z00m128/kay1024/firmware/power-manager/fixed/sources/read_me.txt

Небольшой фикс прошивки KAY Power Manager.

Я нашел и вроде, локализовал проблему, когда иногда комп вырубался сразу, а не после определенной
задержки (~4 сек.). Так же, нашел причину нек. не стабильности в работе этого узла.
Обращаю внимание на уточненные номиналы резисторов R90...R92(см. обновленную схему):
R90, R91 - 470 Ом ... 680 Ом
R92 - 2,2 кОм ... 3,3 кОм
