z00m128/kay1024/firmware/power-manager/original/hex/read_me.txt

Краткое описание прошивок

default.hex   - время ожидания Pwr_OK при включении - 350 мс, выкл. - удержание кнопки ~3,5 сек

default2.hex  - время ожидания Pwr_OK при включении - 500 мс, выкл. - удержание кнопки ~3,5 сек

ext_350_2.hex - время ожидания Pwr_OK при включении - 350 мс, выкл. - удержание кнопки ~2 сек

ext_500_2.hex - время ожидания Pwr_OK при включении - 500 мс, выкл. - удержание кнопки ~2 сек
