z00m128/kay1024/schematic-diagram/kay1024_schematic_black_cat.png

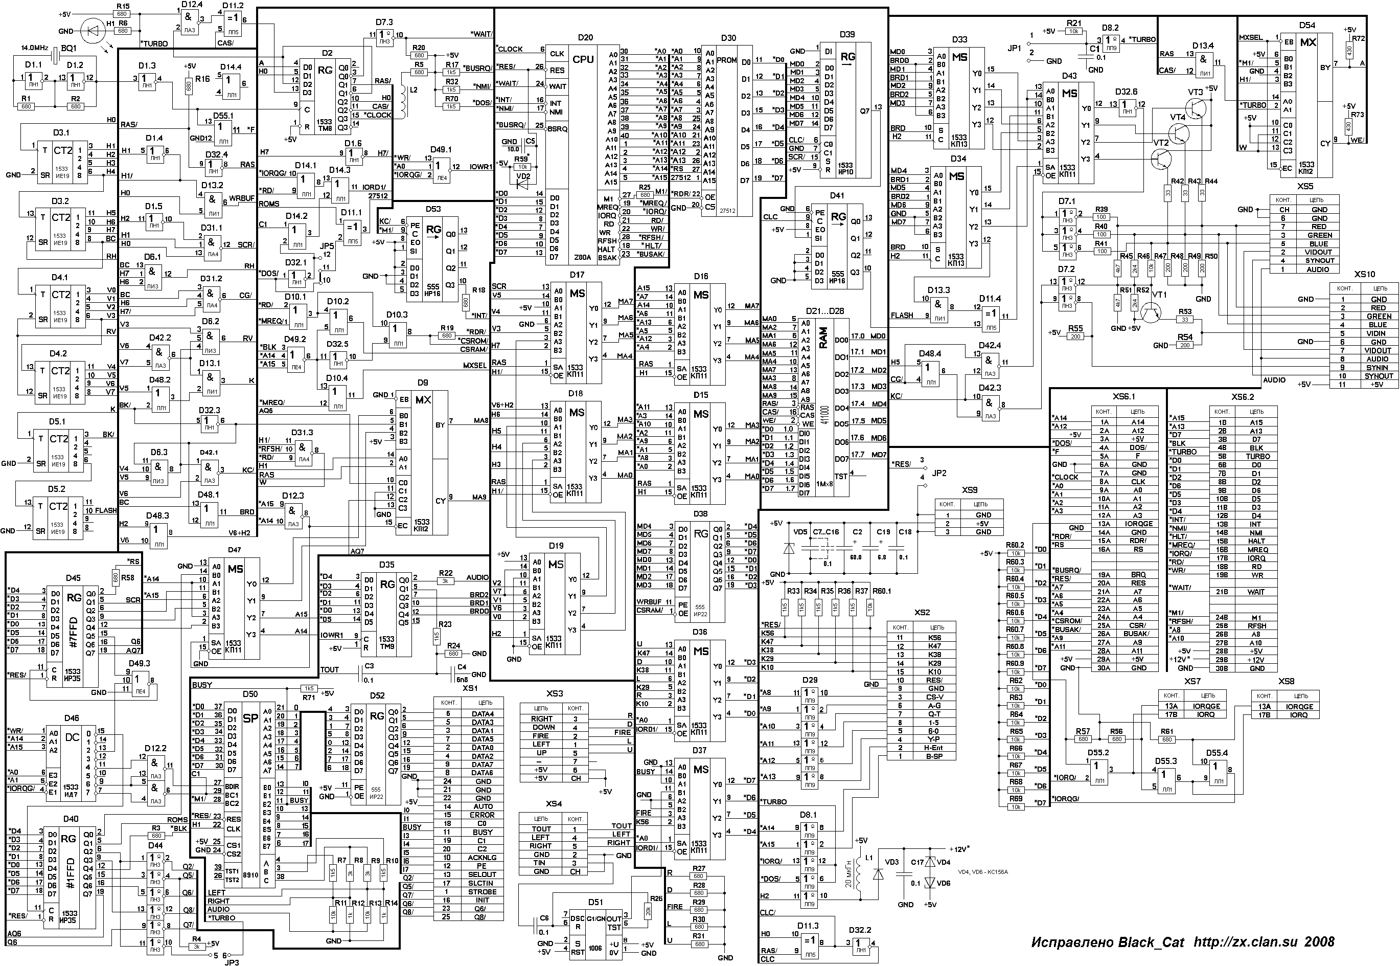
schematic-diagram/kay1024_schematic_black_cat.png
