z00m128/kay1024/schematic-diagram/kay1024_schematic_zan.png

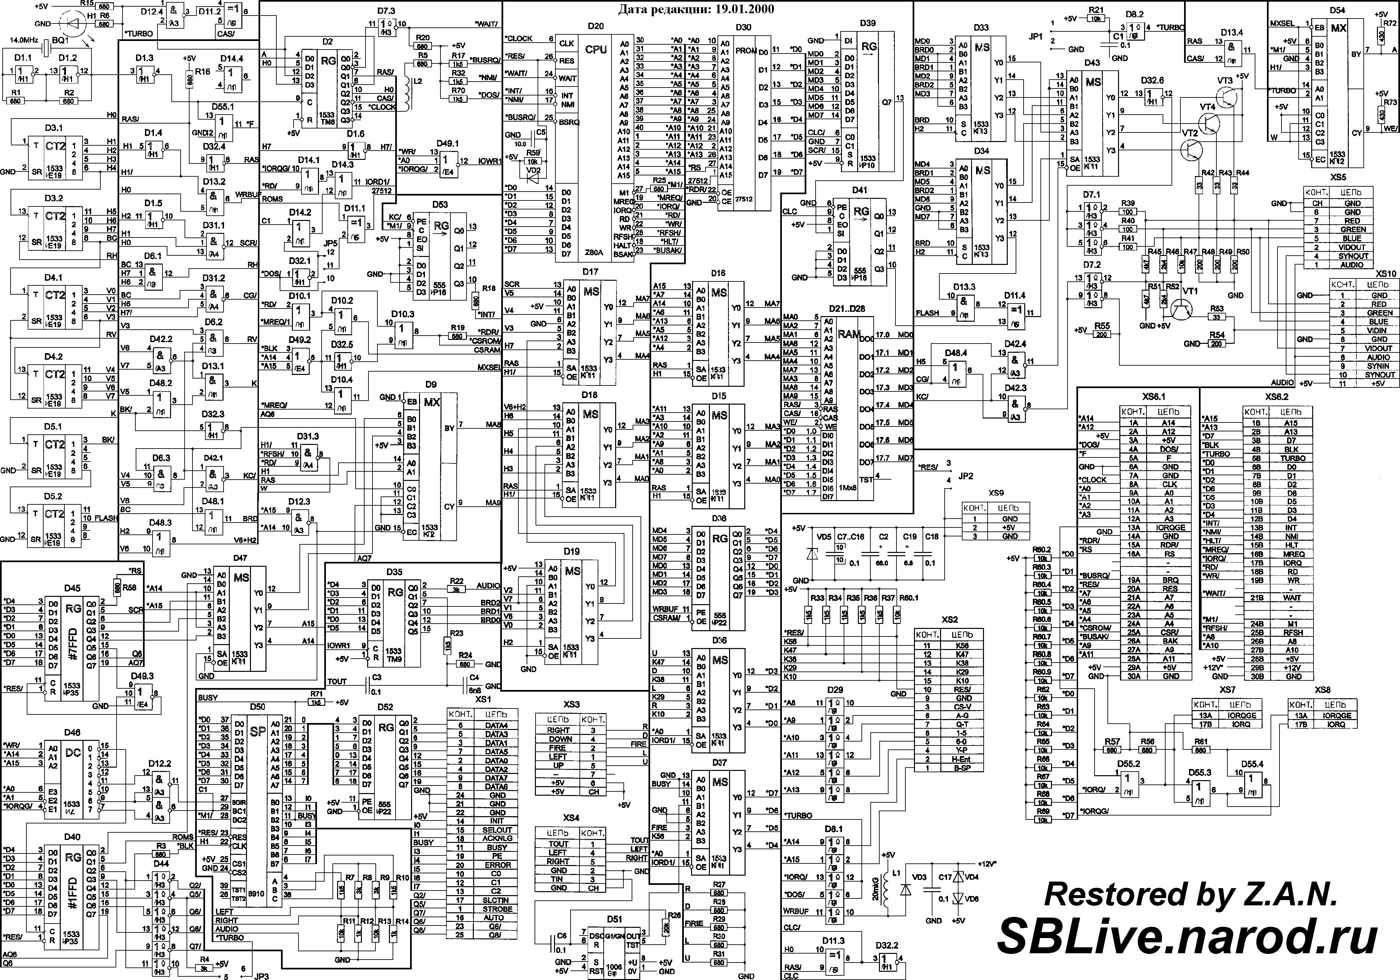
schematic-diagram/kay1024_schematic_zan.png
