z00m128/kay1024/docs/kay10243sl_manual.pdf

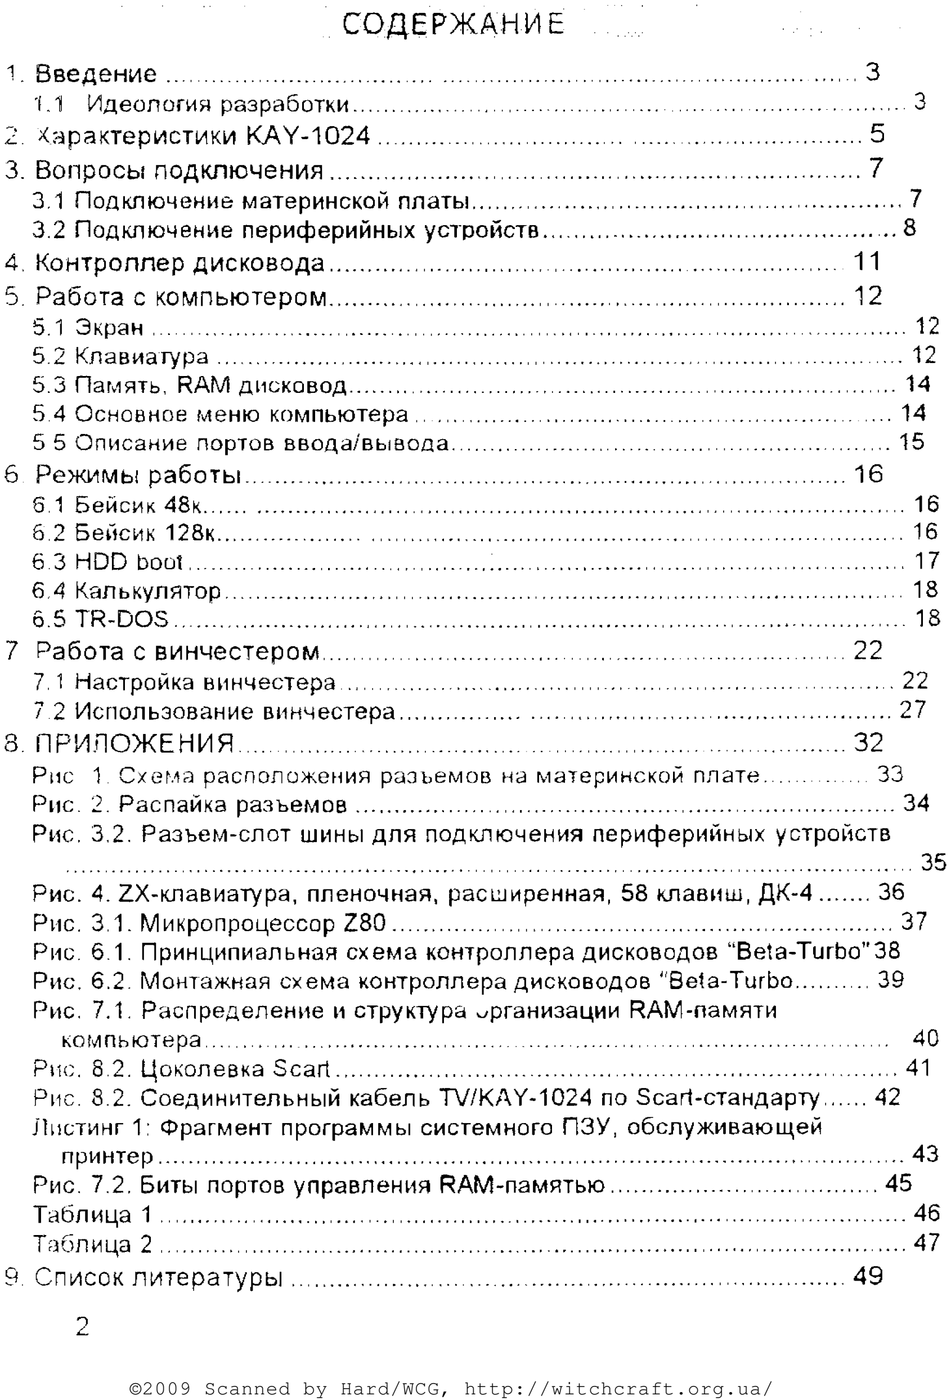
[picture p3: page 1]

©2009 Scanned by Hard/WCG, http://witchcraft.org.ua/

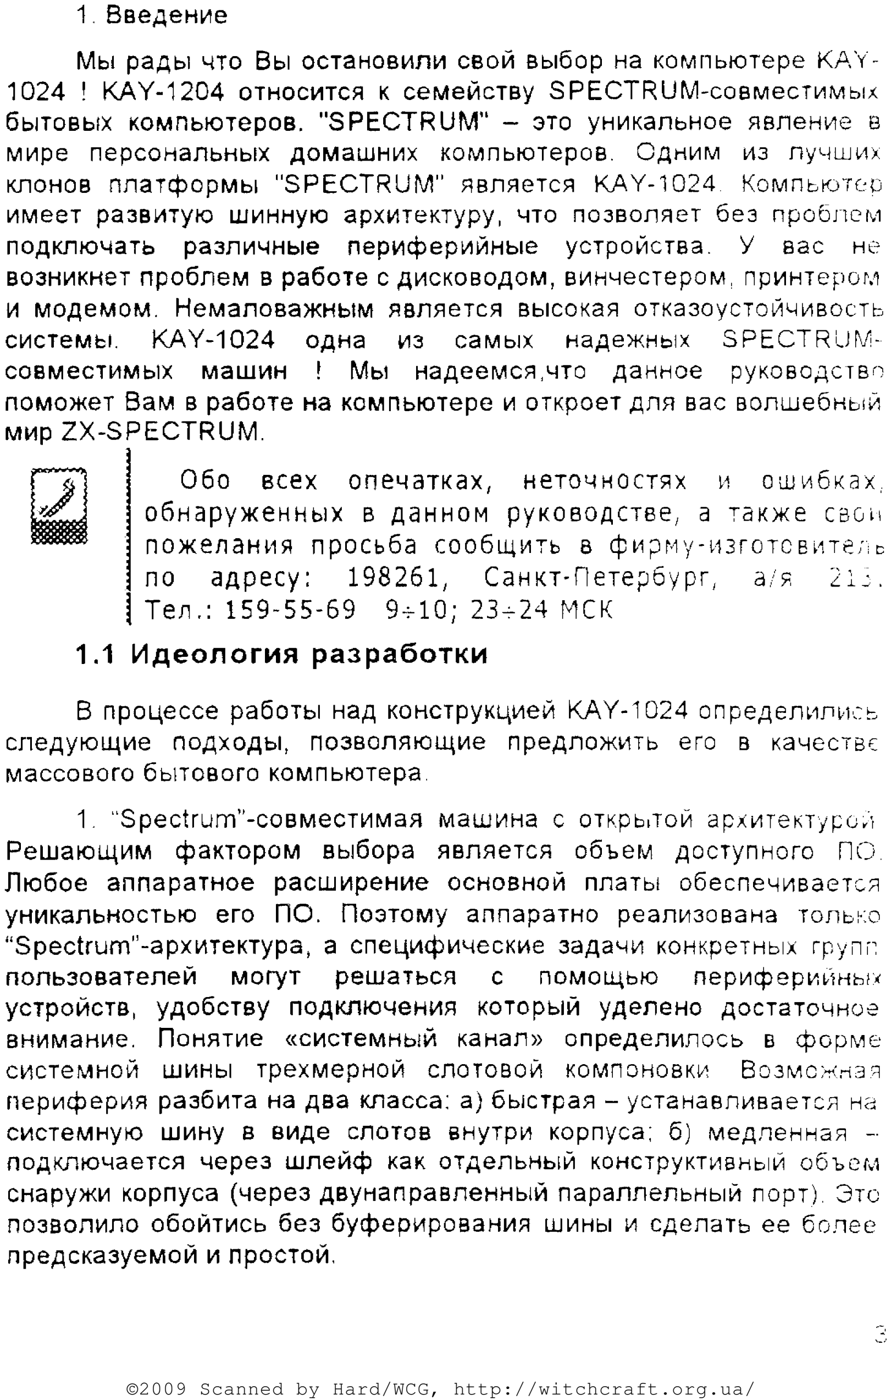
[picture p4: page 2]
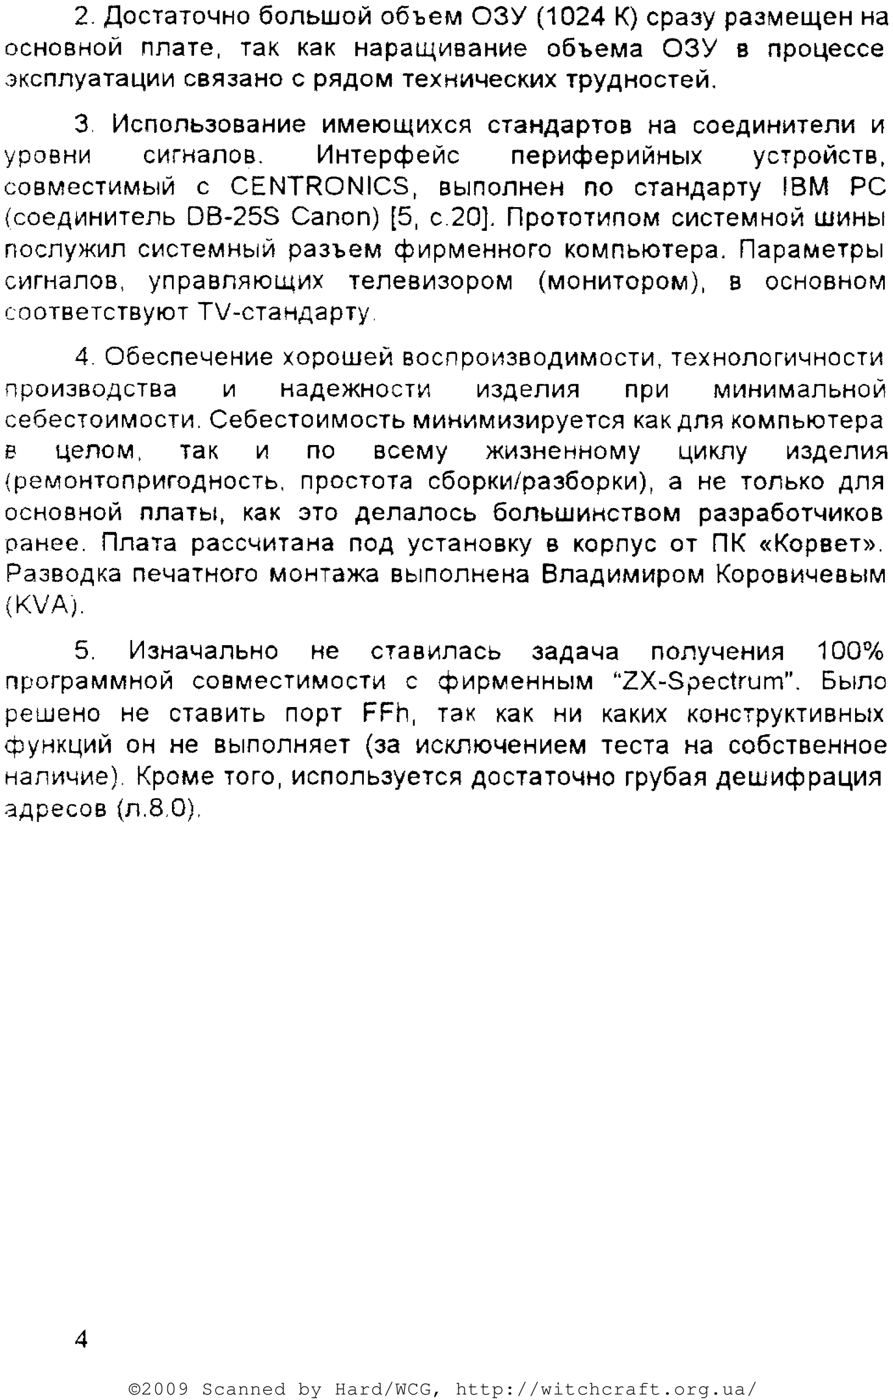
[picture p5: page 3]
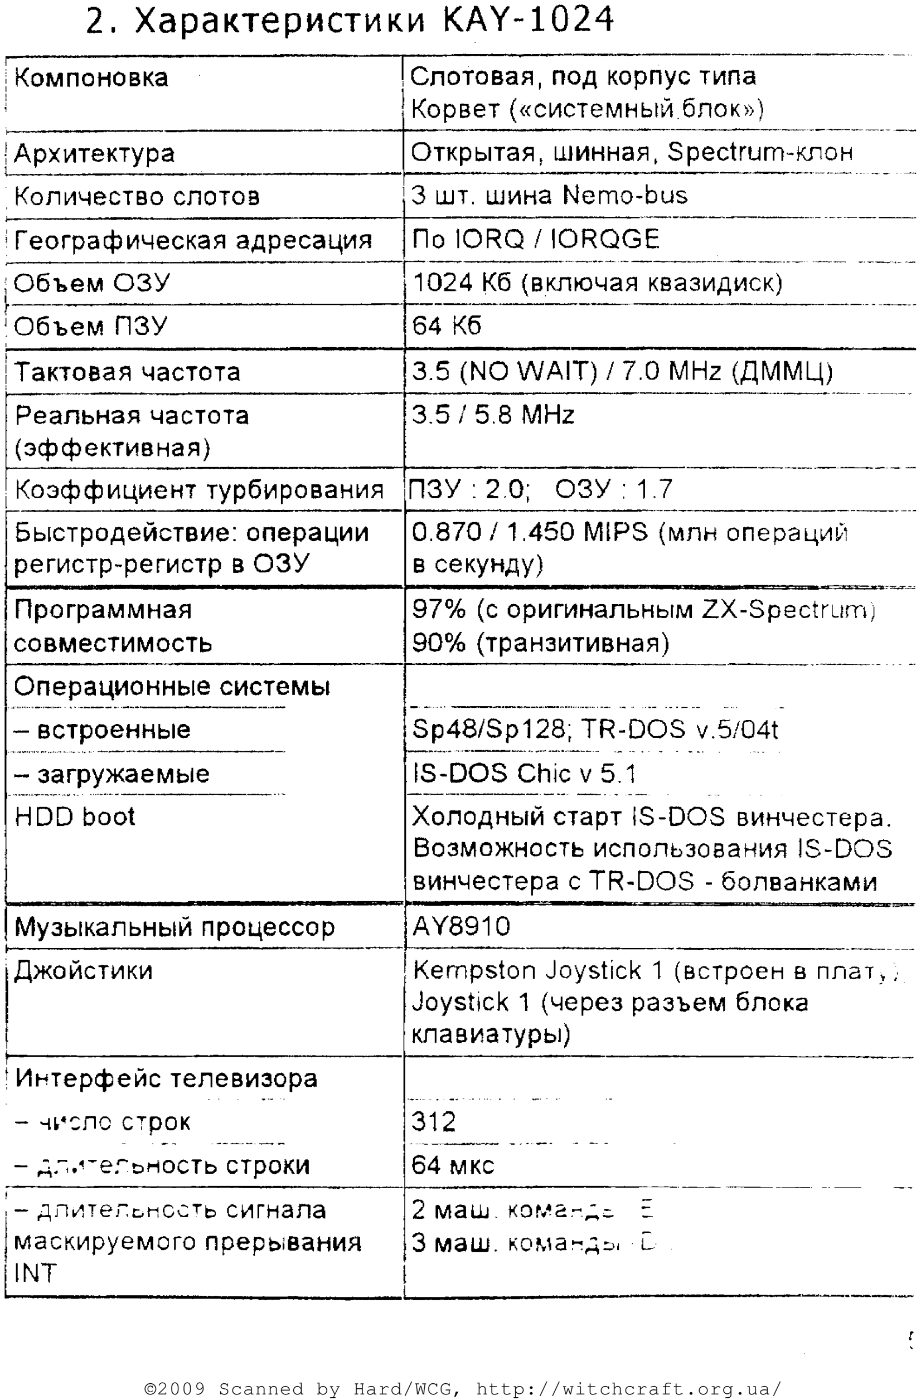
[picture p6: page 4]
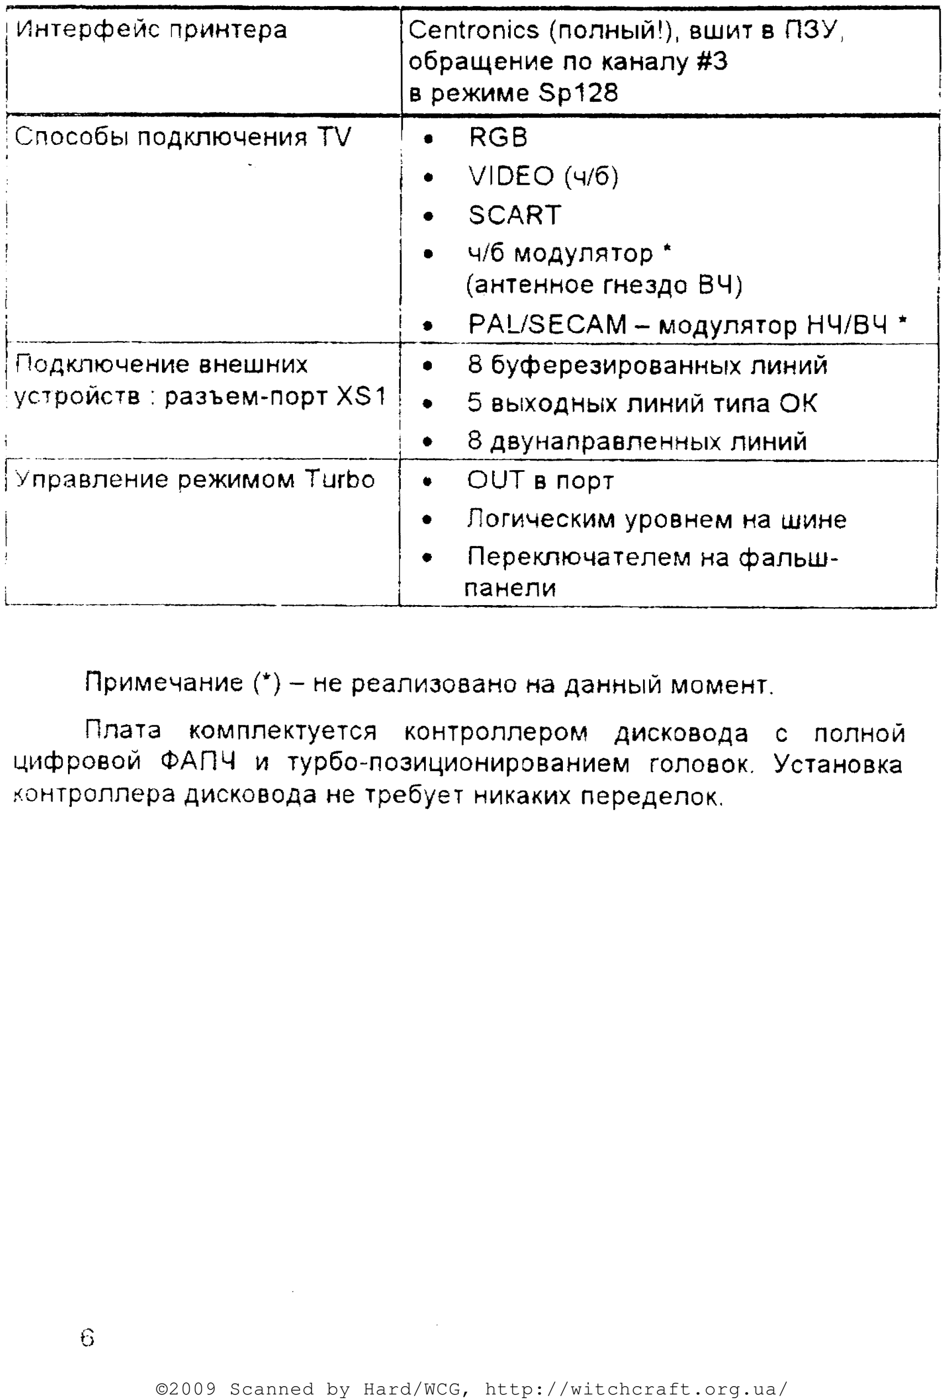
[picture p7: page 5]
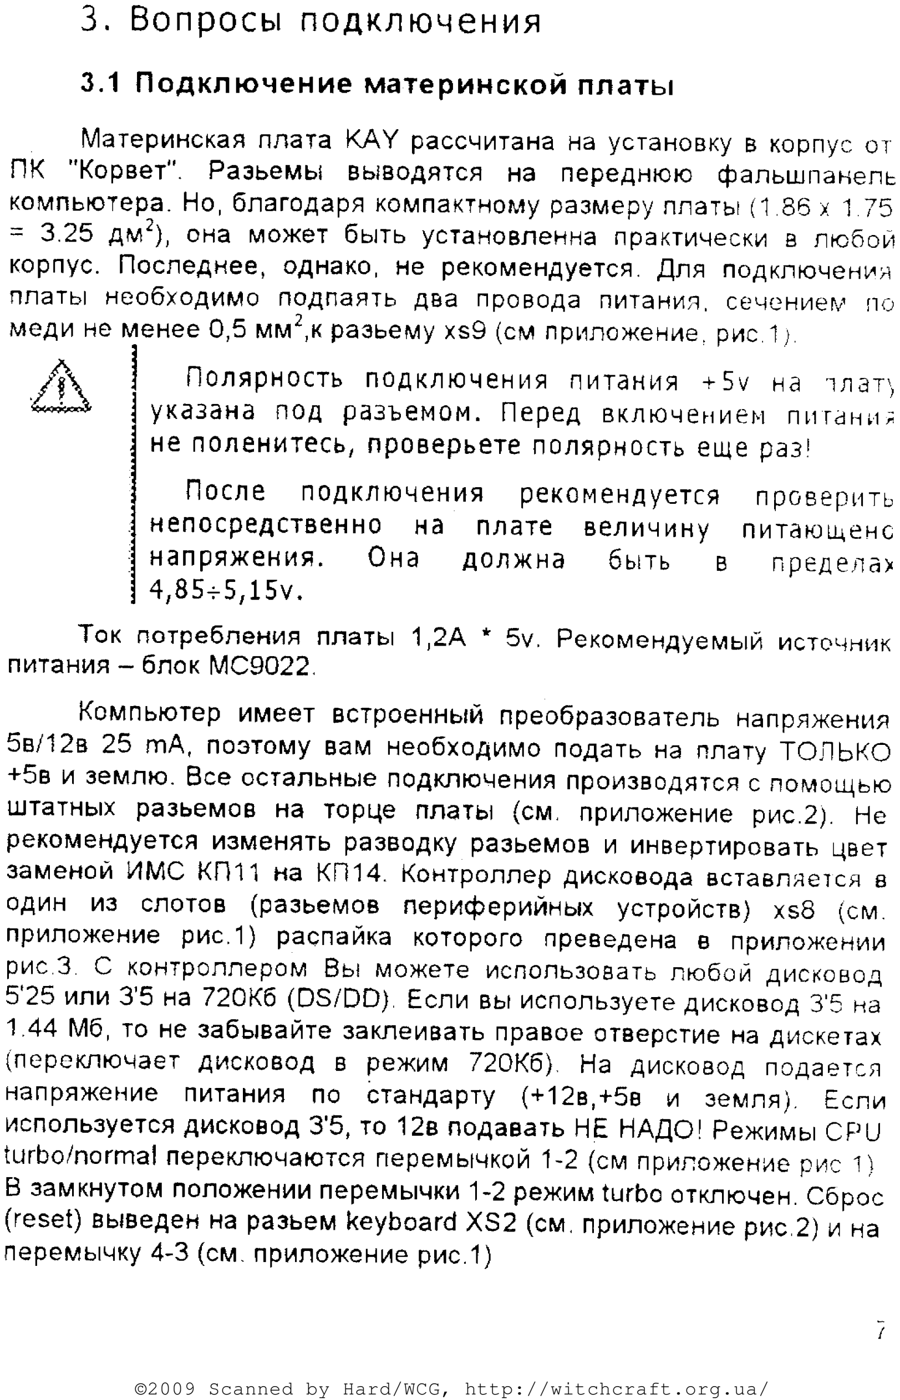
[picture p8: page 6]
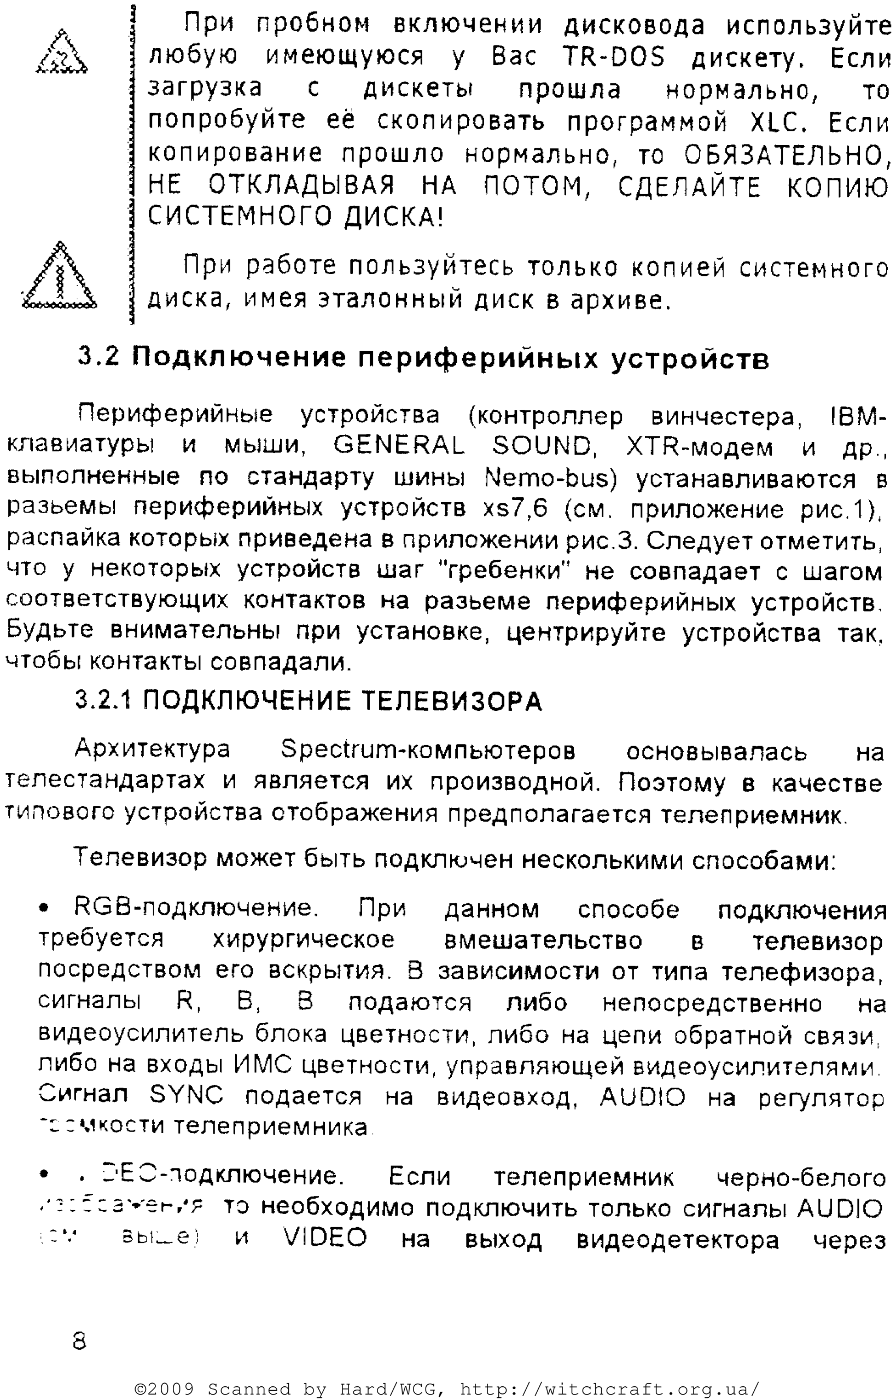
[picture p9: page 7]
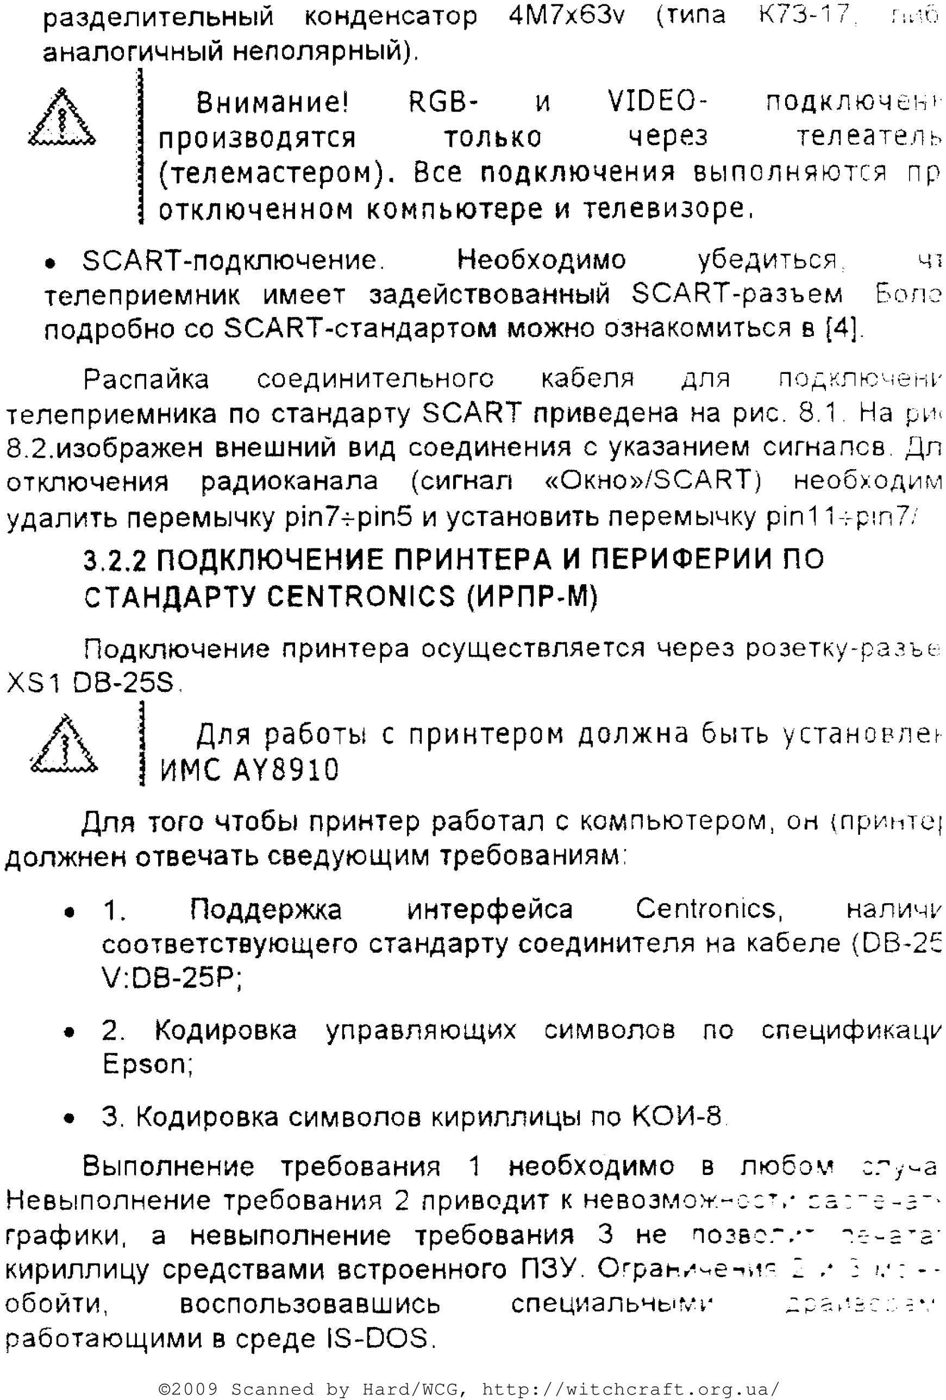
[picture p10: page 8]
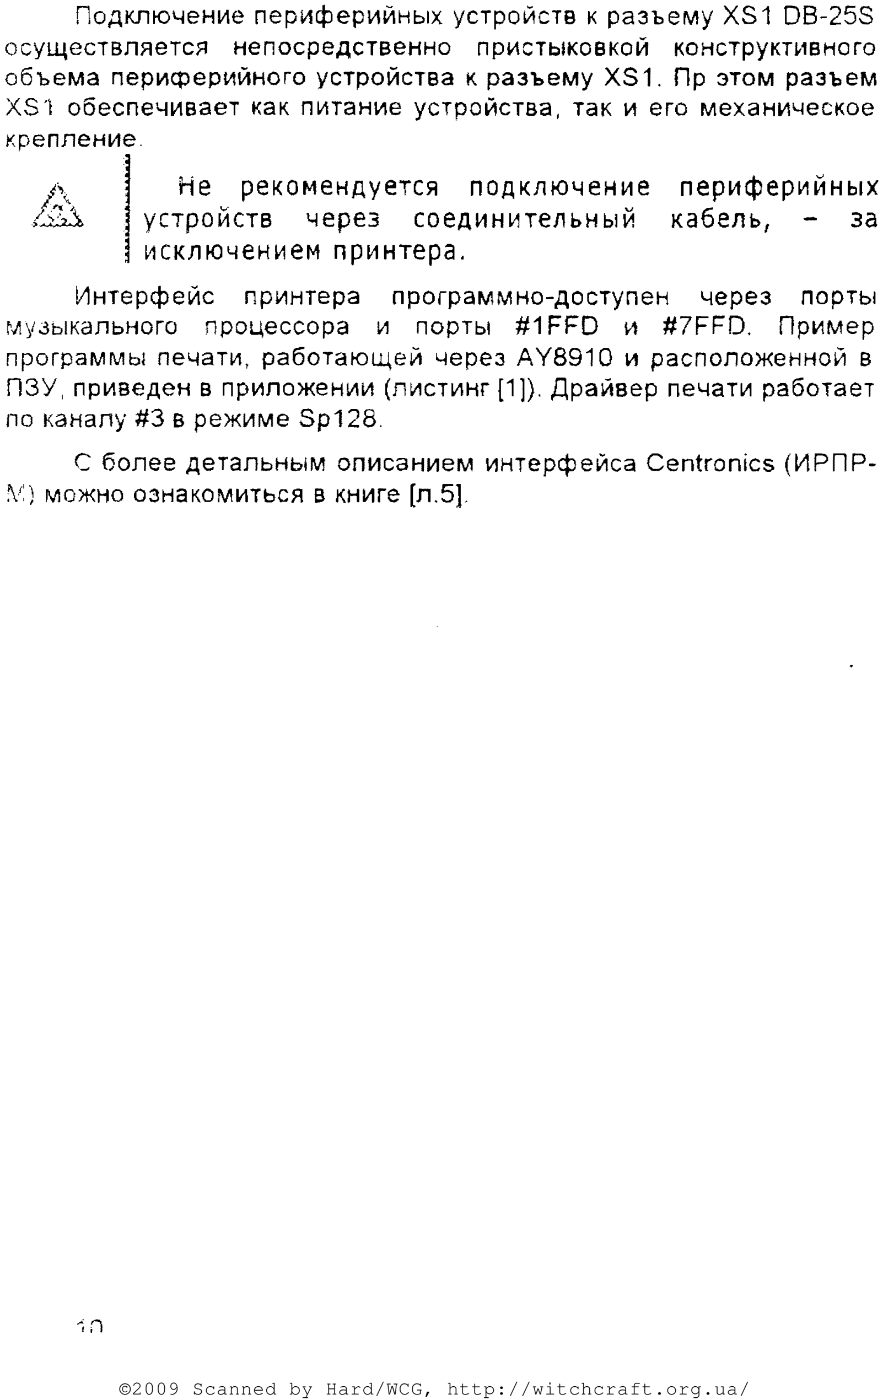
[picture p11: page 9]
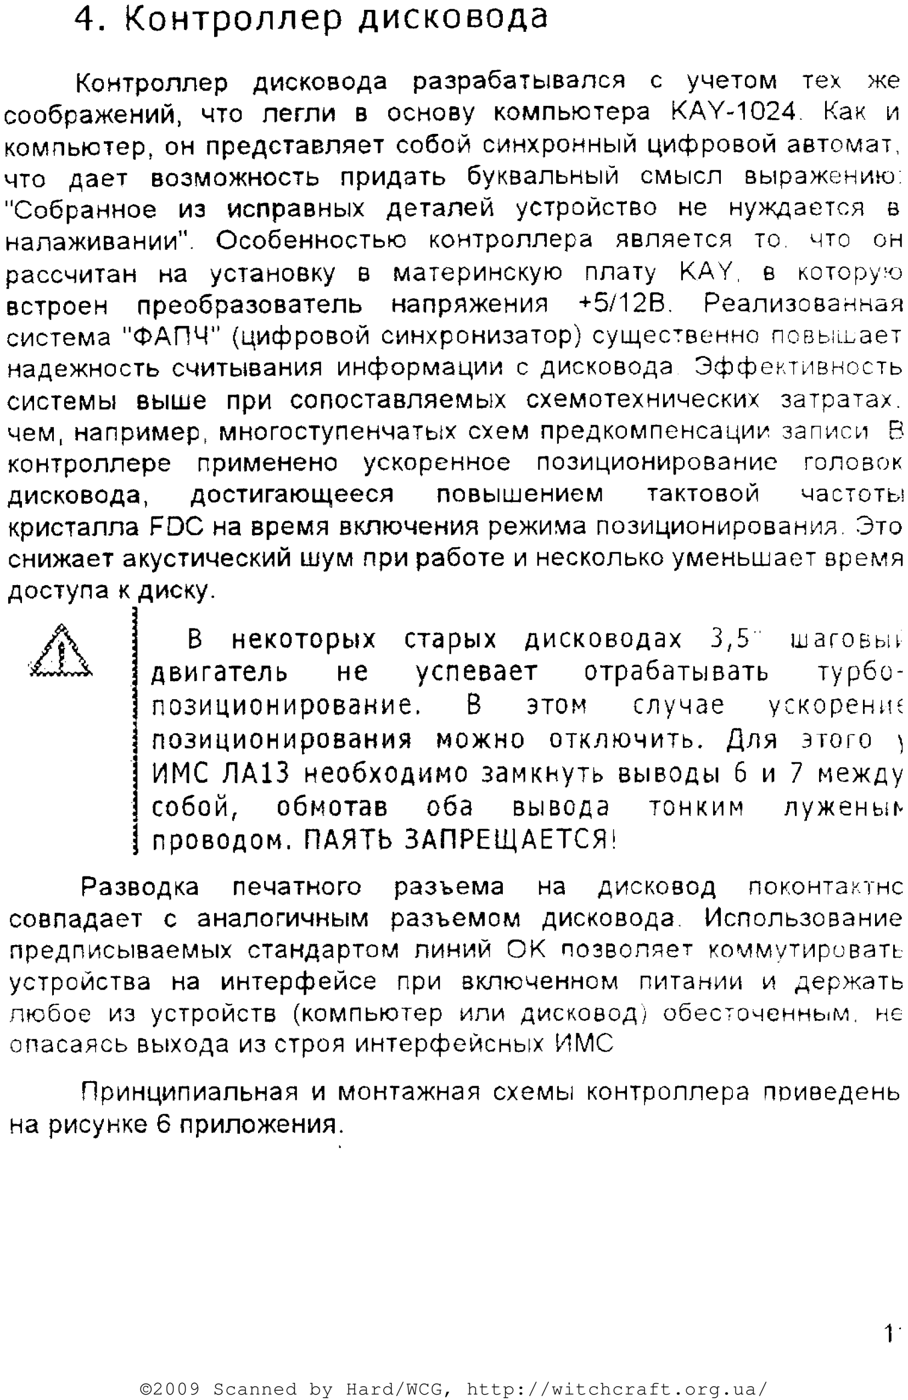
[picture p12: page 10]
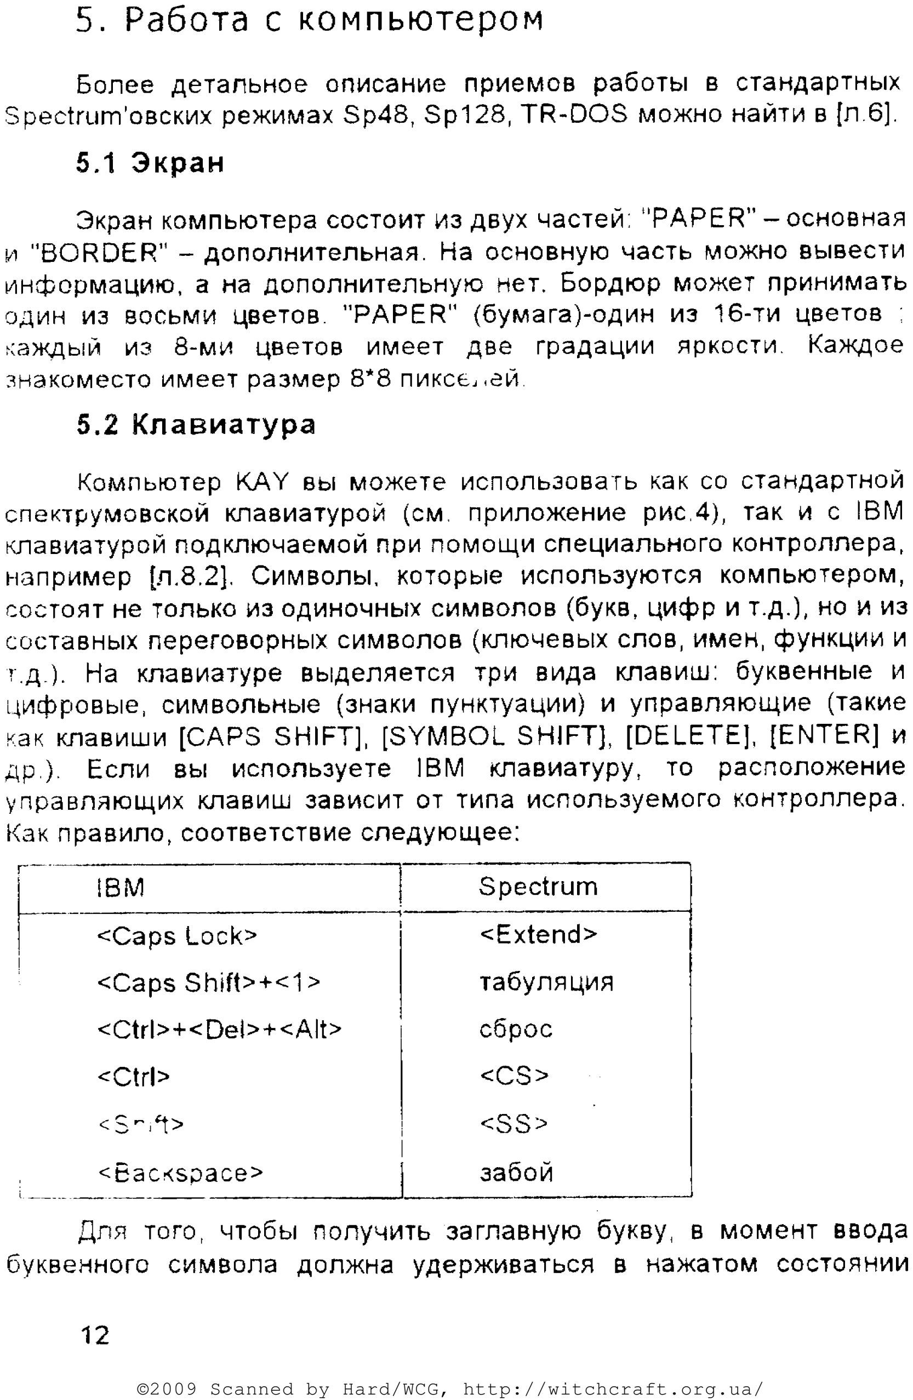
[picture p13: page 11]
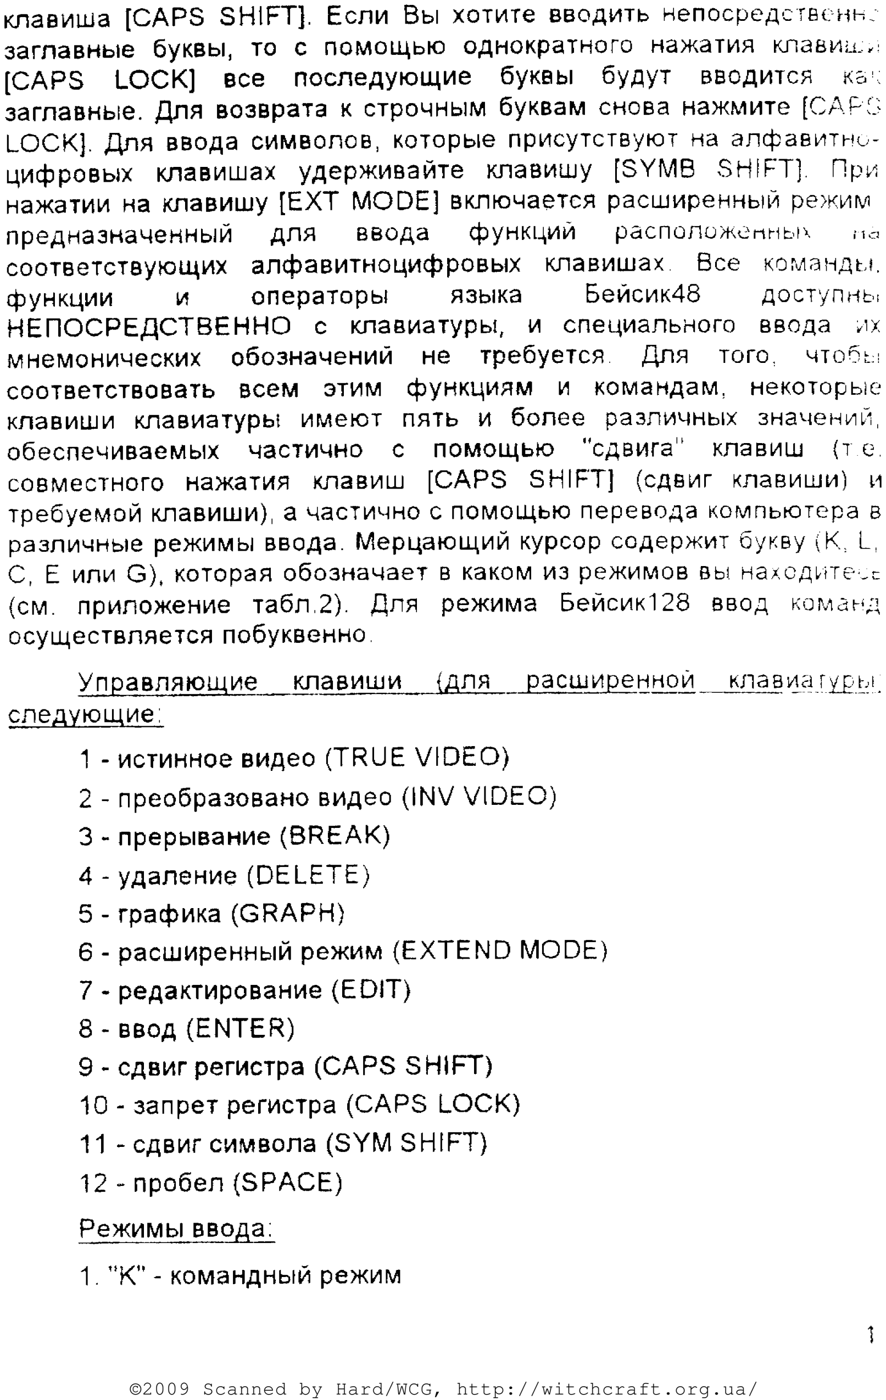
[picture p14: page 12]
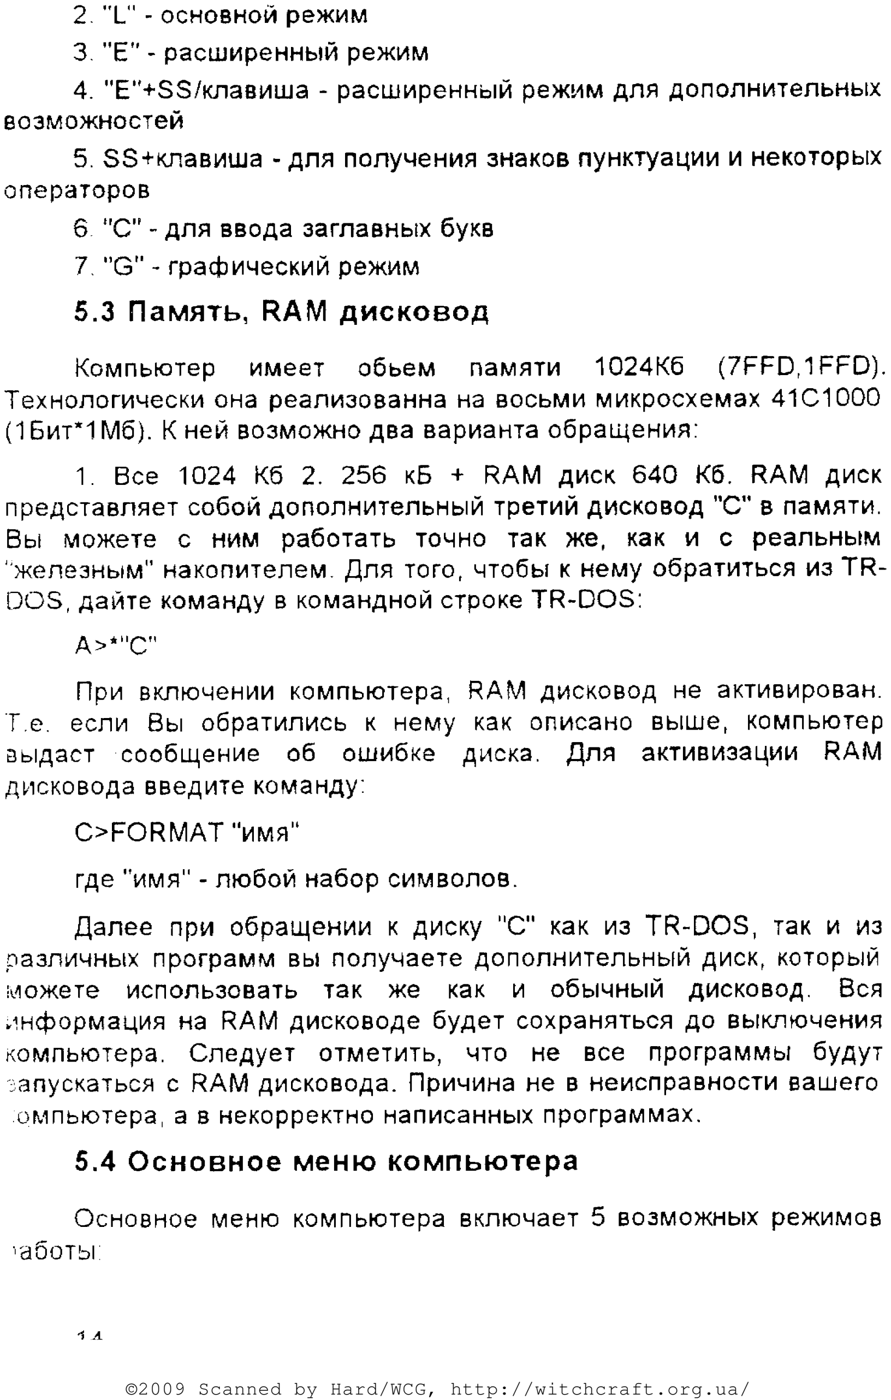
[picture p15: page 13]
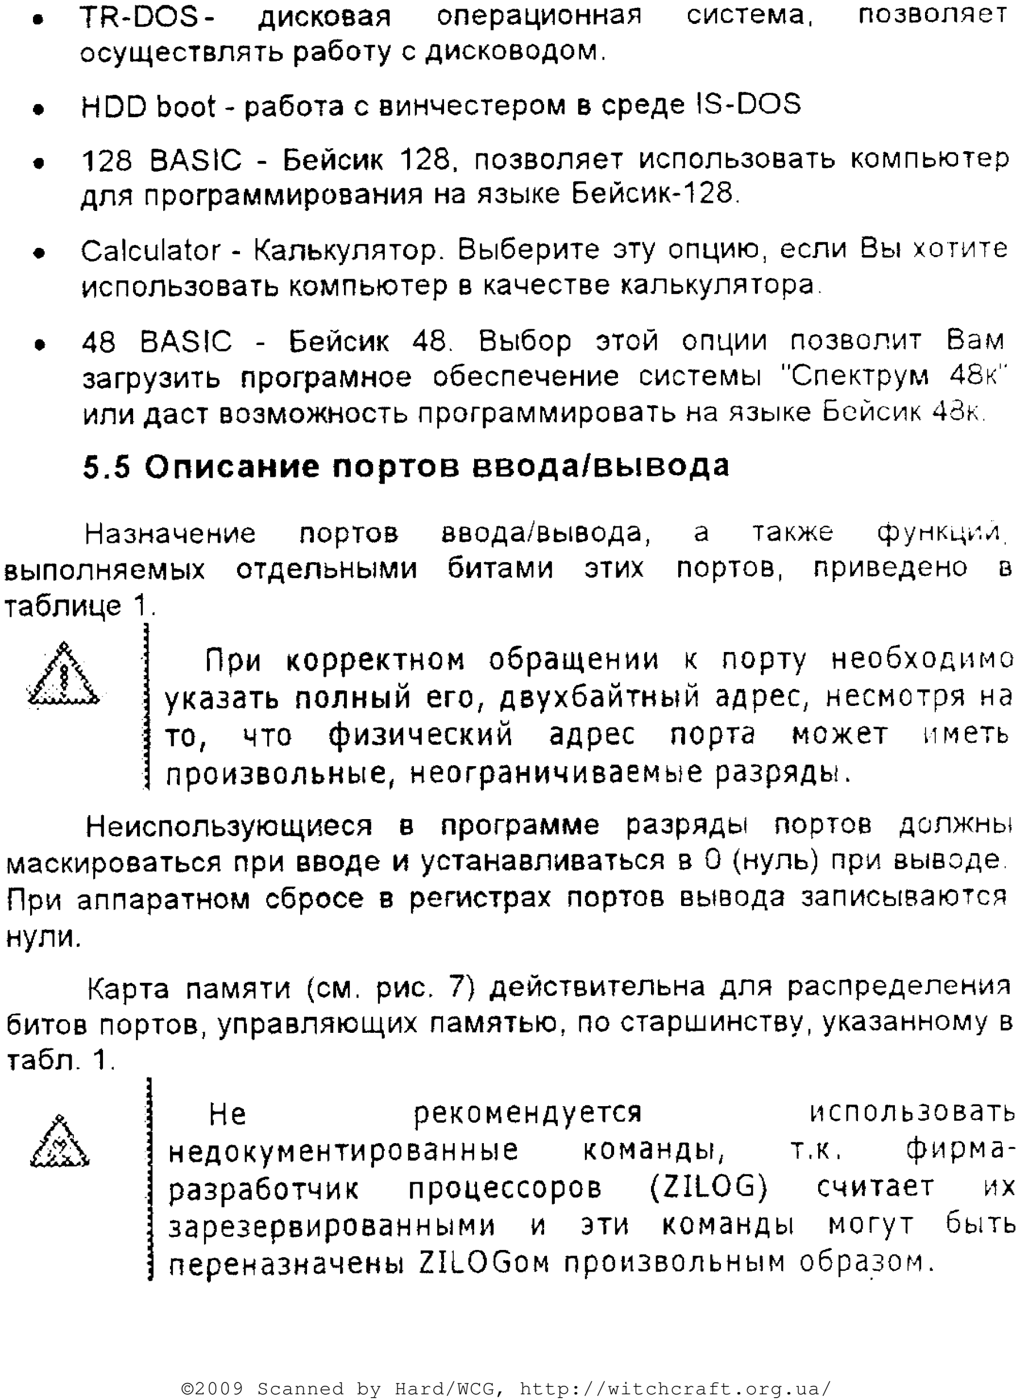
[picture p16: page 14]
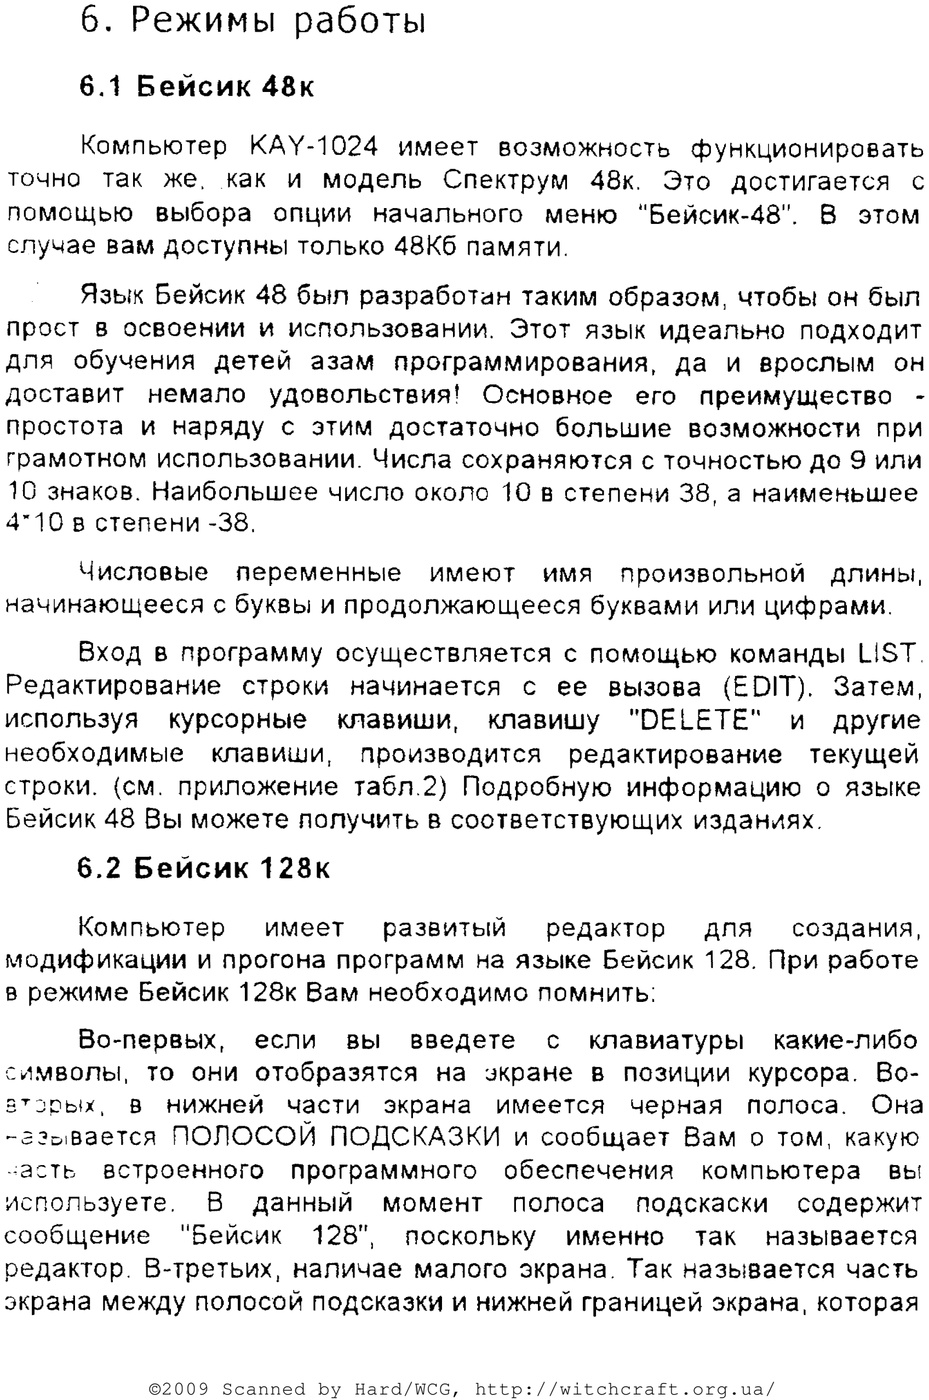
[picture p17: page 15]
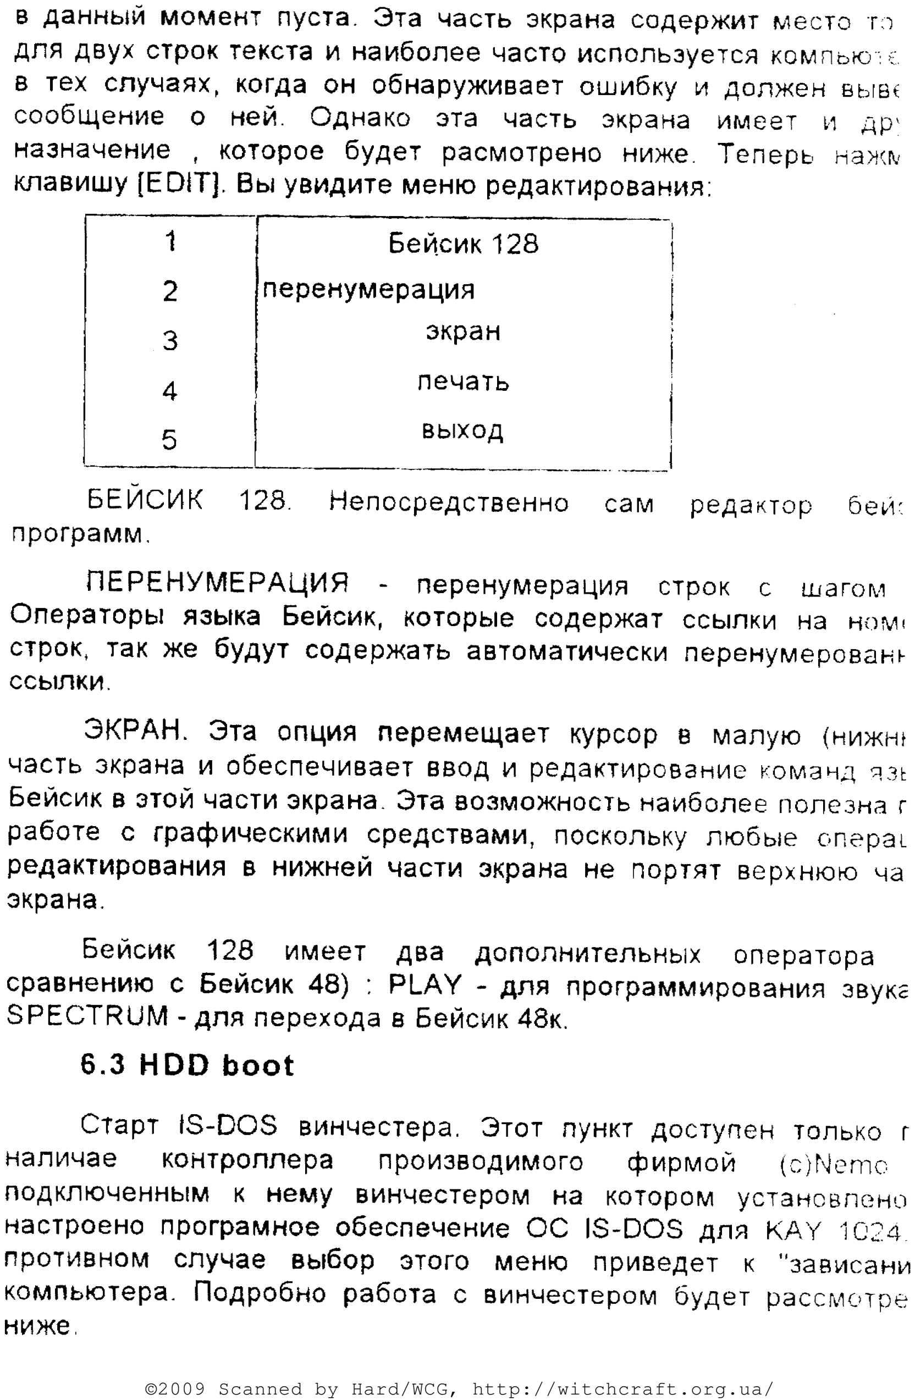
[picture p18: page 16]
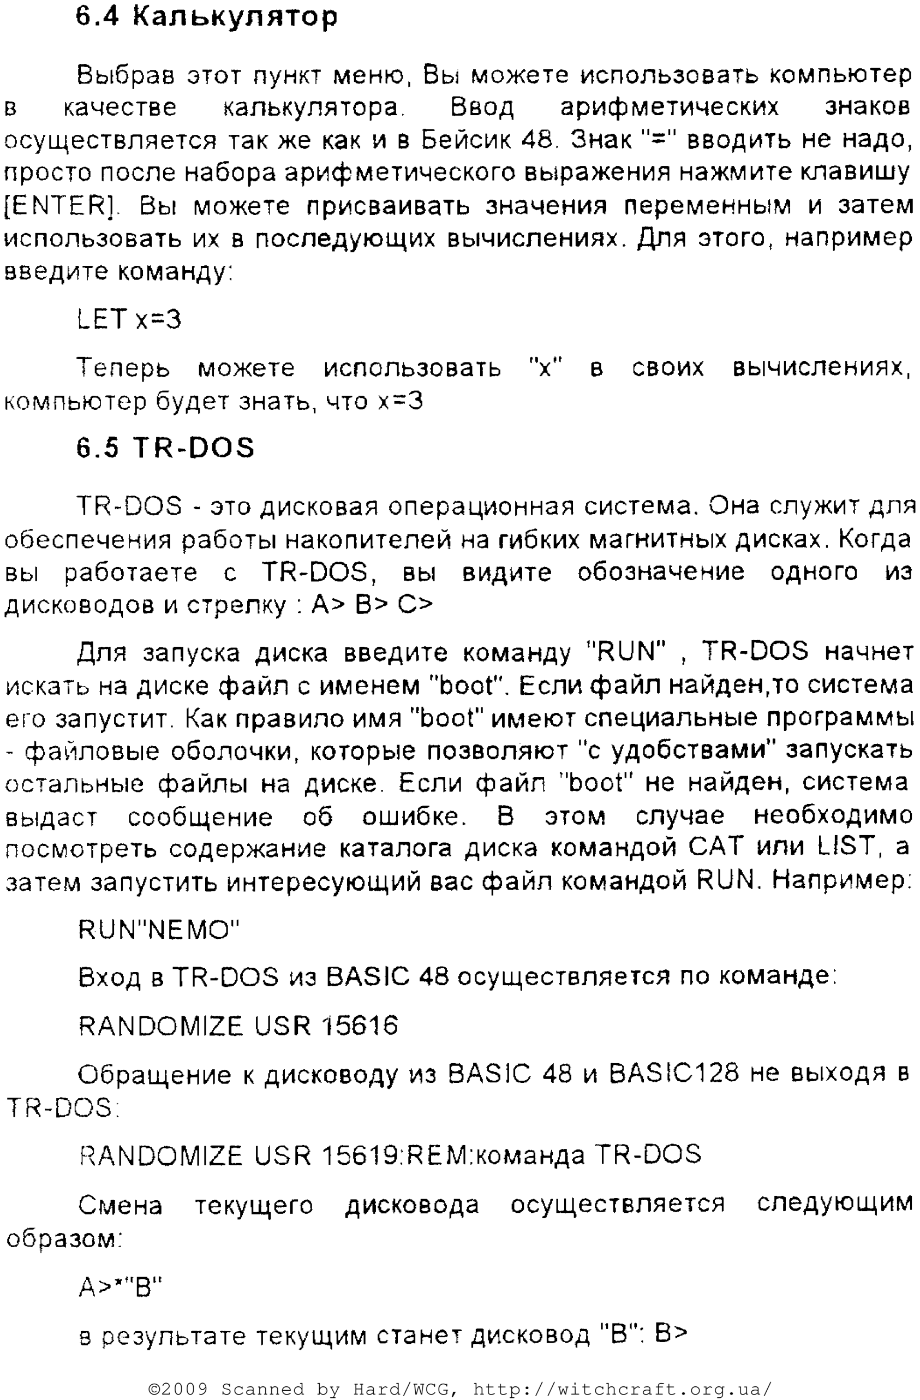
[picture p19: page 17]
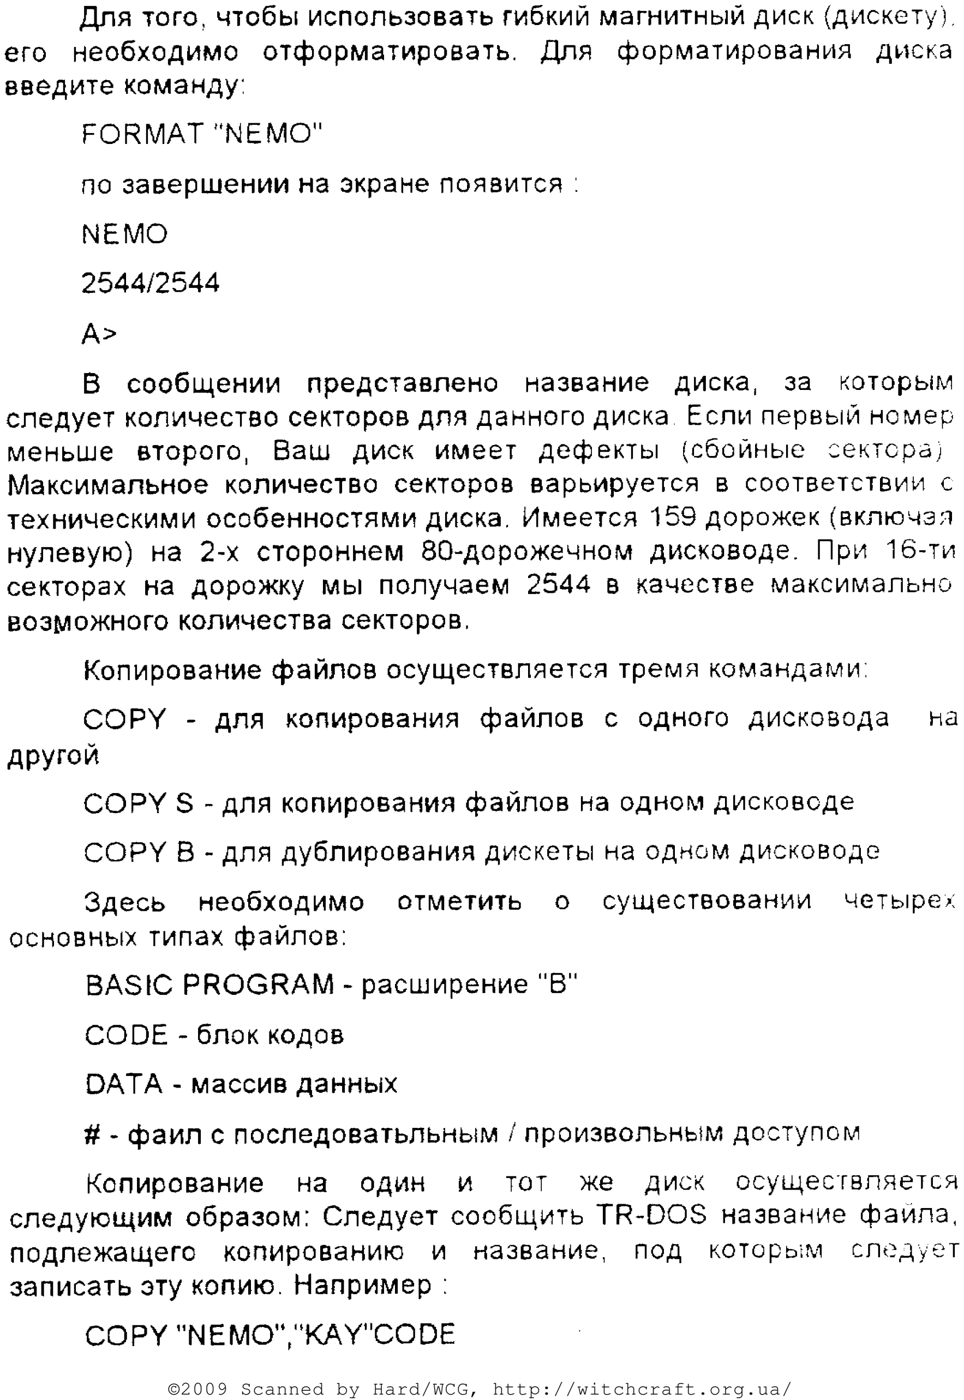
[picture p20: page 18]
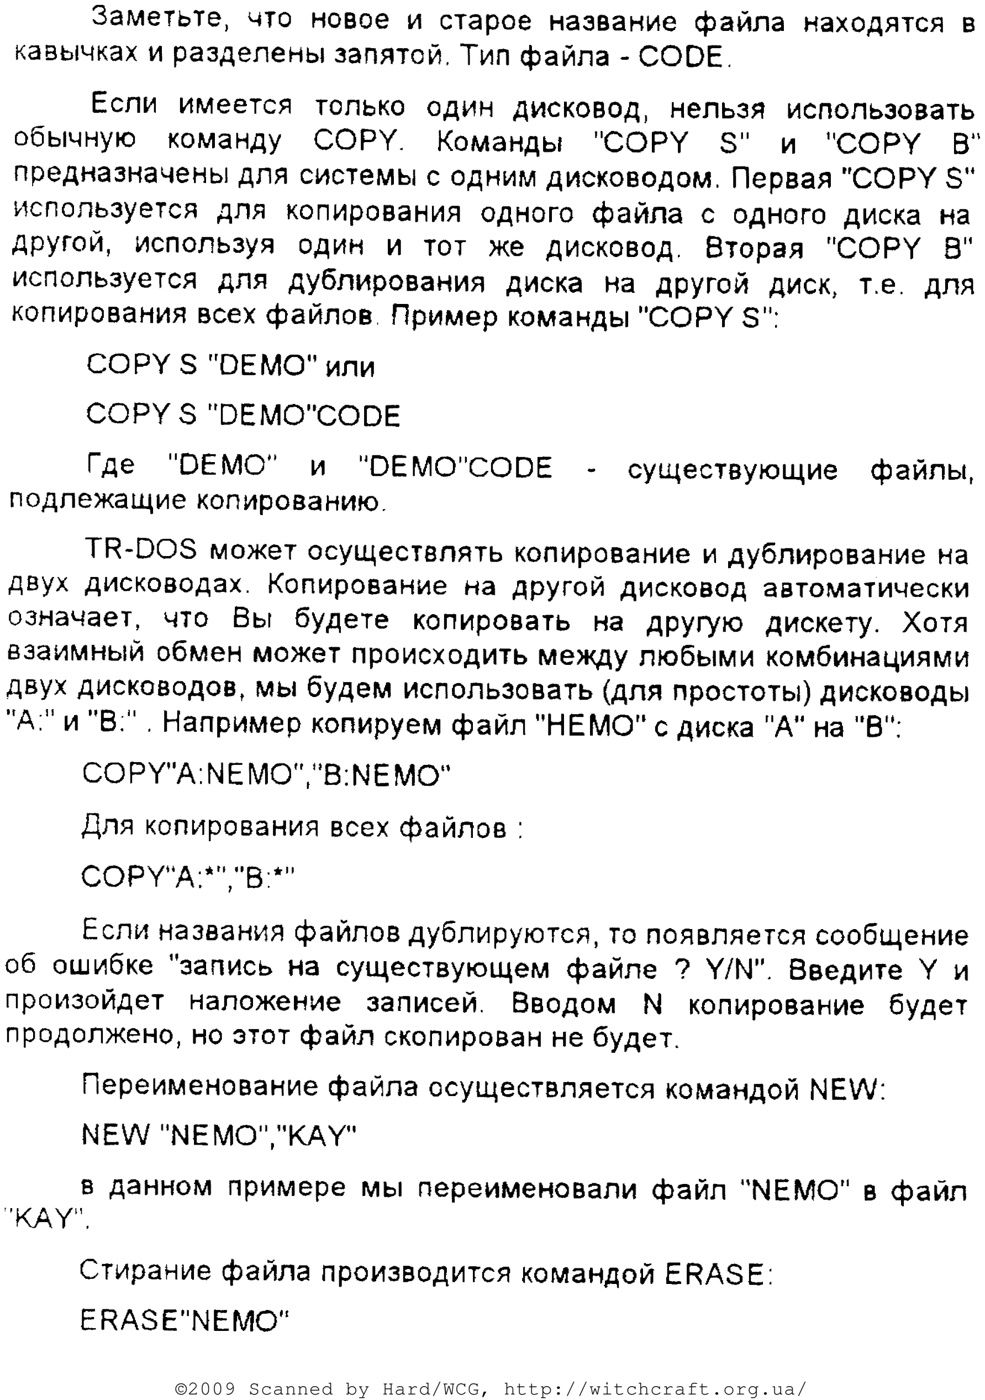
[picture p21: page 19]
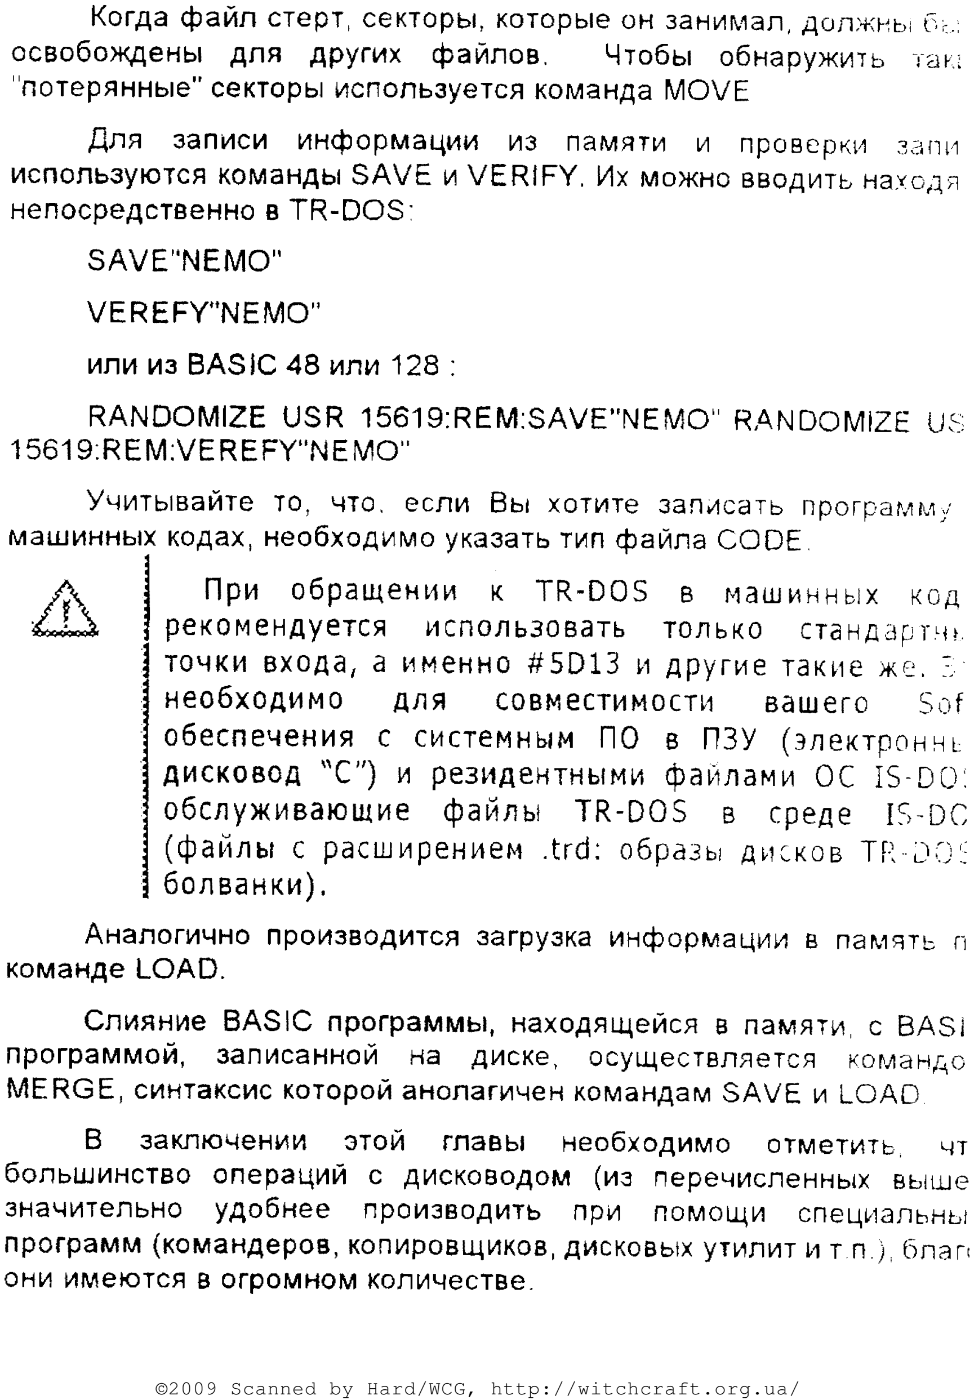
[picture p22: page 20]
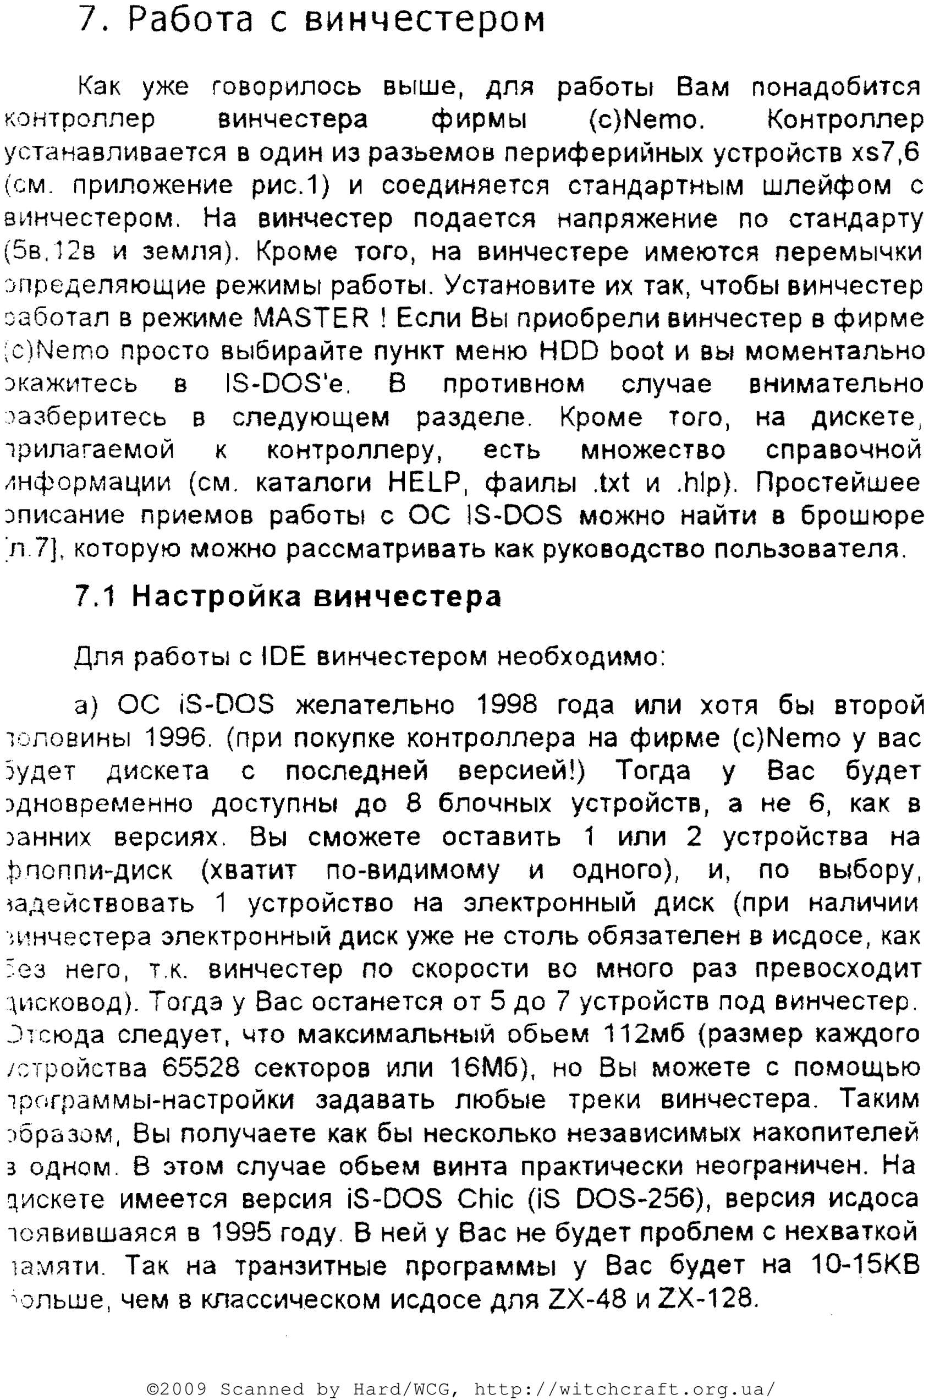
[picture p23: page 21]
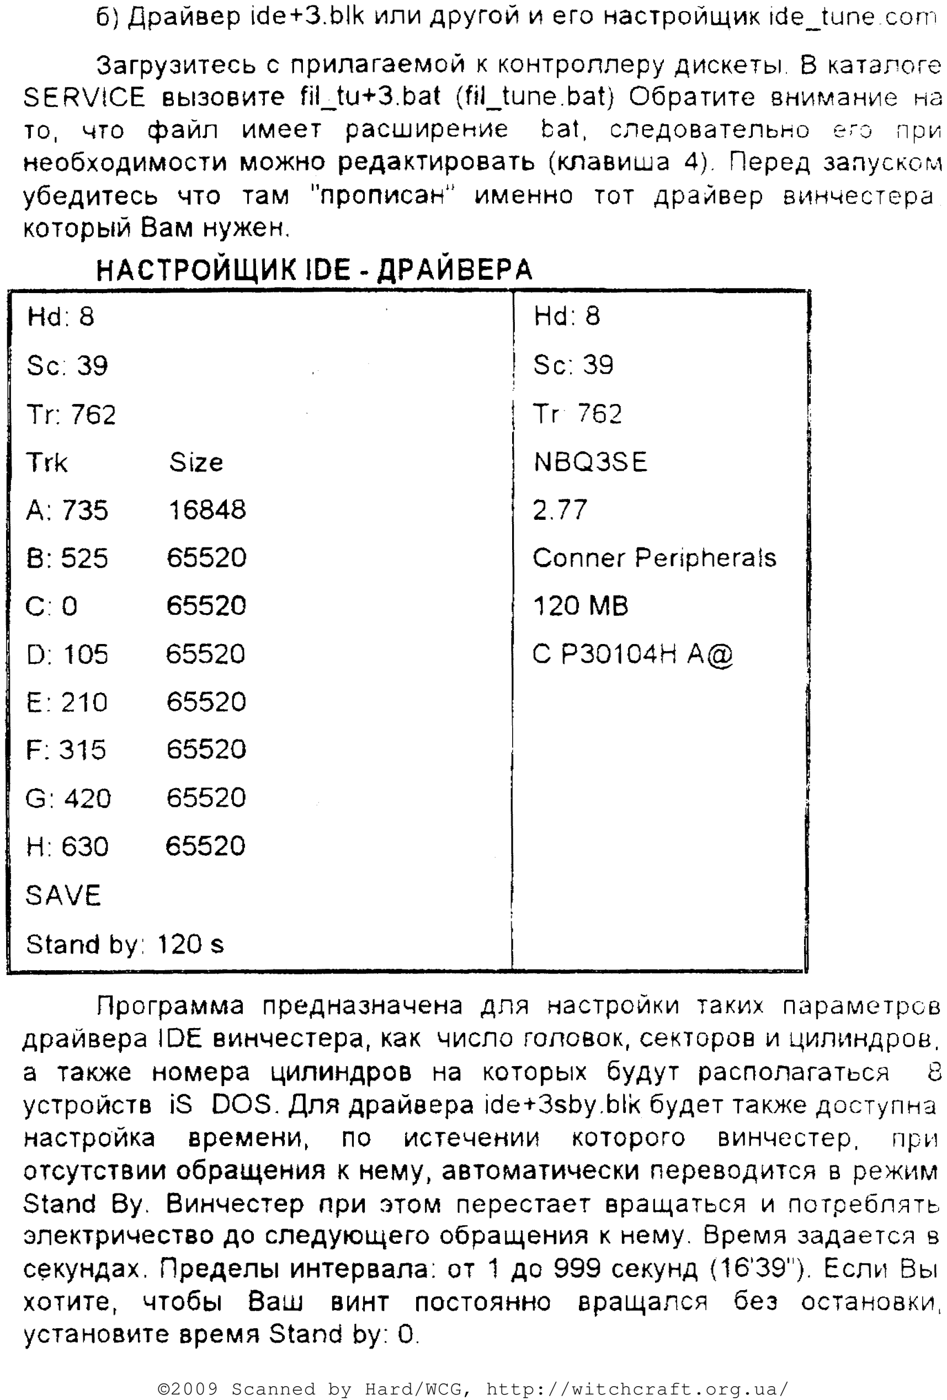
[picture p24: page 22]
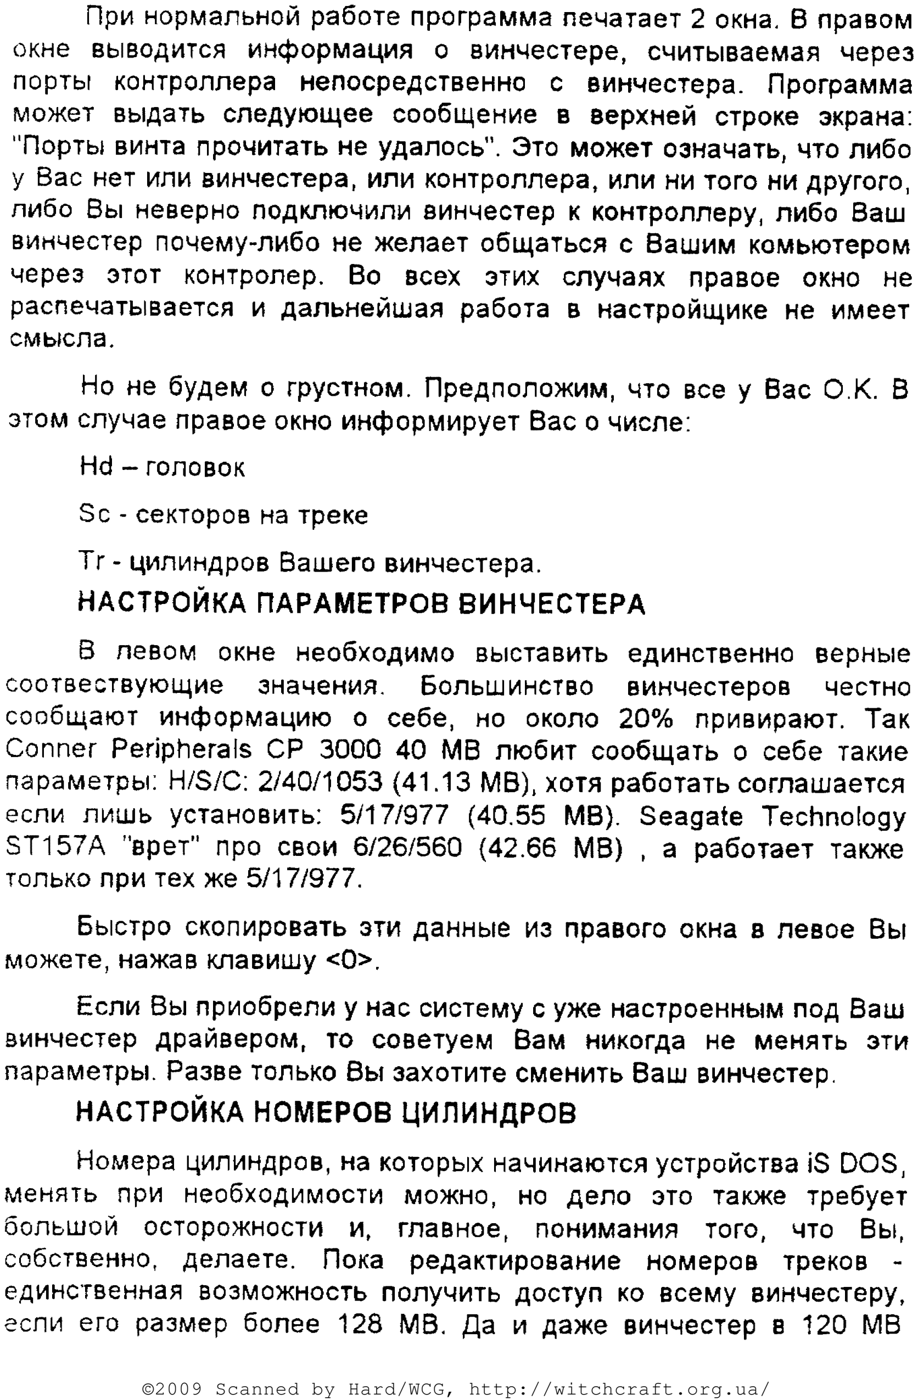
[picture p25: page 23]
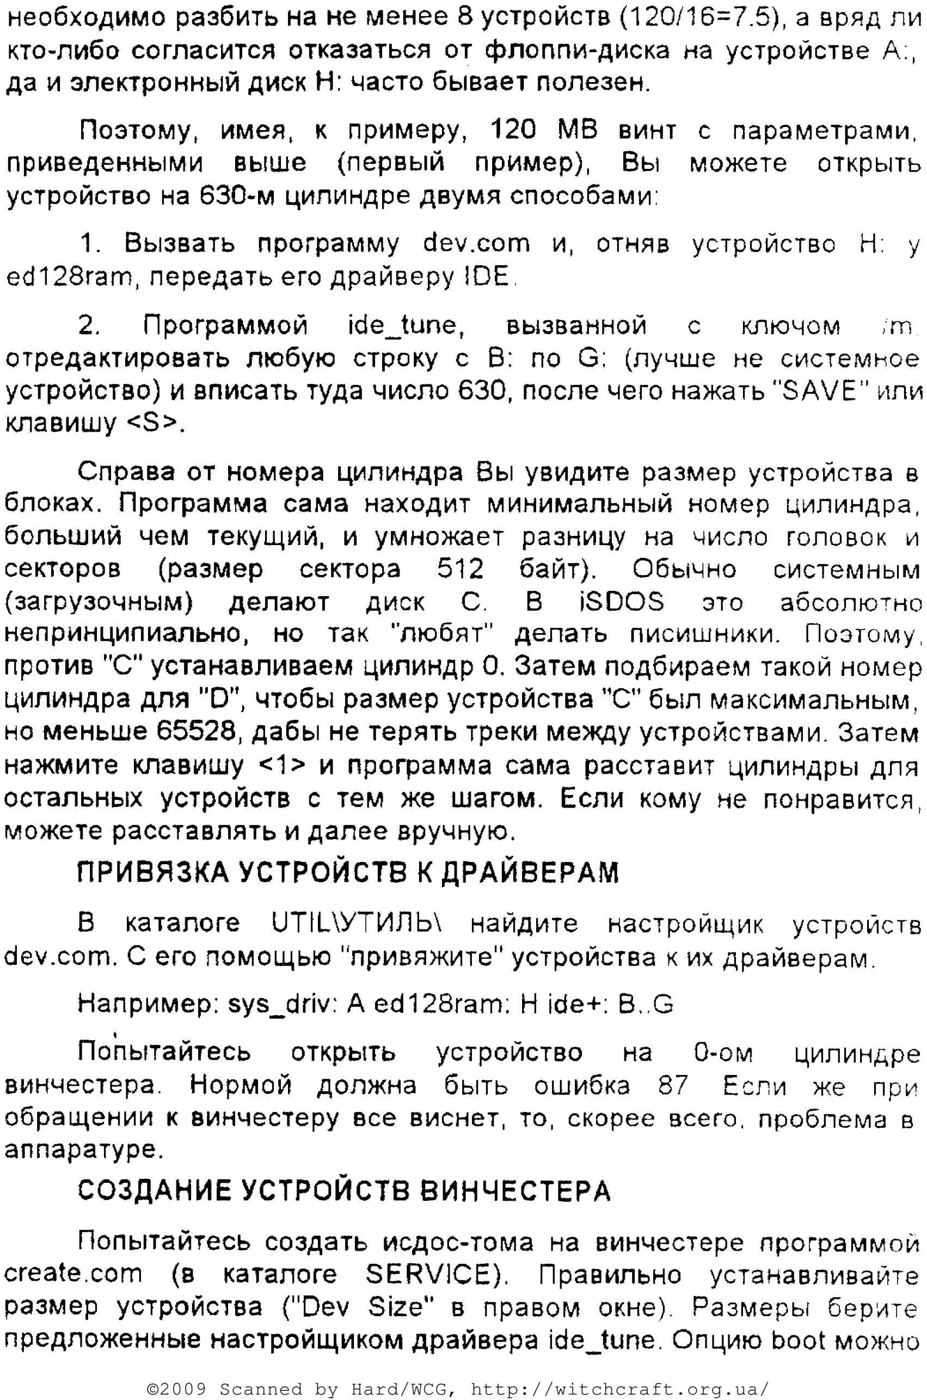
[picture p26: page 24]
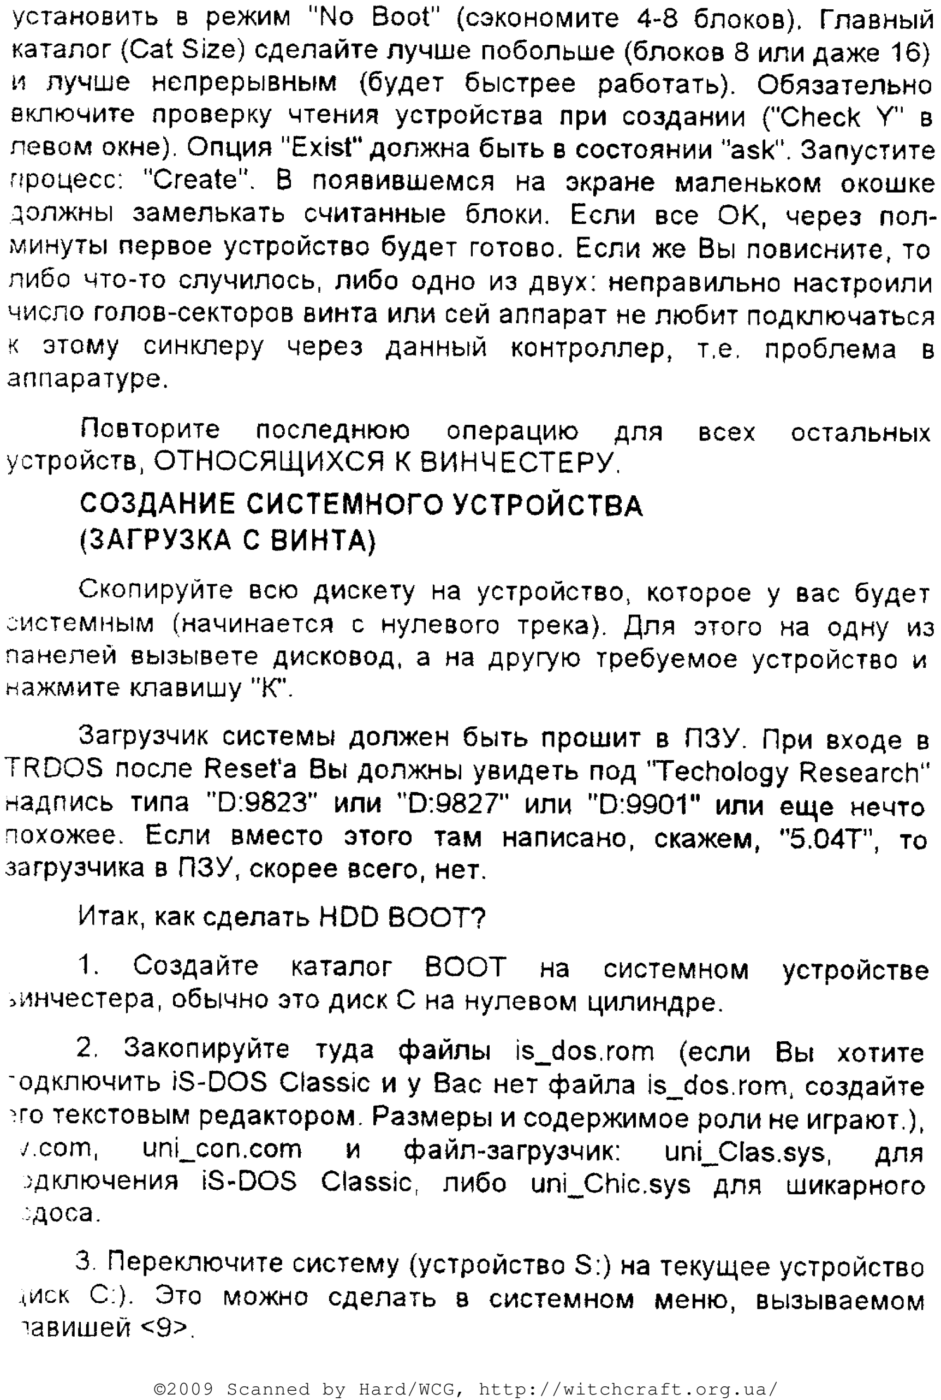
[picture p27: page 25]
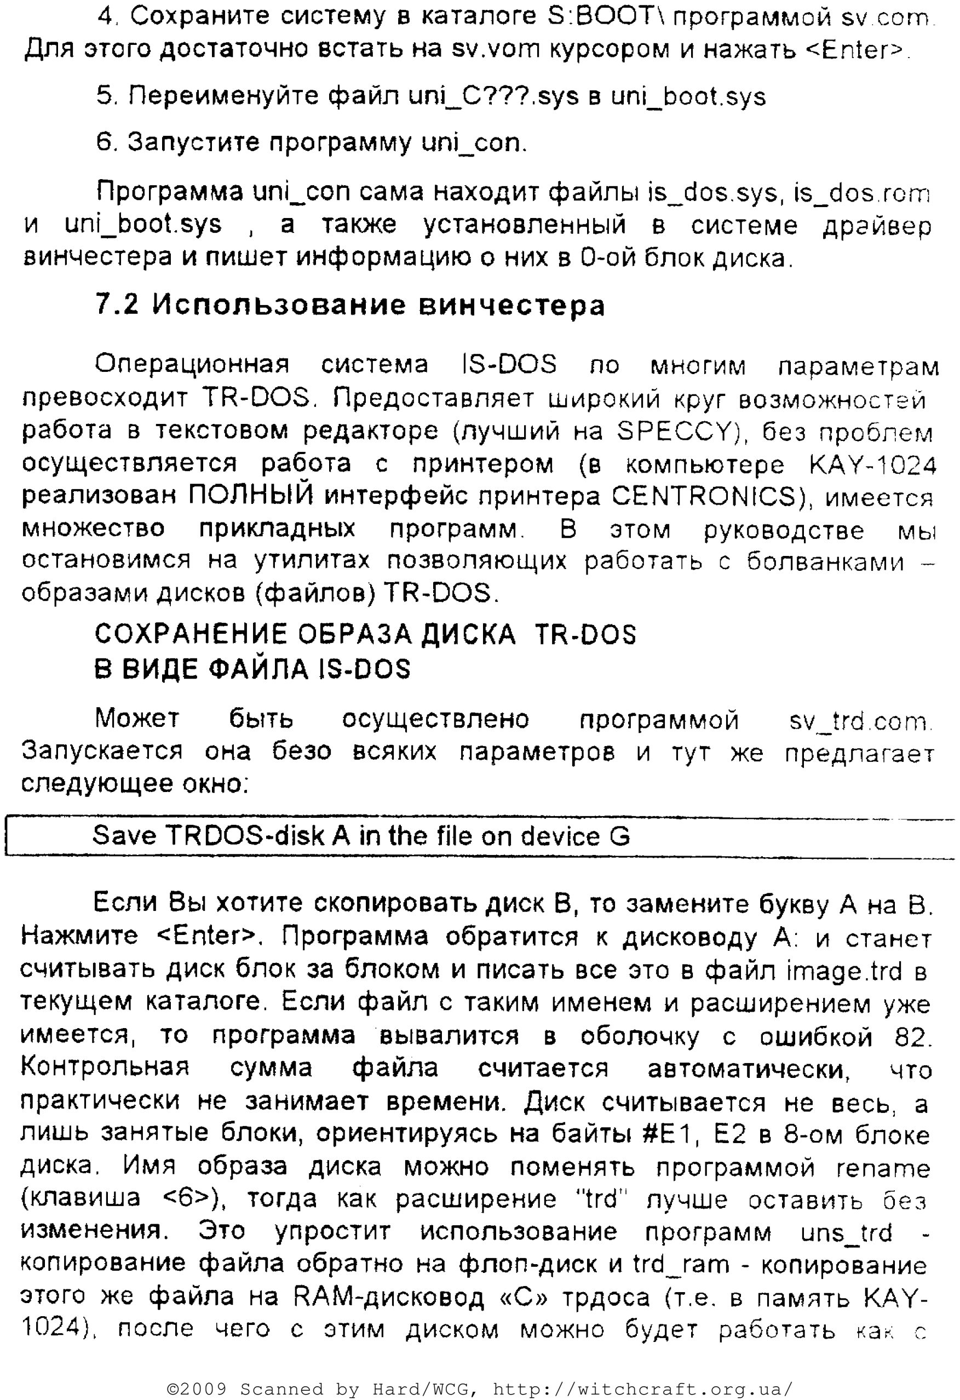
[picture p28: page 26]
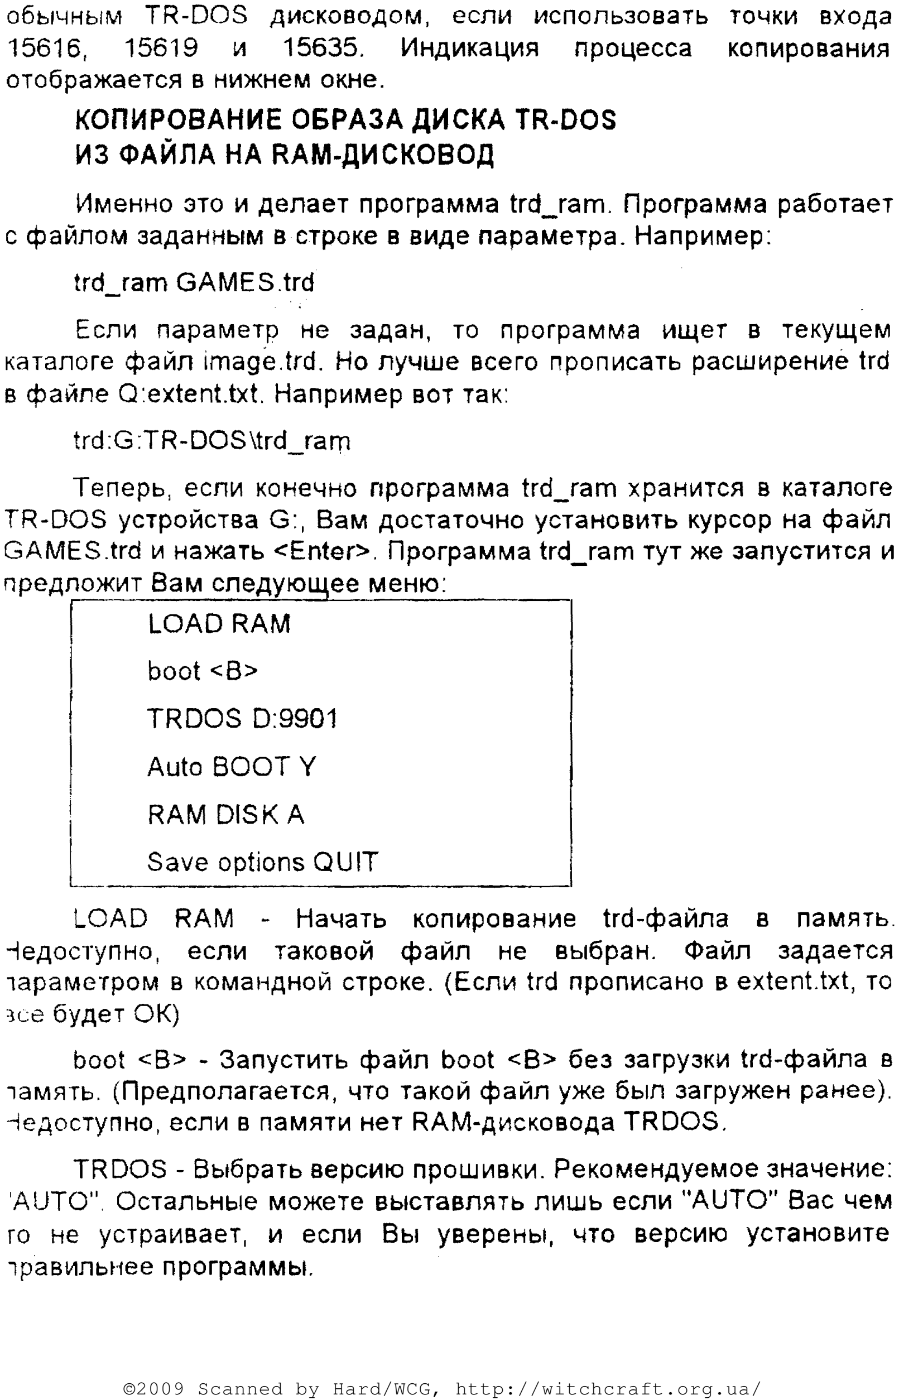
[picture p29: page 27]
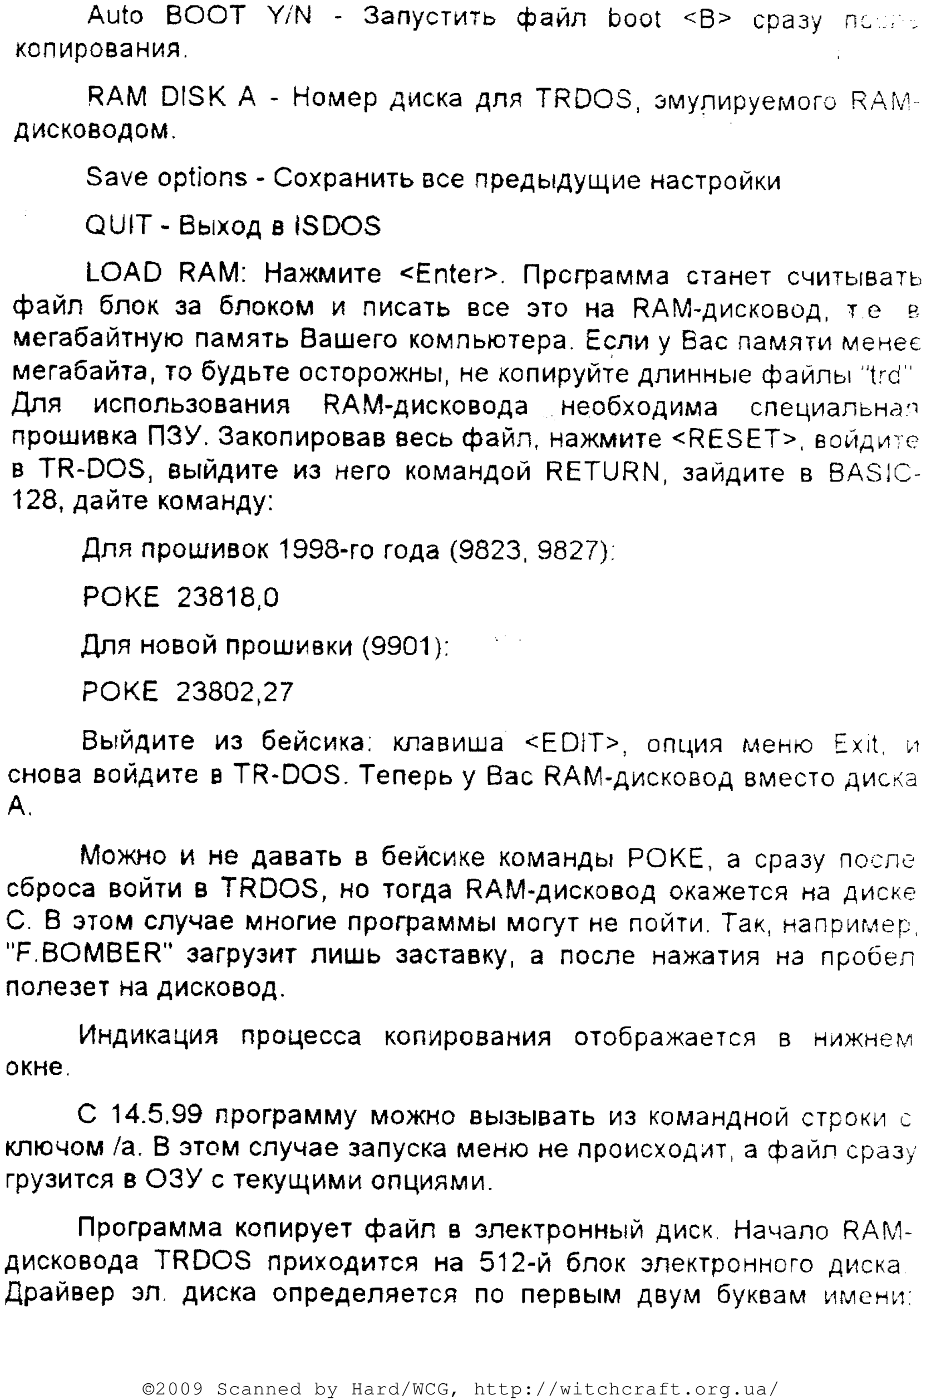
[picture p30: page 28]
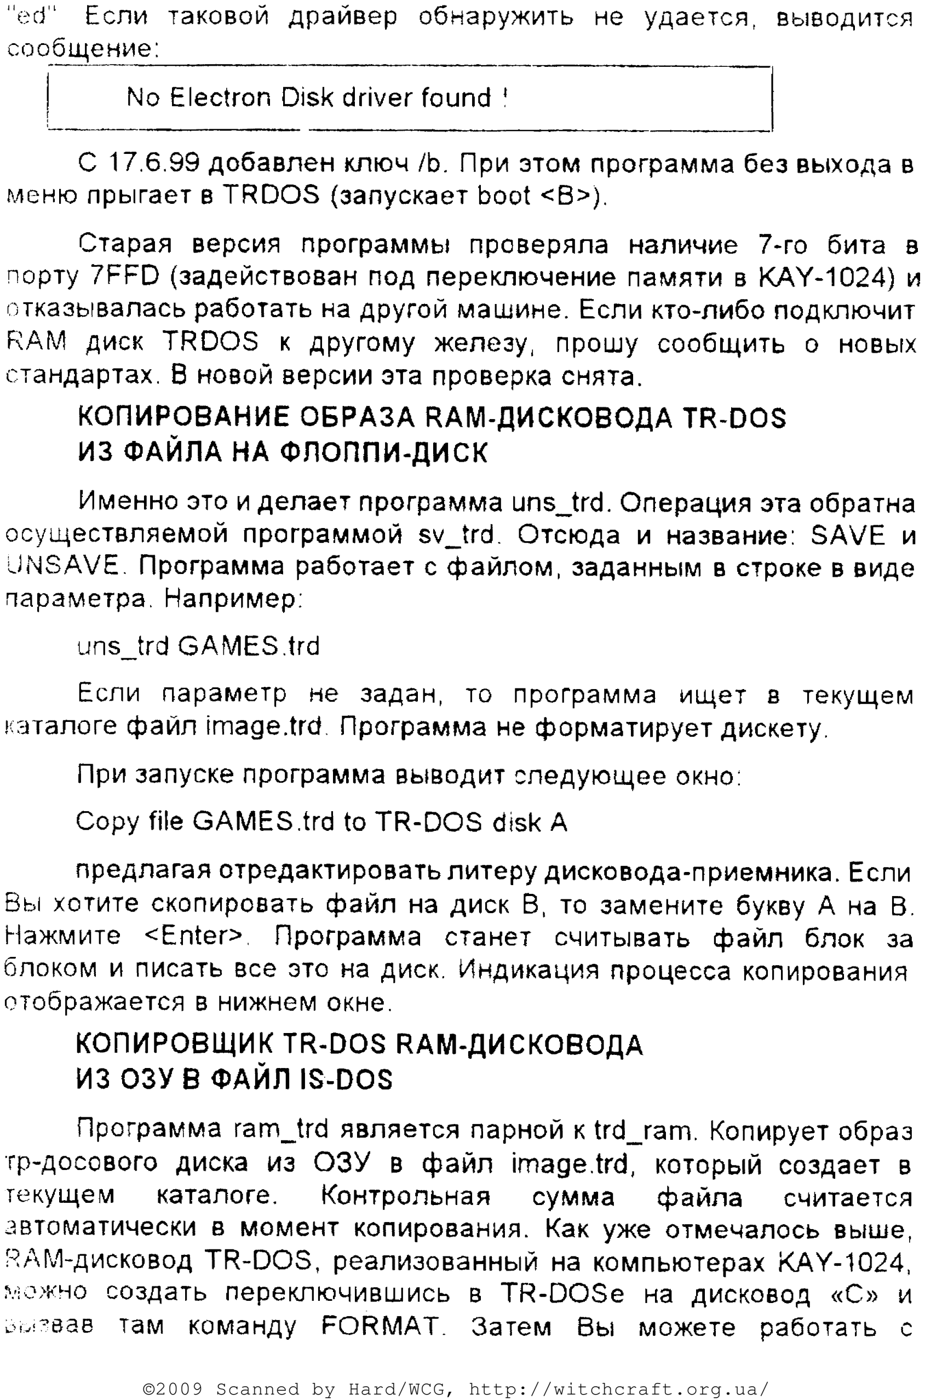
[picture p31: page 29]
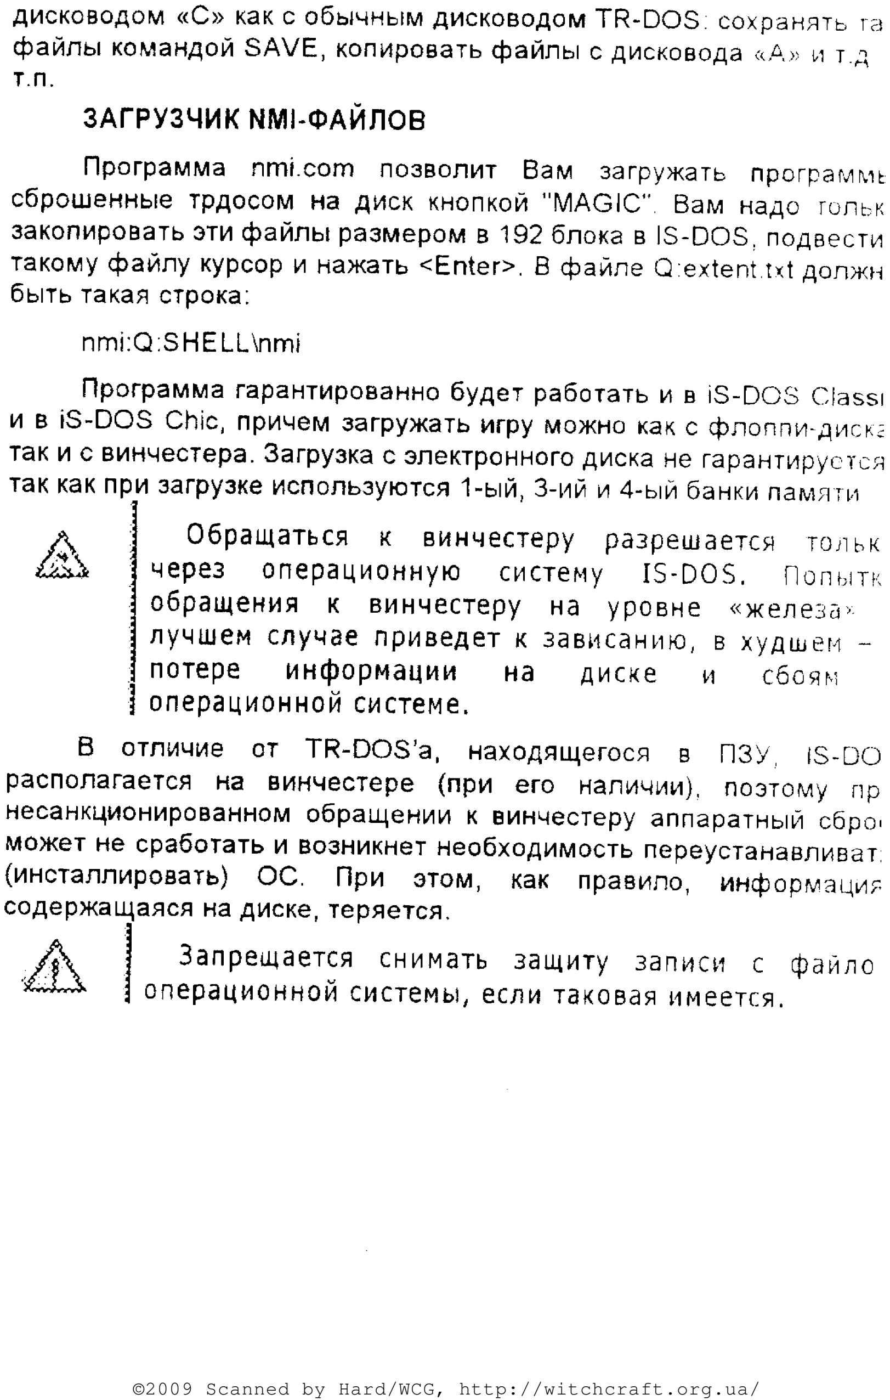
[picture p32: page 30]
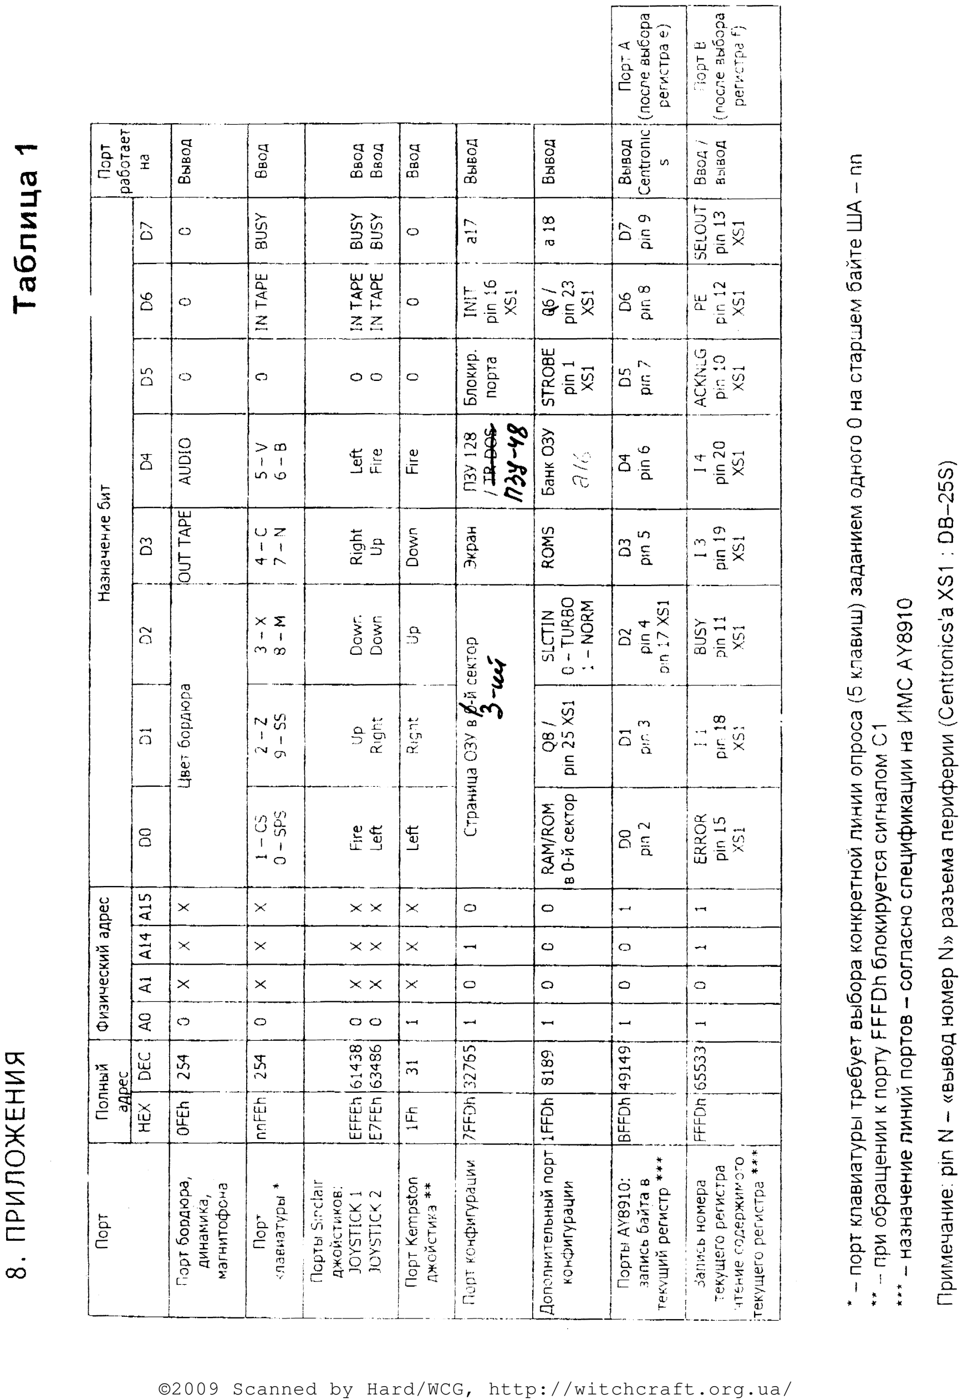
[picture p33: page 31]
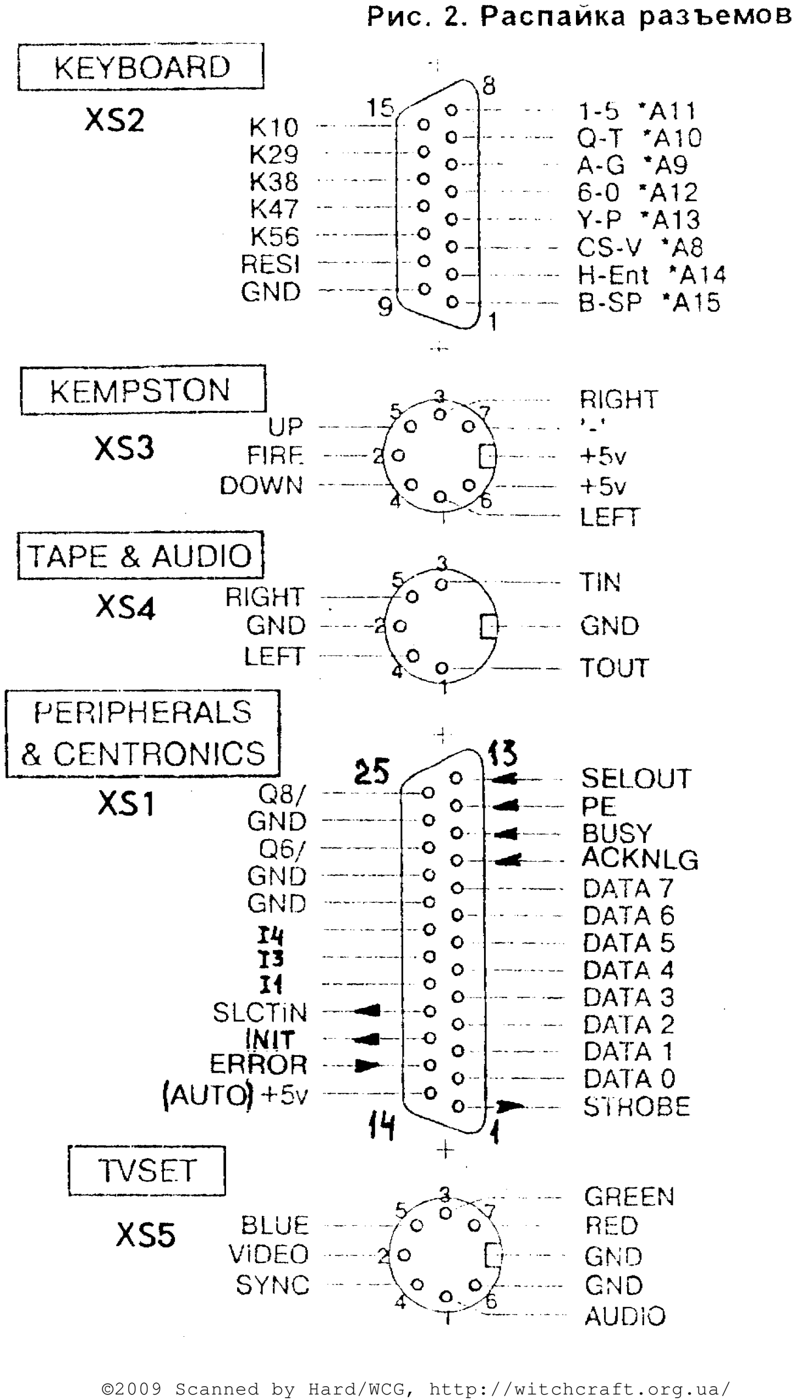
[picture p34: page 32]
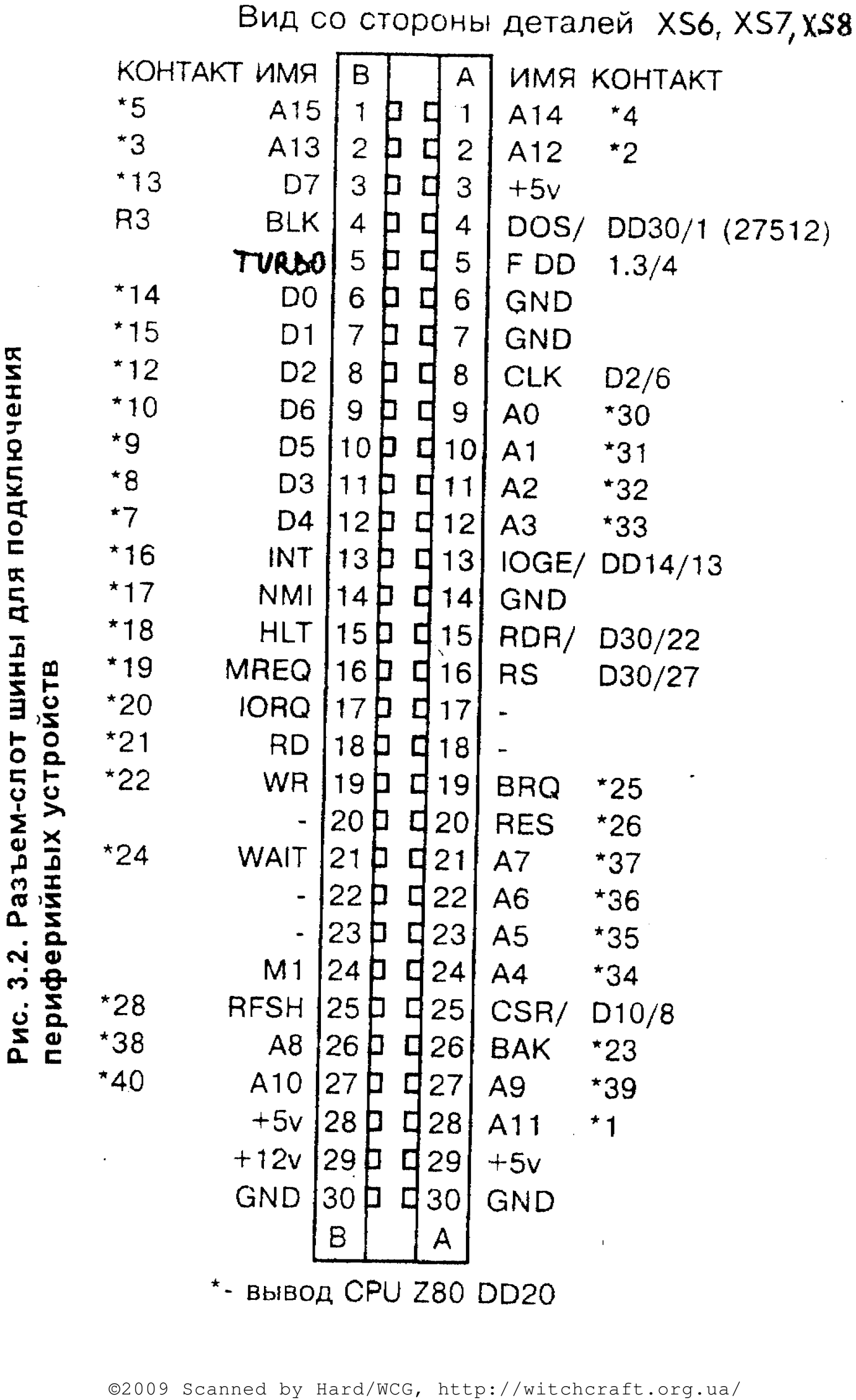
[picture p35: page 33]
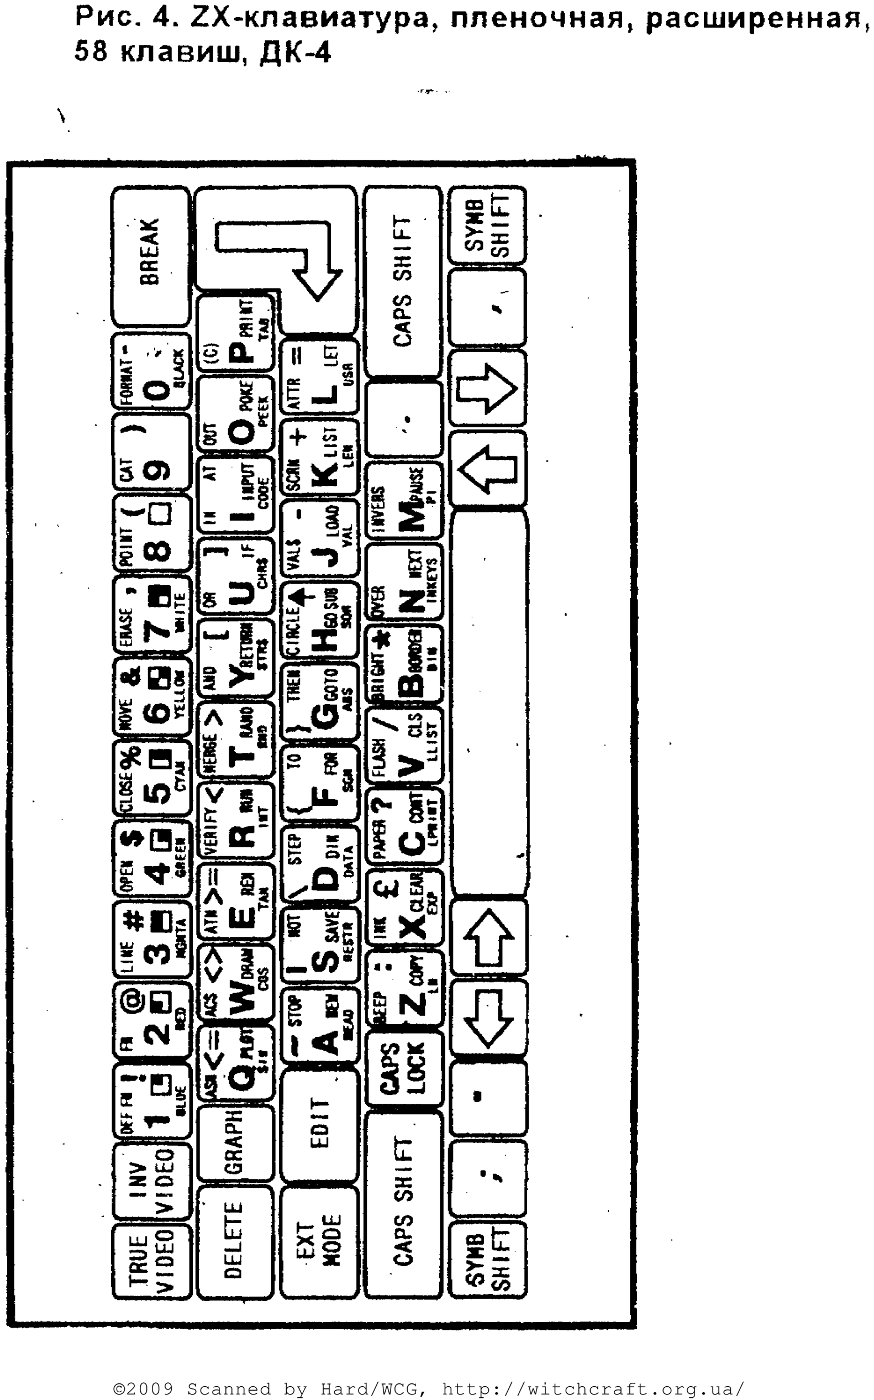
[picture p36: page 34]
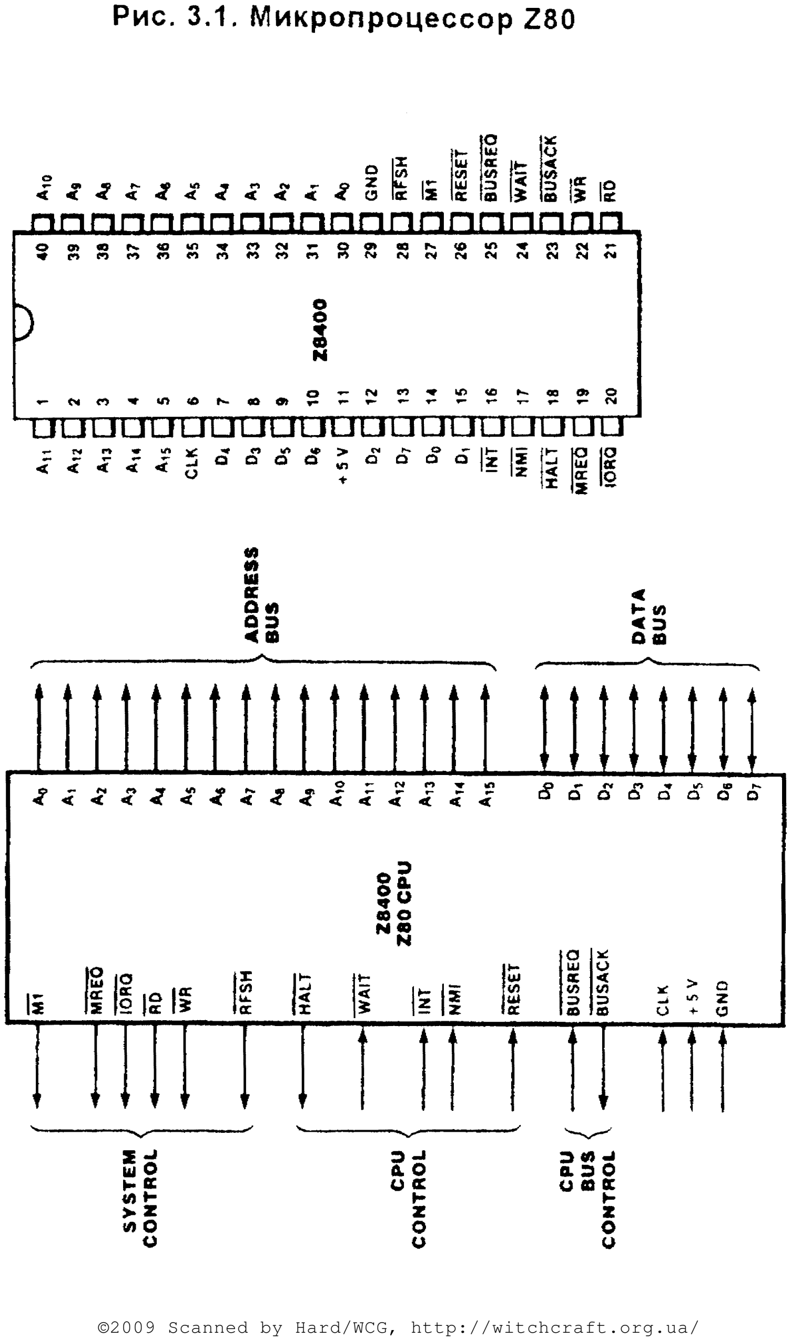
[picture p37: page 35]
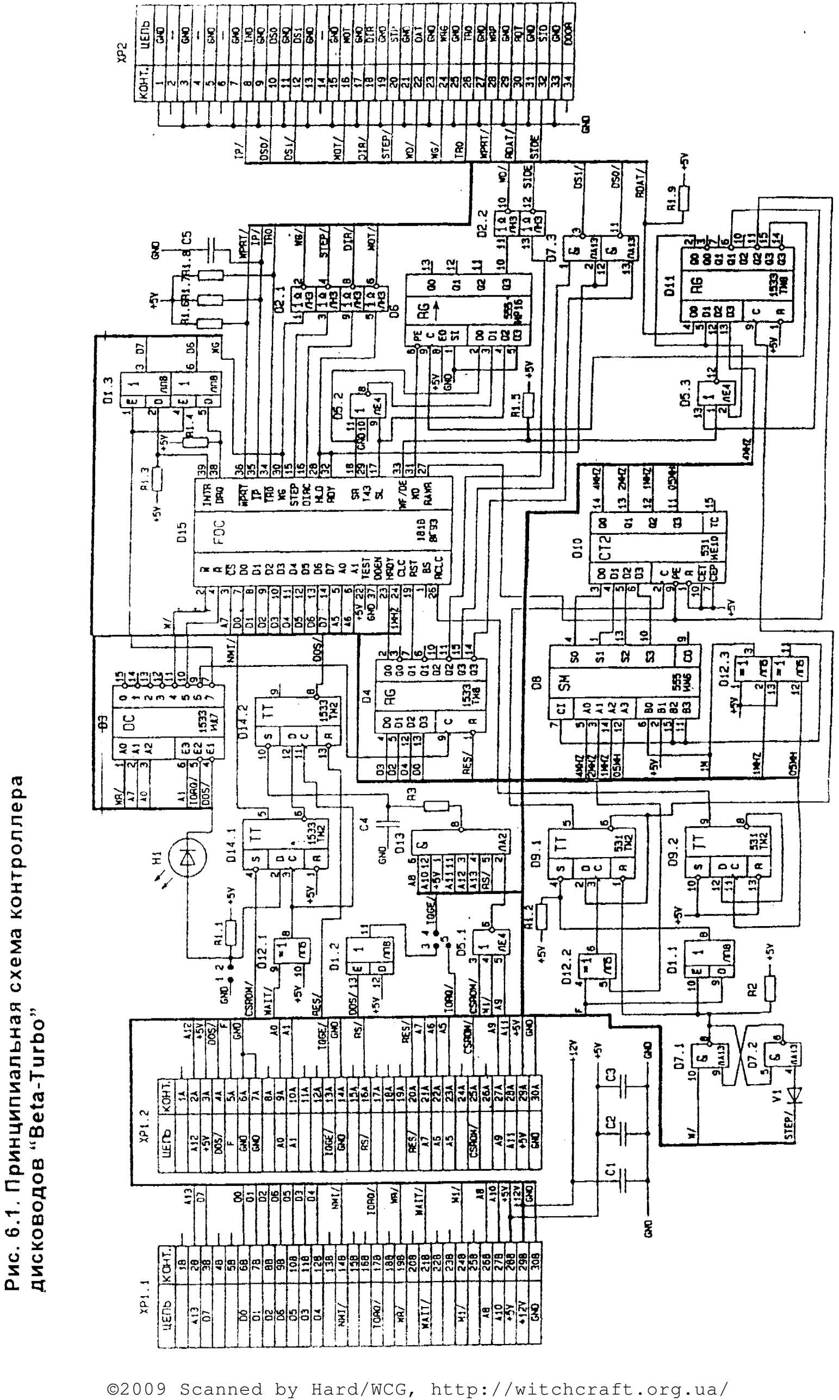
[picture p38: page 36]
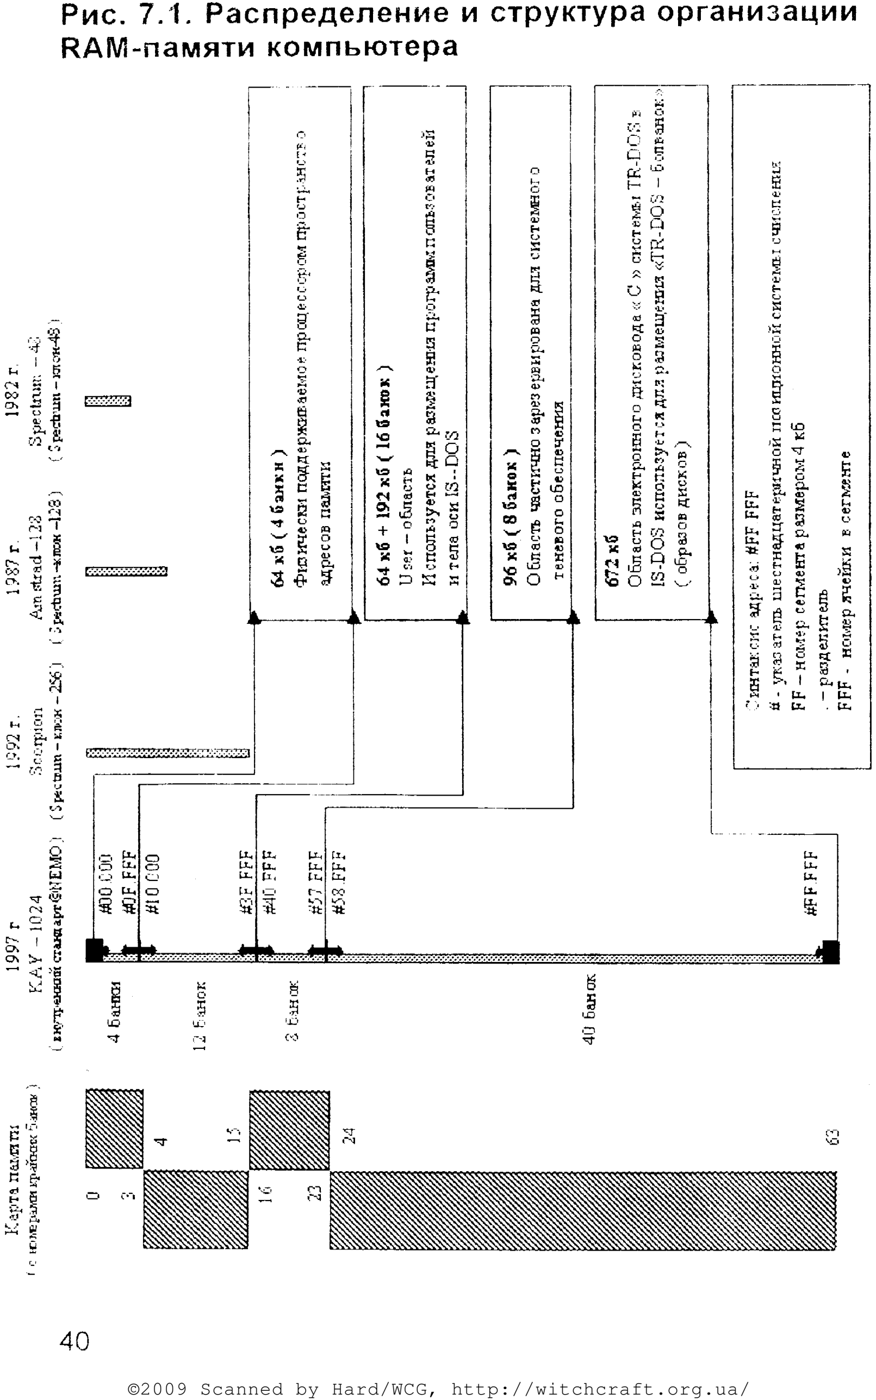
[picture p39: page 37]
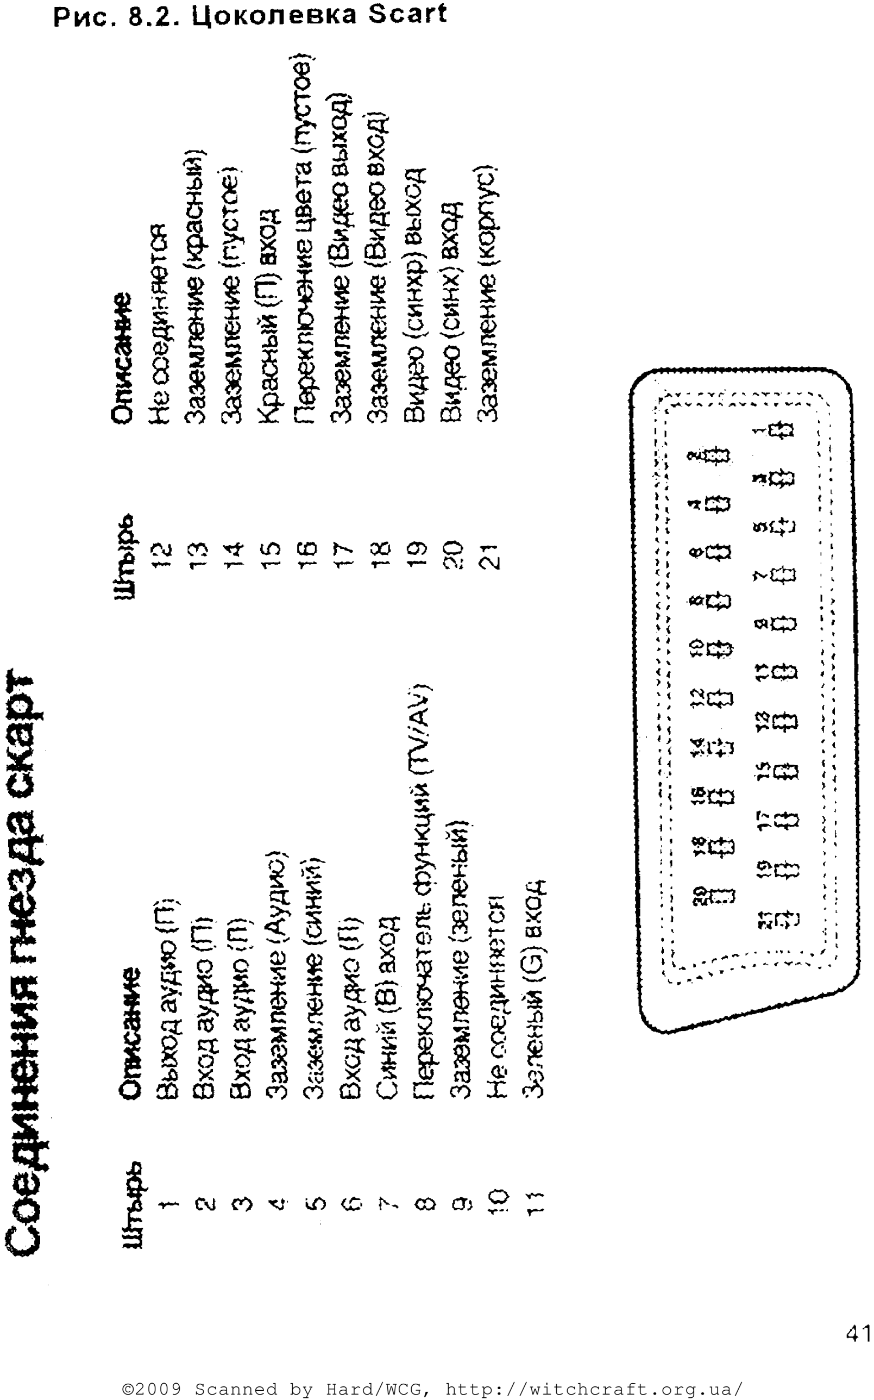
[picture p40: page 38]
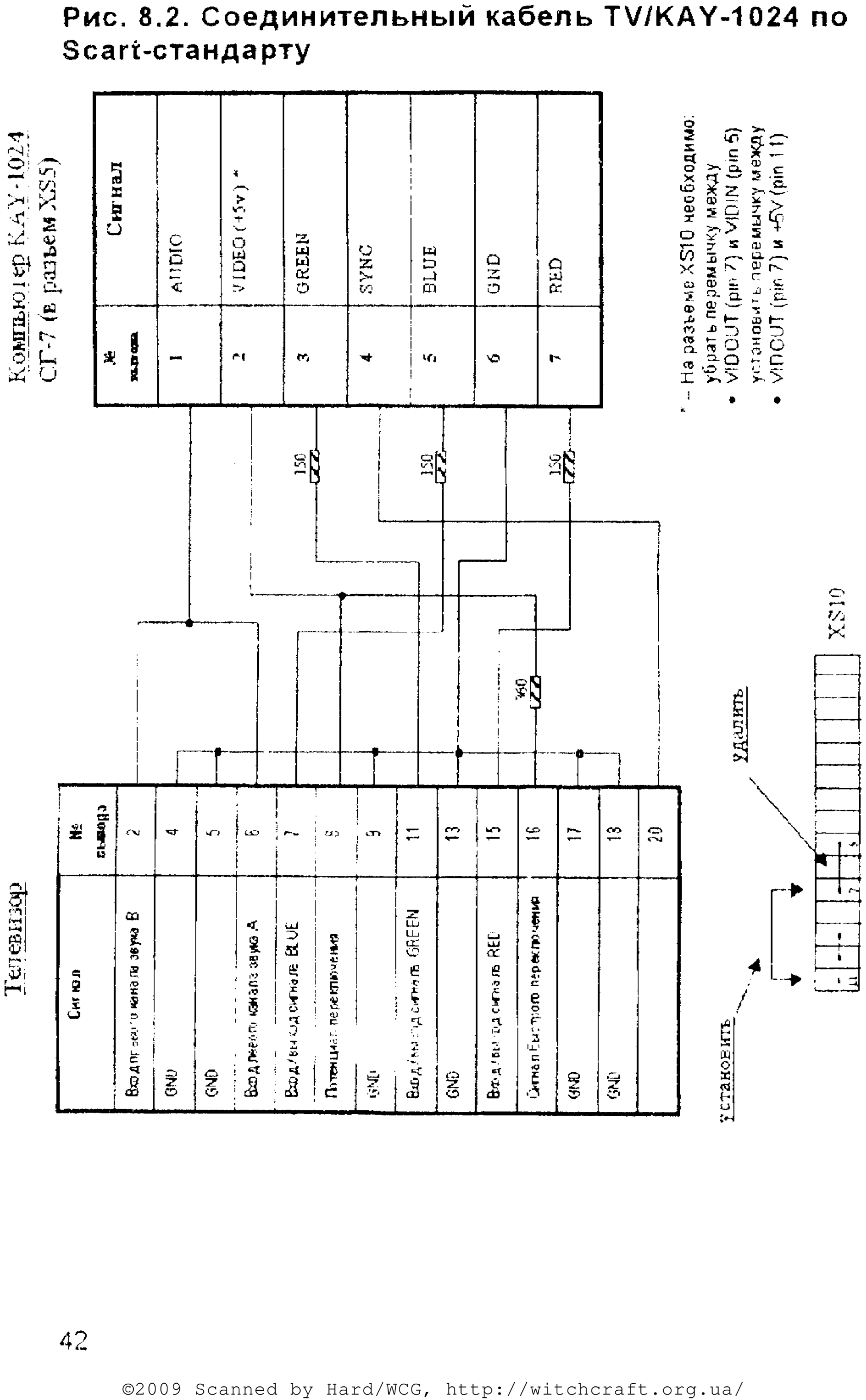
[picture p41: page 39]
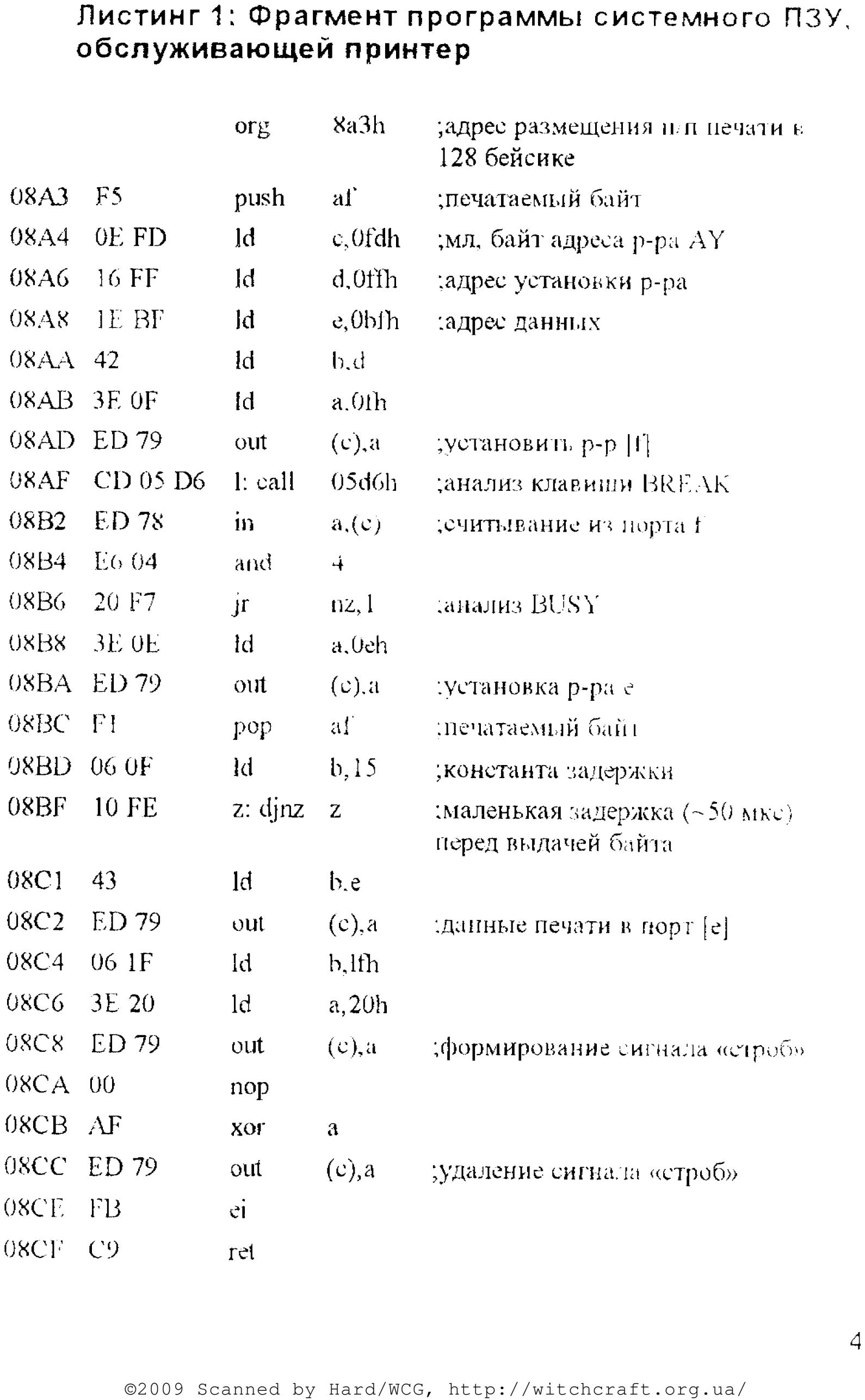
[picture p42: page 40]
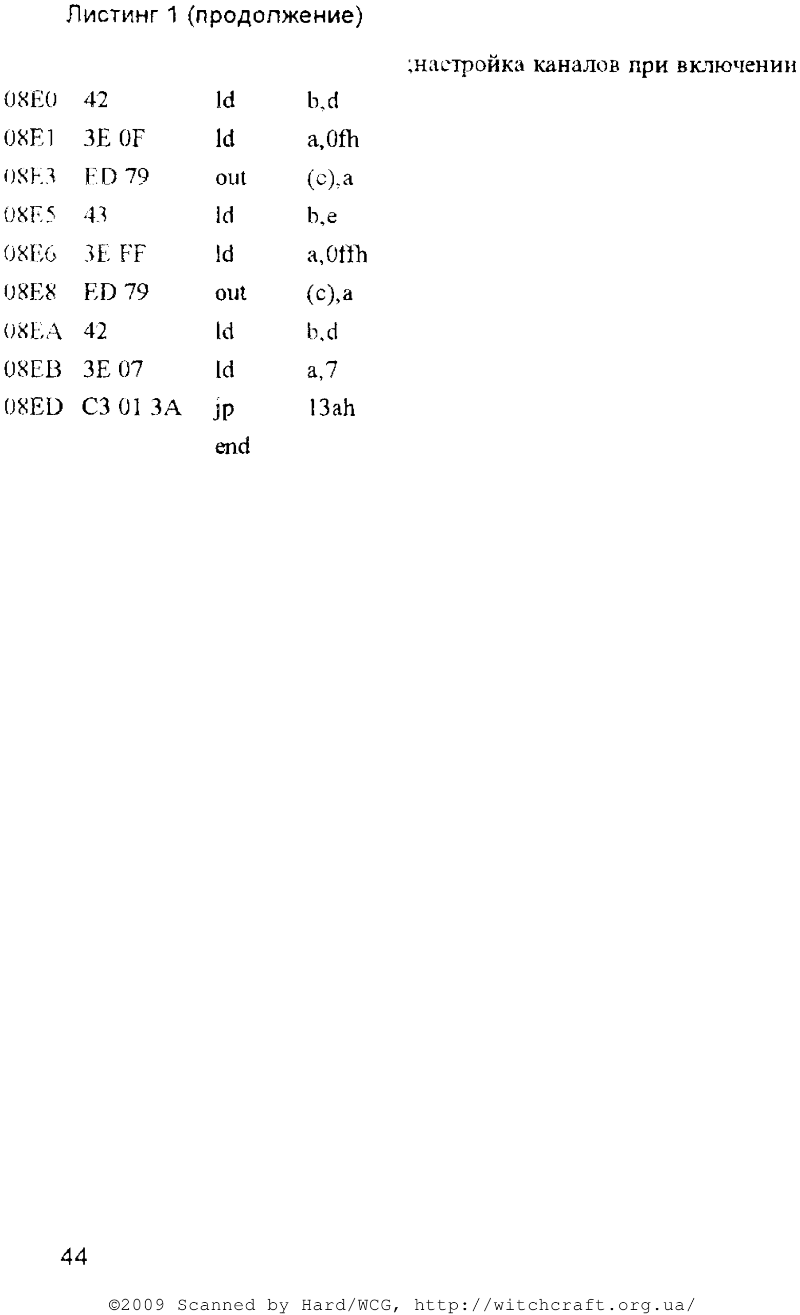
[picture p43: page 41]
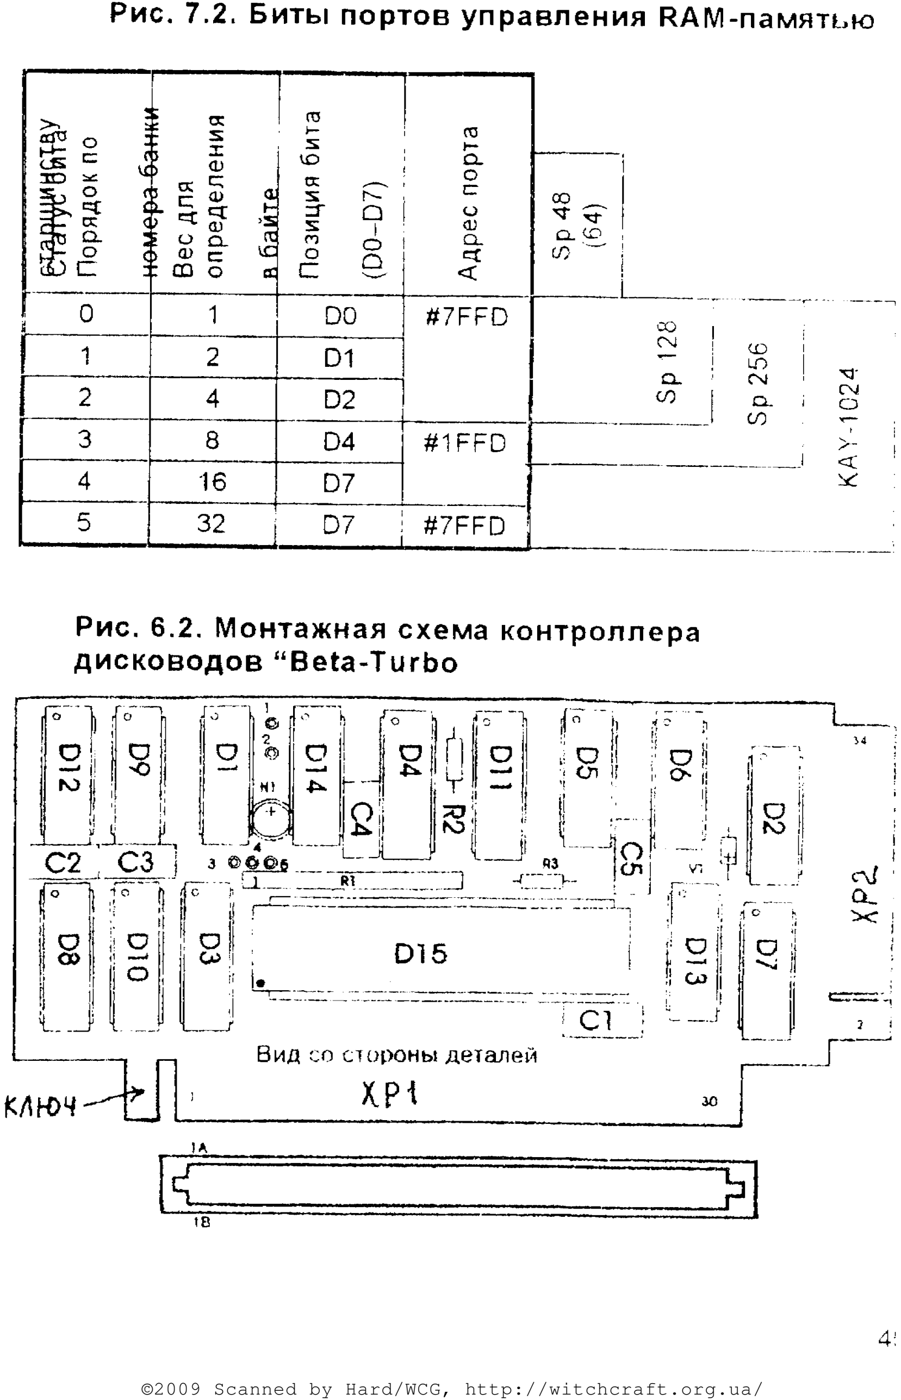
[picture p44: page 42]
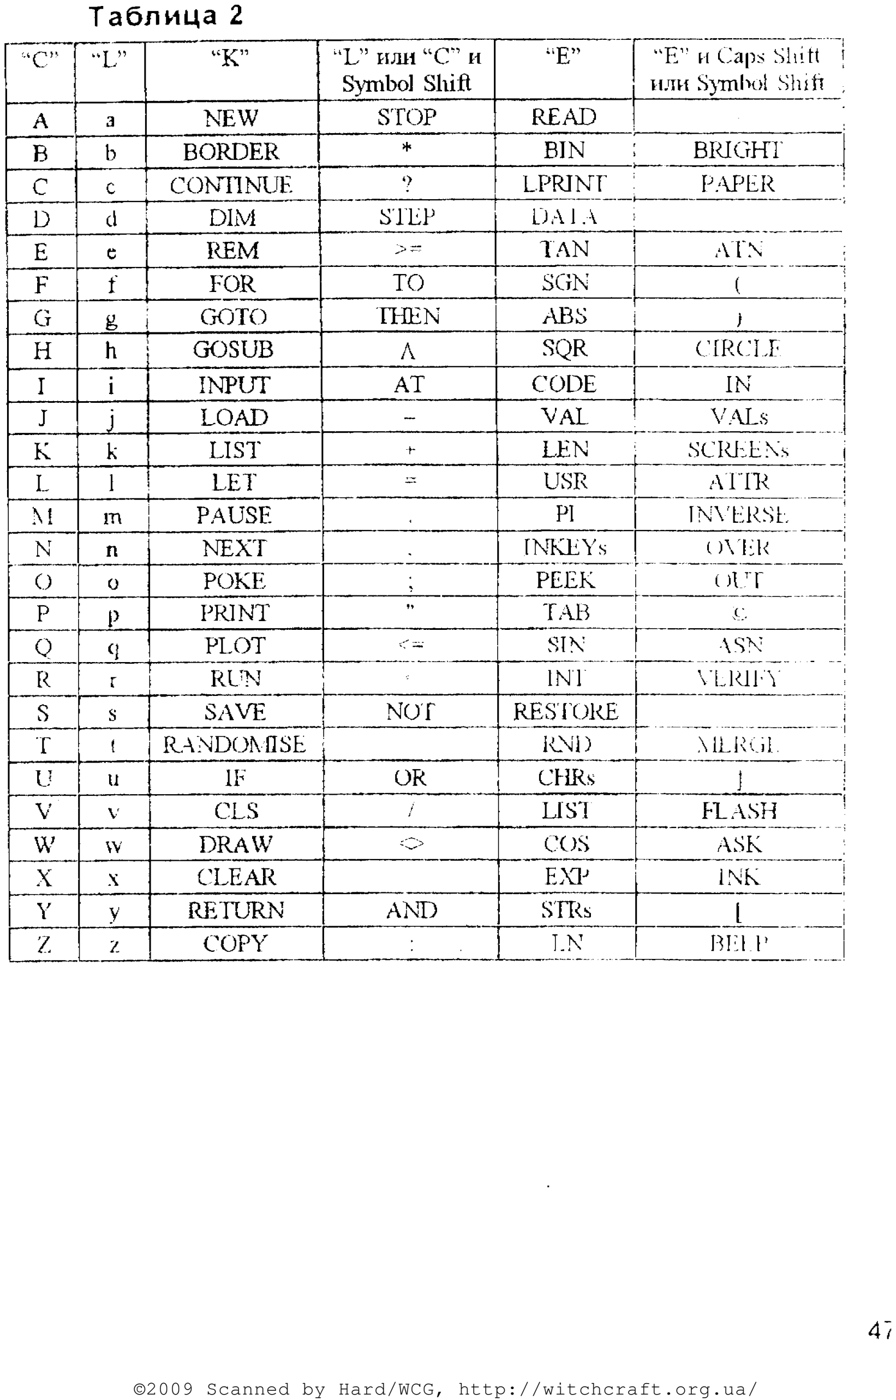
[picture p45: page 43]
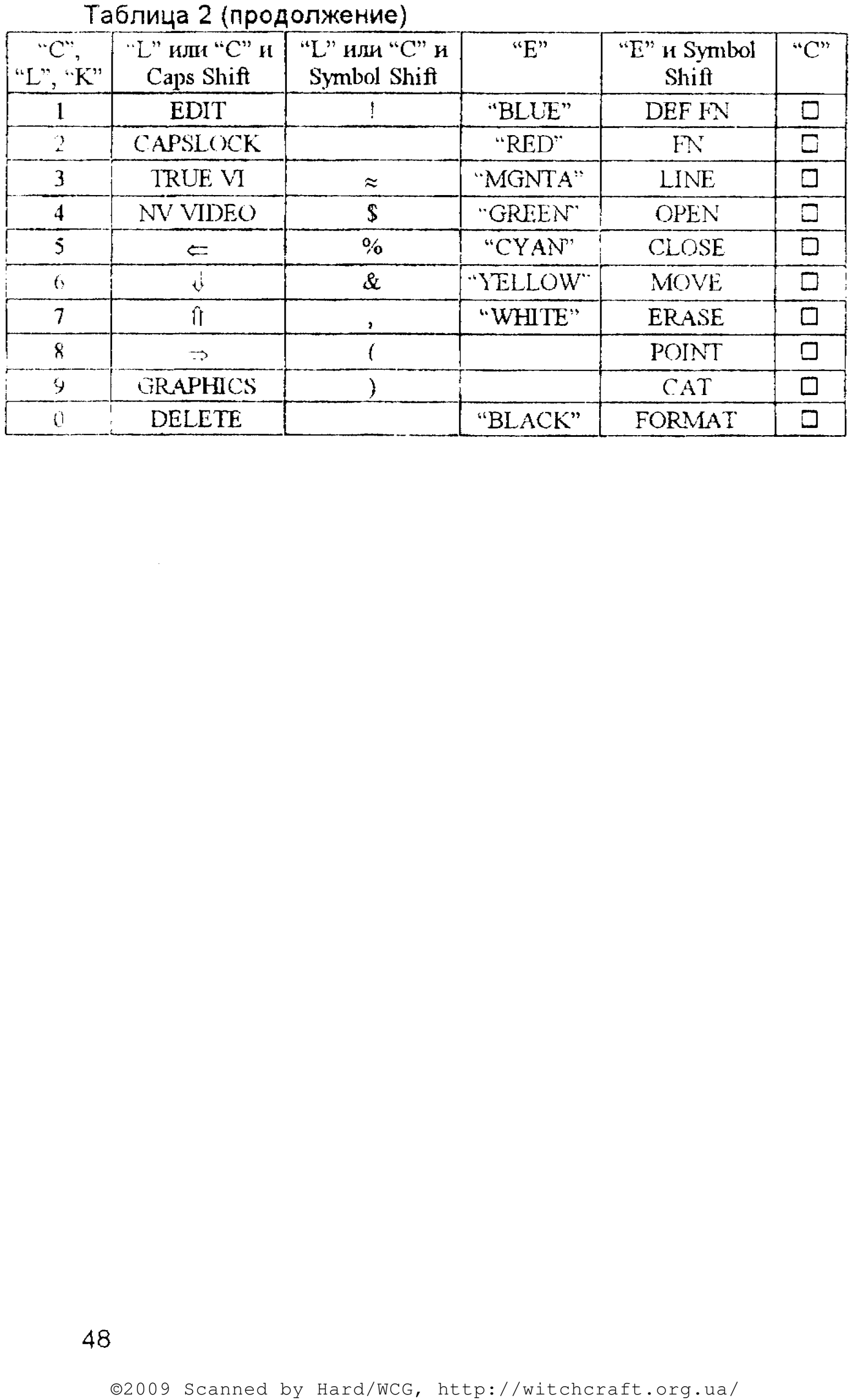
[picture p46: page 44]
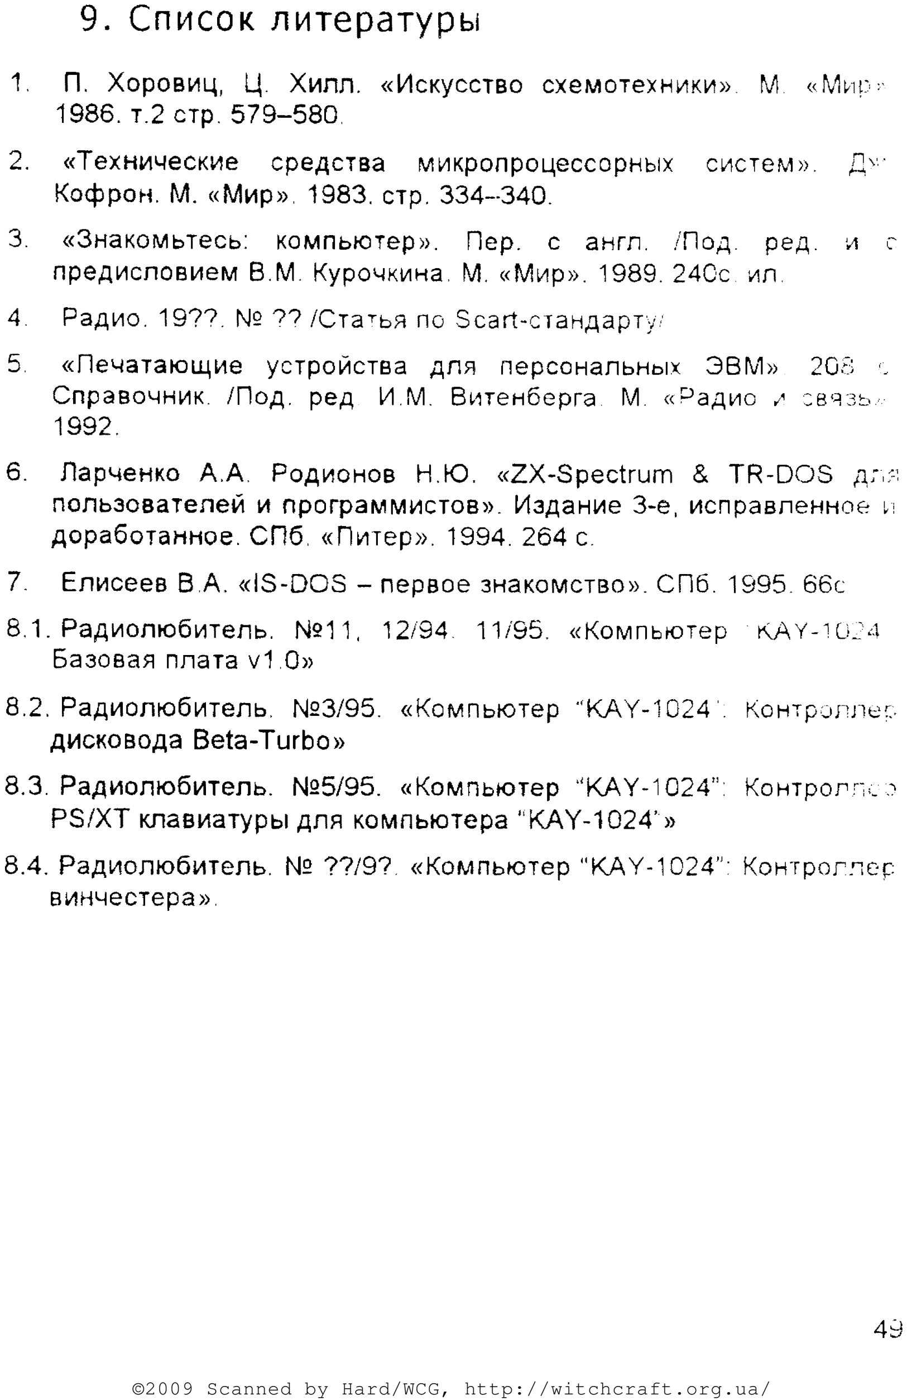
[picture p47: page 45]
