z00m128/kay1024/schematic-diagram/kay1024_v2010_assembly_instructions.pdf

KAY-1024/SL4/Turbo v2010.

Монтажная схема верхняя сторона ( | )

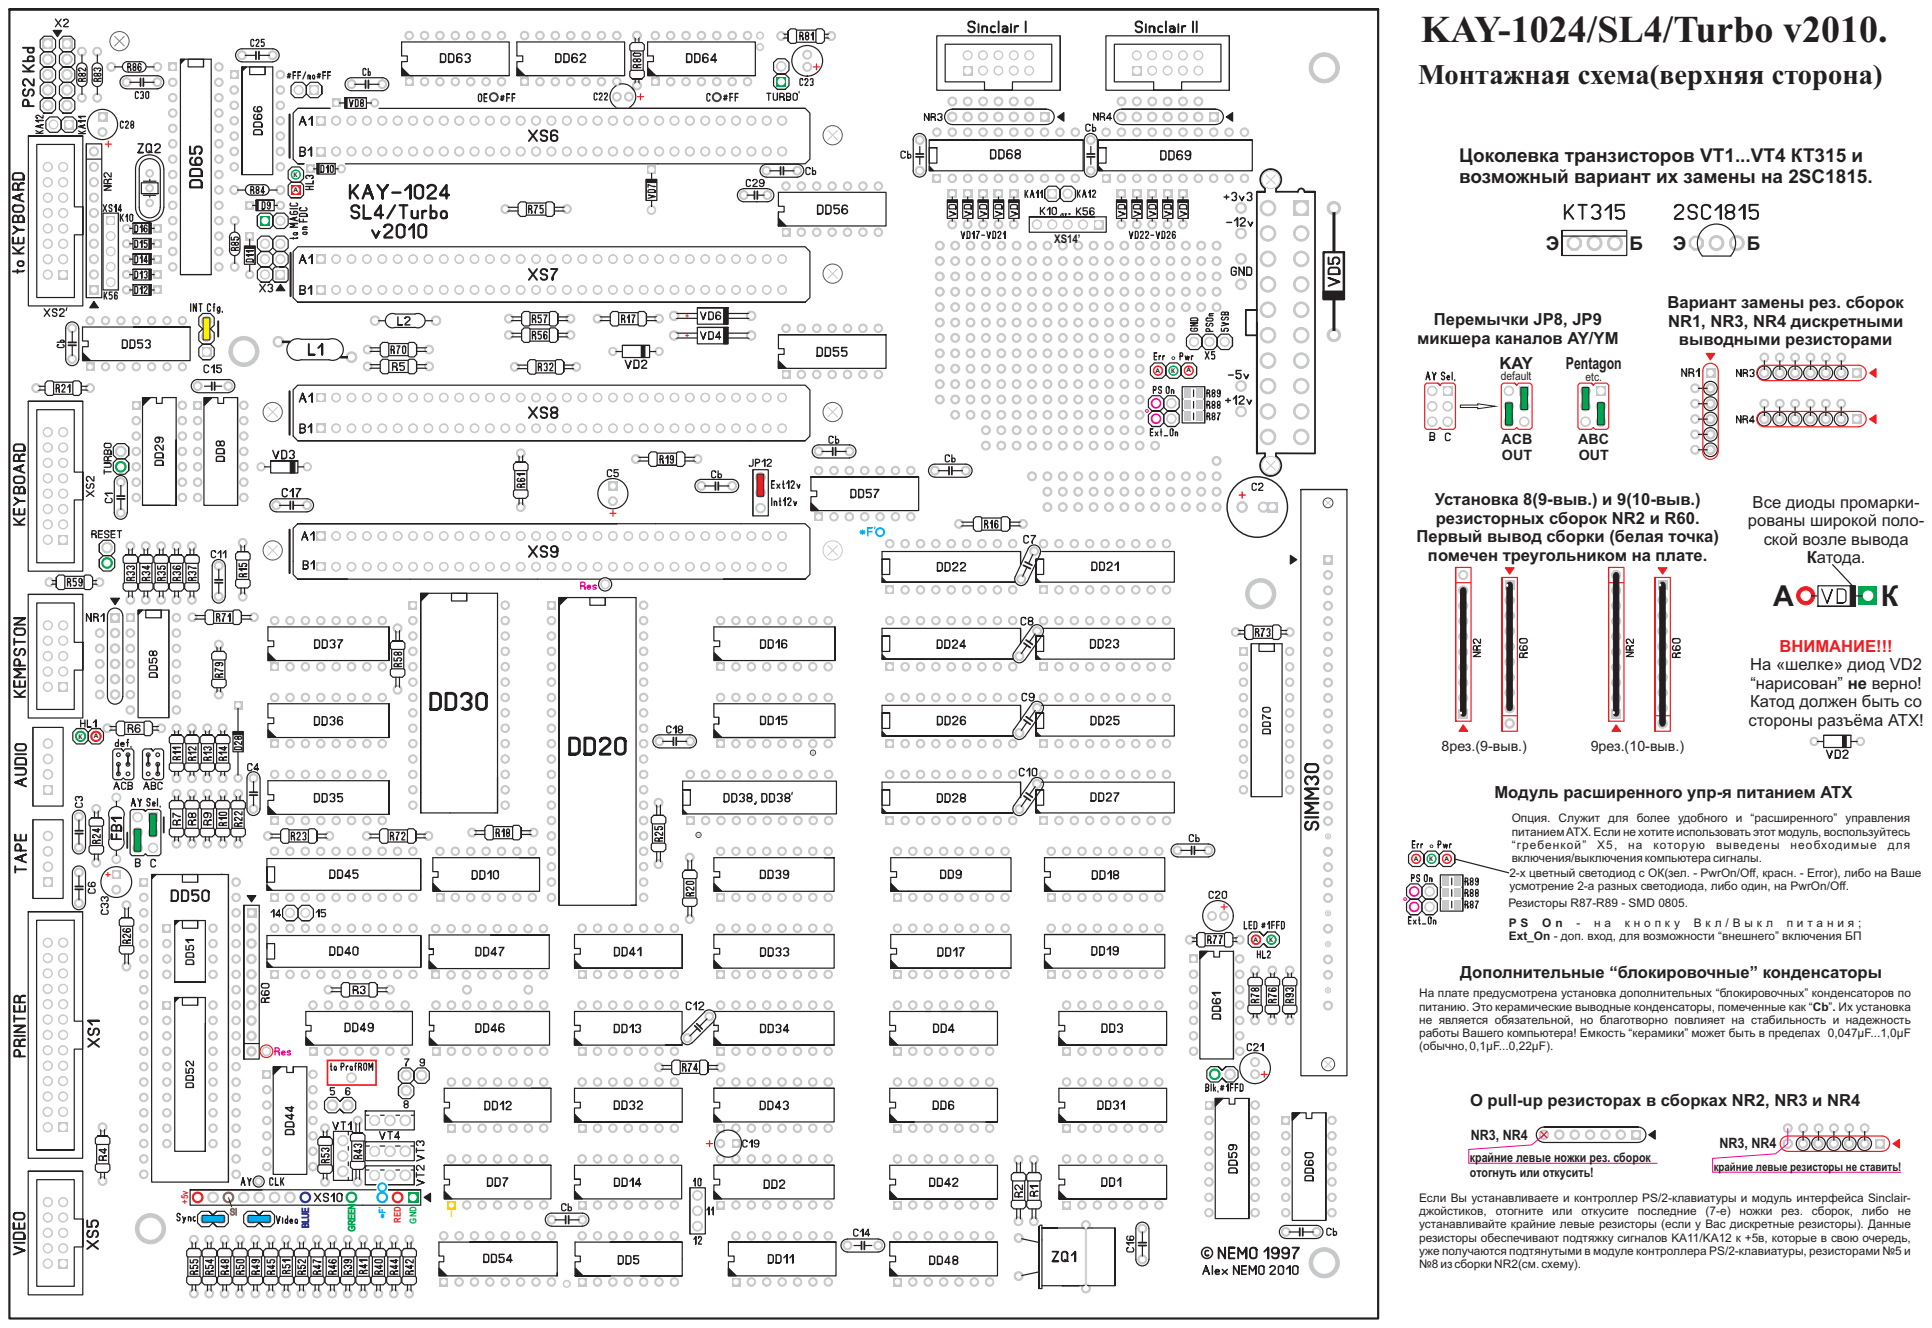
[picture p49: page 1]
Перемычки; микшера каналов; дискретными; Цоколевка транзисторов; резисторных сборок; 8рез.(9-выв.); 9рез.(10-выв.); нарисован; верно!; ATX!; ACB OUT; AB OUT; KAY; Pentagon default; etc.; PwrOn/Off,; Error цветный светодиод с ОК(зел. -; красн. -; ), либо на Ваше; усмотрение 2-а разных светодиода, либо один, на; . PwrOn/Off; кнопку; Вкл/Выкл; питания;; “гребенкой”; , на которую выведены необходимые для; резисторах в сборках pull-up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

возможный вариант их замены на 2

Вариант замены рез. сборок
выводными резисторами

Установка 8(9-выв.) и 9(10-выв.)
Первый вывод сборки (белая точка)
помечен треугольником на плате.

Все диоды промарки-
рованы широкой поло-
ской возле вывода
Катода.

ВНИМАНИЕ!!!
На «шелке» диод
Катод должен быть со
стороны разъёма

Модуль расширенного упр-я питанием ATX

Опция. Служит для более удобного и “расширенного” управления
питаниемATX. Если не хотите использовать этот модуль, воспользуйтесь
включения/выключения компьютера сигналы.
Резисторы R87-R89 - SMD 0805.
Ext_On

- доп. вход, для возможности “внешнего” включения БП

Дополнительные “блокировочные” конденсаторы

На плате предусмотрена установка дополнительных “блокировочных” конденсаторов по
не является обязательной, но благотворно повлияет на стабильность и надежность
работы Вашего компьютера! Емкость “керамики” может быть в пределах 0,047

крайние левые ножки рез. сборок
отогнуть или откусить!

крайние левые резисторы не ставить!

Если Вы устанавливаете и контроллер PS/2-клавиатуры и модуль интерфейса Sinclair-
джойстиков, отогните или откусите последние (7-е) ножки рез. сборок, либо не
устанавливайте крайние левые резисторы (если у Вас дискретные резисторы). Данные
резисторы обеспечивают подтяжку сигналов KA11/KA12 к +5в, которые в свою очередь,
уже получаются подтянутыми в модуле контроллера PS/2-клавиатуры, резисторами №5 и
№8 из сборки NR2(см. схему).

# Монтажная схема верхняя сторона с указанием номиналов компонентов

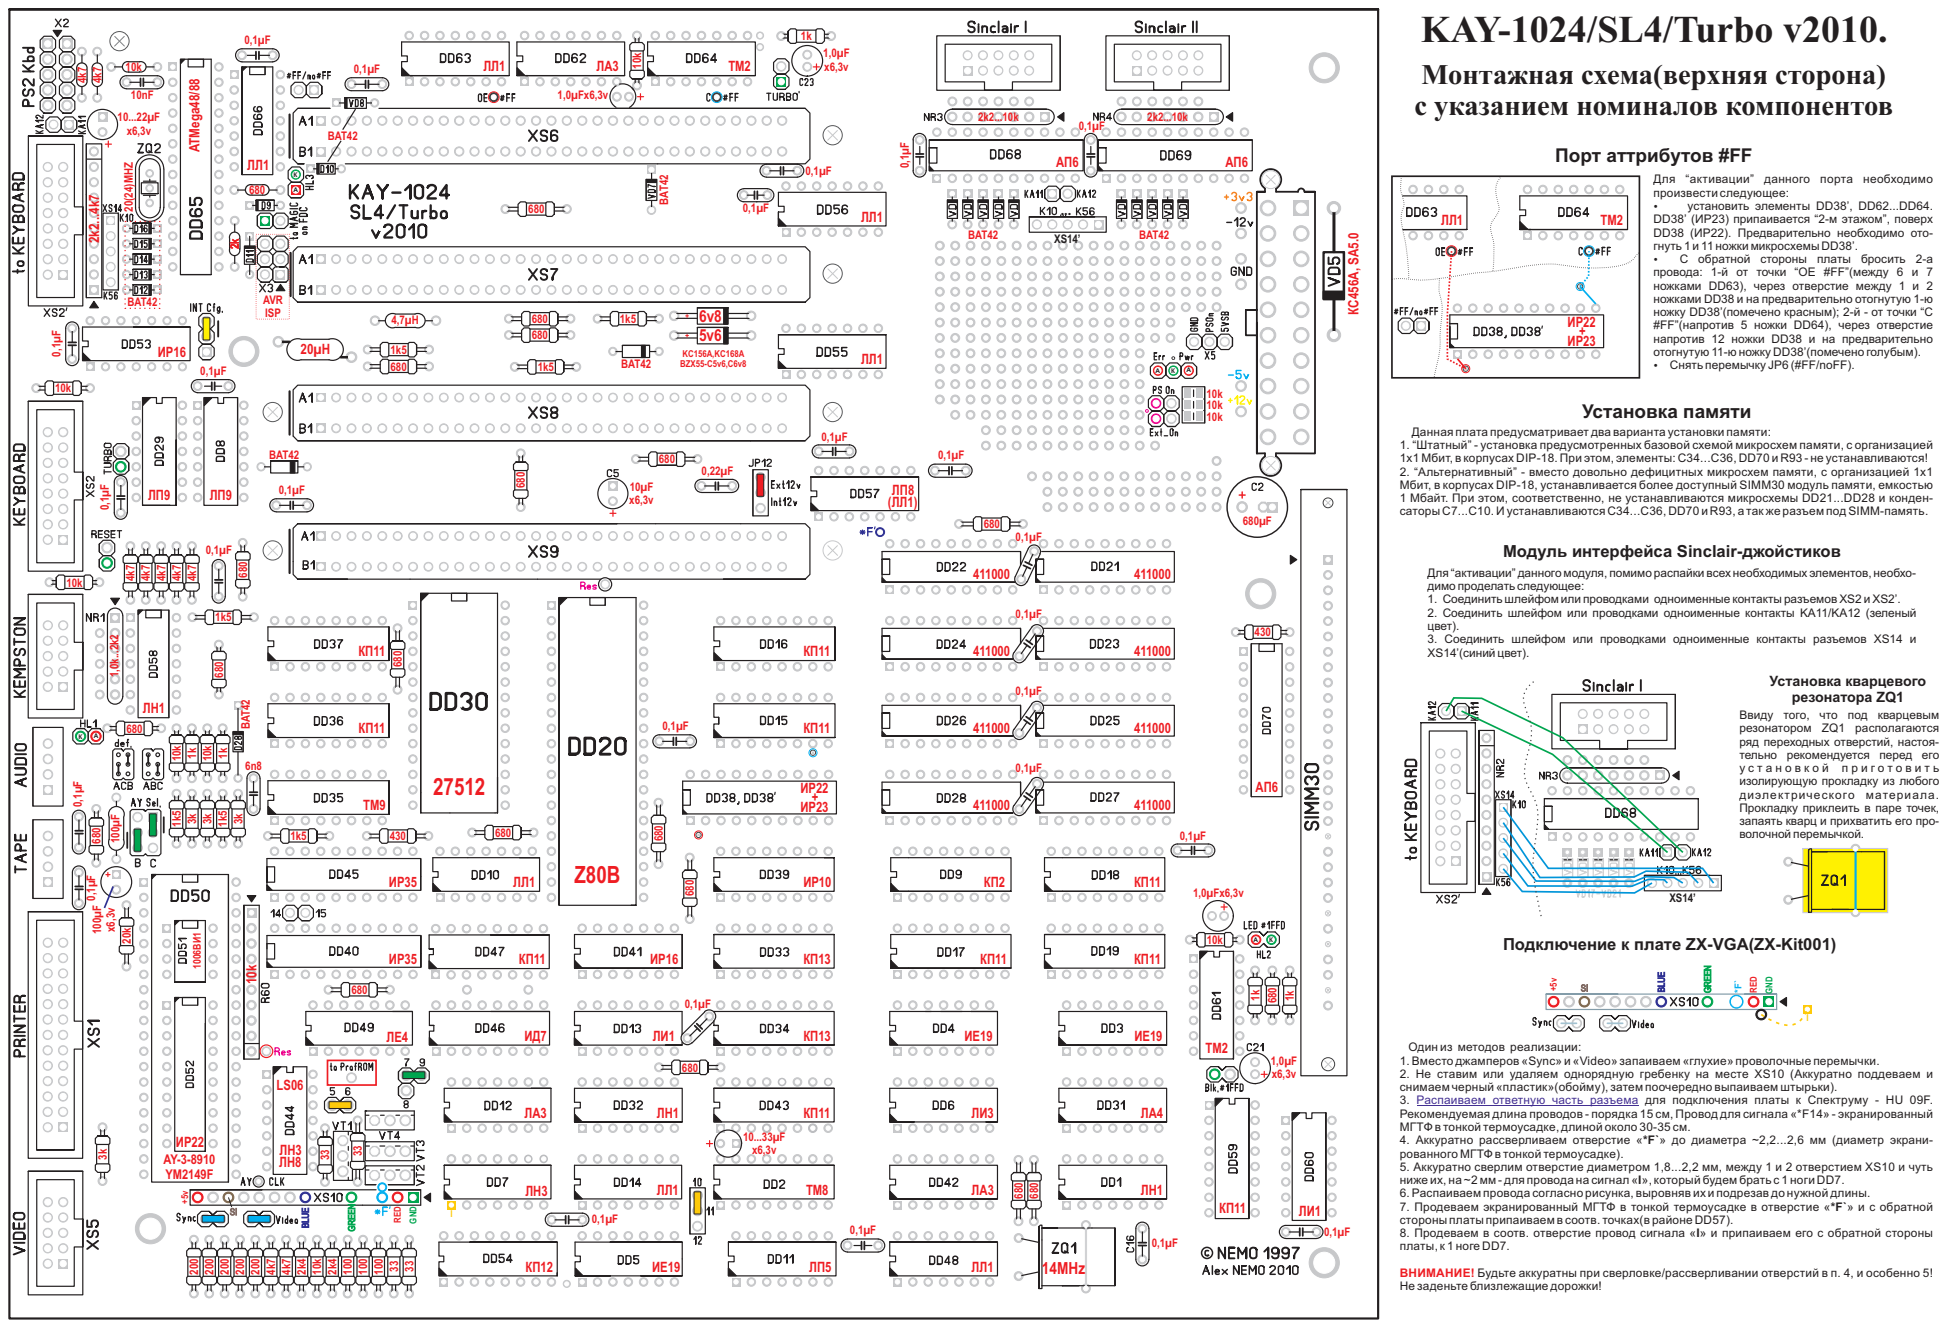
[picture p50: page 2]
14MHz; 1,0μFx6,3v; BAT42; BZX; AVR ISP; ножками; через отверстие между 1 и 2; и на предварительно отогнутую 1-ю; ножку; (помечено красным); й - от точки “С; #FF” напротив 5 ножки; через отверстие; напротив 12 ножки; и на предварительно; отогнутую 11-ю ножку; (помечено голубым).; DD38 DD38’ JP6 (#FF/noFF).; Установка памяти; 1х1 Мбит, в корпусах; При этом, элементы: С34...С36,; не устанавливаются!; DIP-18.; Мбит, в корпусах; , устанавливается более доступный; модуль памяти, емкостью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

Порт аттрибутов #FF

Для “активации” данного порта необходимо
произвести следующее:

гнуть 1 и 11 ножки микросхемы DD38 .
С обратной стороны платы бросить 2-а
провода: 1-й от точки “OE #FF” между 6 и 7
Снять перемычку

установить элементы DD38’, DD62...DD64.
(ИР23) припаивается “2-м этажом”, поверх
(ИР22). Предварительно необходимо ото-

Данная плата предусматривает два варианта установки памяти:
1. “Штатный” - установка предусмотренных базовой схемой микросхем памяти, с организацией
2. “Альтернативный” - вместо довольно дефицитных

микросхем памяти, с организацией 1х1

Соединить шлейфом или проводками одноименные контакты

Ввиду того, что под кварцевым
ряд переходных отверстий, настоя-
тельно рекомендуется перед его
установкой приготовить
изолирующую прокладку из любого
диэлектрического материала.
Прокладку приклеить в паре точек,
запаять кварц и прихватить его про-
волочной перемычкой.

Один из методов реализации:
снимаем черный «пластик»(обойму), затем поочередно выпаиваем штырьки
Распаиваем ответную часть разъема (http://zx.pk.ru/showpost.php?p=328801&postcount=802)
Рекомендуемая длина проводов - порядка 15 см, Провод для сигнала «*F14» - экранированный
МГТФ в тонкой термоусадке, длиной около 30-35 см.
рованного МГТФ в тонкой термоусадке

для подключения платы к Спектруму - HU 09F.

6. Распаиваем провода согласно рисунка, выровняв их и подрезав до нужной длины.
Продеваем в соотв. отверстие провод сигнала « » и припаиваем его с обратной стороны
платы, к 1 ноге

ВНИМАНИЕ!
Не заденьте близлежащие дорожки!

Будьте аккуратны при сверловке/рассверливании отверстий в п. 4, и особенно 5!

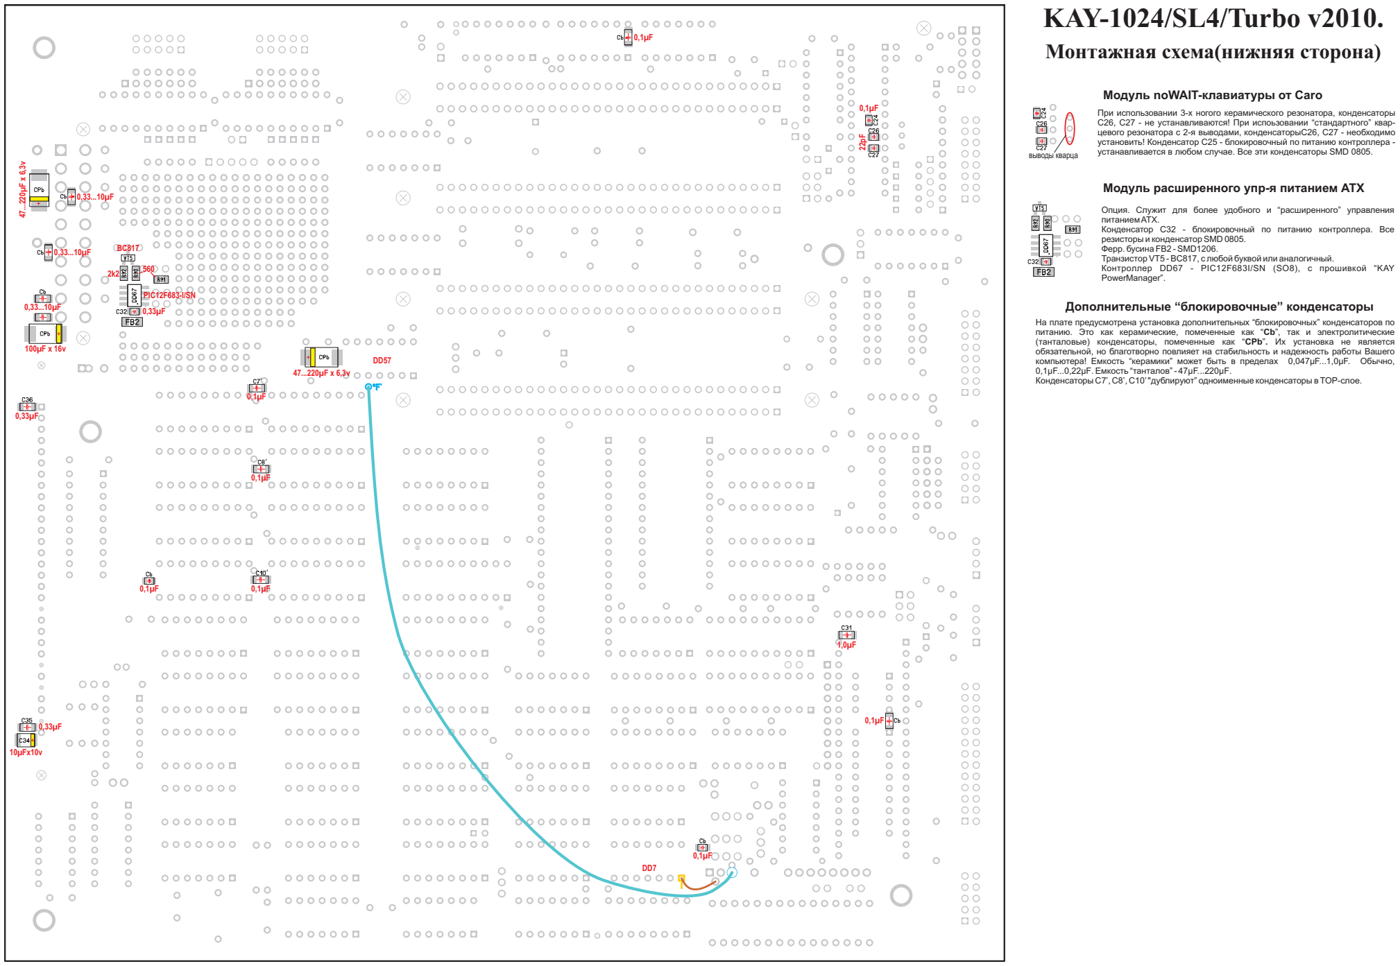
[picture p51: figure]
Дополнительные “блокировочные” конденсаторы; выводы кварца; питаниемATX.; резисторы и конденсатор SMD 0805. Ферр. бусина FB2 - SMD1206.; PowerManager”.; (танталовые) конденсаторы, помеченные как “; Их установка не является; . Емкость “танталов” - 47; Конденсаторы С7 С; "дублируют” одноименные конденсаторы в; слое.; Cb CPb .”; TOP-; 10μFx10v; PIC12F683-I/SN

Монтажная схема нижняя сторона ( | )
Модуль | клавиатуры от noWAIT- | Caro

Модуль расширенного упр-я питанием ATX

При использовании 3-х ногого керамического резонатора, конденсаторы С26, С27 - не устанавливаются! При испоьзовании “стандартного” кварцевого резонатора с 2-я выводами, конденсаторыС26, С27 - необходимо установить! Конденсатор С25 - блокировочный по питанию контроллера -устанавливается в любом случае. Все эти конденсаторы SMD 0805.

Опция. Служит для более удобного и “расширенного” управления

Конденсатор С32 - блокировочный по питанию контроллера. Все

Транзистор VT5 - BC817, с любой буквой или аналогичный.
Контроллер | с прошивкой DD67 - PIC12F683I/SN (SO8), | “KAY

На плате предусмотрена установка дополнительных “блокировочных” конденсаторов по питанию. Это как керамические, помеченные как “ ”, так и электролитические

обязательной, но благотворно повлияет на стабильность и надежность работы Вашего
компьютера! Емкость “керамики” может быть в пределах | 0,047 | Обычно,

KAY-1024/SL4/Turbo v2010.
Рекомендуемая последовательность сборки.

# 1. Визуально внимательно осмотреть плату на просвет

# и (или) под увеличительным стеклом на предмет «дефектов производства» - залипов/обрывов дорожек

и

т.д.

# 2. Запаять

с обратной стороны (нижний слой) платы все SMD-компоненты. Опасайтесь перегрева SMD-электролитов,

# микроконтроллера DD67

# и транзистора VT5! 3. Рекомендуется установить плату на пластиковые, либо латунные стойки (заимствуются

# у «старшего брата - PC»), для

удобства дальнейшего монтажа.

# 4. Запаять

с верхней стороны платы все SMD-компоненты, если необходимо (резисторы R87…R89 возле разъёма АТХ).
5. Запаять все выводные диоды, резисторы, резисторные сборки, конденсаторы, ферритовые бусины/мелкие дросселя.

# 6. Запаять все электролитические конденсаторы

# и дроссель L1(если планируете использовать «внутренний» источник напряжения +12v, а не

с ATX БП).

# 7. Запаять все перемычки/джамперы

и однорядные разъёмы (BLS-xx).

# 8. Отформовать выводы (

# у ZQ1)

# и запаять кварцевые (ZQ2 возможен керамический) резонаторы ZQ1, ZQ2. Под ZQ1 необходимо подложить изоляционную прокладку! 9. Запаять все микросхемы

# с DIP-корпусах, кроме тех. что будете устанавливать

# в панельки. В последнюю очередь запаять

панельки (если будете их ставить, конечно) под микросхемы: DD20, DD21…DD28, DD30, DD50, DD65. Возможно, есть смысл, в установке панельки под DD33(КП13),

# т.к. по отзывам владельцев КАЙев, она нередко «вылетает»! Рекомендуется использовать качественные «цанговые» панельки для микросхем! 10. Запаять все остальные разъемы

# и сокеты: «интерфейсные» разъёмы (IDC-xx/ BLD-xx), краевые разъемы шины NemoBUS(SL-62), разъем ATX-питания

и сокет под память SIMM30(если необходимо).

11. Сделать все необходимые доп. соединения шлейфами, либо отдельными проводками, с обратной стороны платы (например, порт атрибутов #FF, модуль интерфейса Sinclair-джойстиков и нек. другие).
12. Внимательно осмотреть плату и сравнить её с монтажными и принципиальной схемами на предмет соответствия. При необходимости доустановить недостающие компоненты/убрать «лишние» (если какая-то «опция» Вам не нужна, например).
13. Аккуратно почистить и промыть плату от остатков канифоли. Можно это делать ватными палочками, смоченными в спирту. Не допускайте протекания спирта на контакты панелек и разъемов, а так же сокета SIMM30!
14. Визуально внимательно осмотреть плату на просвет и под увеличительным стеклом на предмет «дефектов пайки» -«соплей», непропаев и т.д.

ВНИМАНИЕ! Не допускайте попадания следов канифоли (затекания жидких флюсов) на контакты панелек и

# разъемов, а так же сокета SIMM30!

# Удачной сборки и приятной работы!
