z00m128/kay1024/schematic-diagram/nemo_ide_assembly_instructions.pdf

HDD/CD | NEMO IDE контроллер 100n 3333 | 820 | 820

# Монтажные схемы

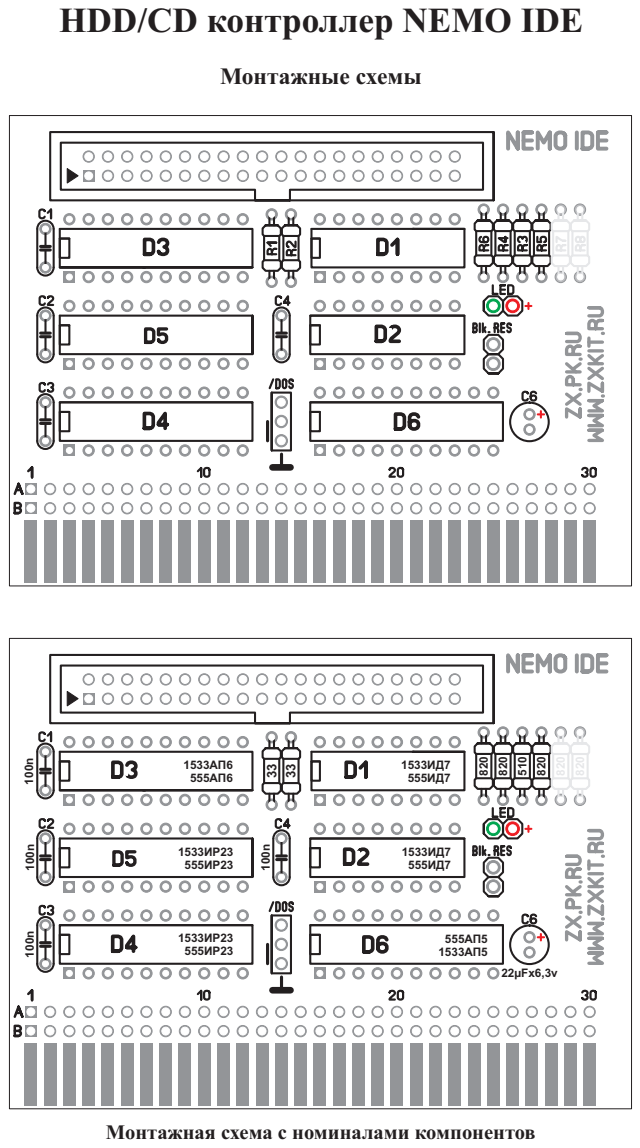
[picture p52: page 1]
22μFx6,3v

Монтажная схема с номиналами компонентов
