z00m128/kay1024/schematic-diagram/nemo_ide_schematic.pdf

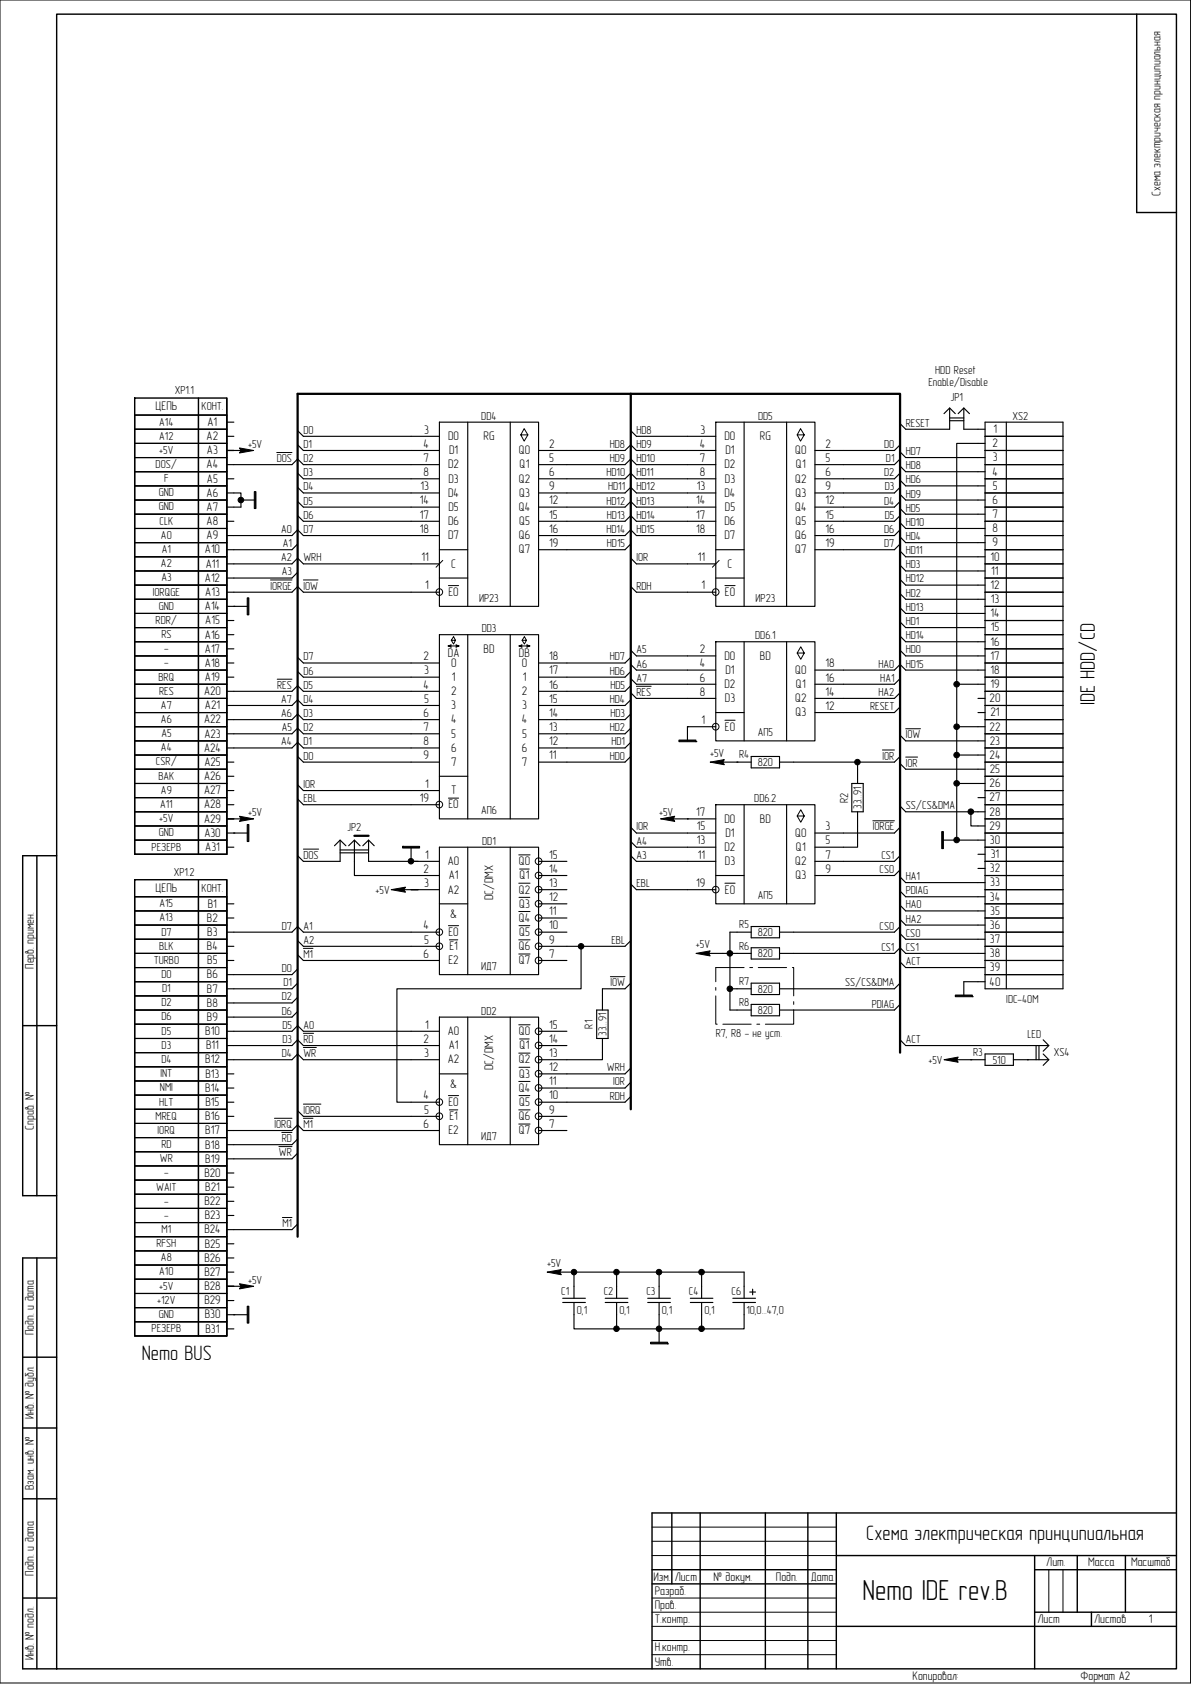
[picture p53: page 1]

Ñõåìà ýëåêòðè÷åñêàÿ ïðèíöèïèàëüíàÿ

HDD Reset Enable/Disable XP1.1

A14 | A1
A12 | A2
+5V | A3
DOS/F | A4

GND | A6
GND | A7
CLK | A8
A0 | A9
A1 | A10
A2 | A11
A3 | A12
IORQGE | A13
GND | A14
RDR/ | A15
RS-- | A17

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
BRQ | A19
RES | A20
A7 | A21
A6 | A22
A5 | A23
A4 | A24
CSR/ | A25
BAK | A26
A9 | A27
A11 | A28
+5V | A29
GND | A30
ÐÅÇÅÐÂ | A31

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
A15 | B1
A13 | B2

Èíâ. ¹ ïîäë. Ïîäï. è äàòà Âçàì. èíâ. ¹ Èíâ. ¹ äóáë. Ïîäï. è äàòà Ñïðàâ. ¹ Ïåðâ. ïðèìåí.

BLK | B4
TURBO | B5
D0 | B6
D1 | B7
D2 | B8
D6 | B9
D5 | B10
D3 | B11

INT | B13
NMI | B14
HLT | B15
MREQ | B16
IORQ | B17
RD | B18
WR- | B19

B20
B21

WAIT -- | B22

M1 | B24
RFSH | B25
A8 | B26
A10 | B27
+5V | B28
+12V | B29
GND | B30
ÐÅÇÅÐÂ | B31

Èçì. | Ëèñò | ¹ äîêóì. | Ïîäï. | Äàòà
Ðàçðàá.
Ïðîâ.
Ò.êîíòð.

Í.êîíòð.
