z00m128/kay1024/schematic-diagram/kay1024_simm30_pin.pdf

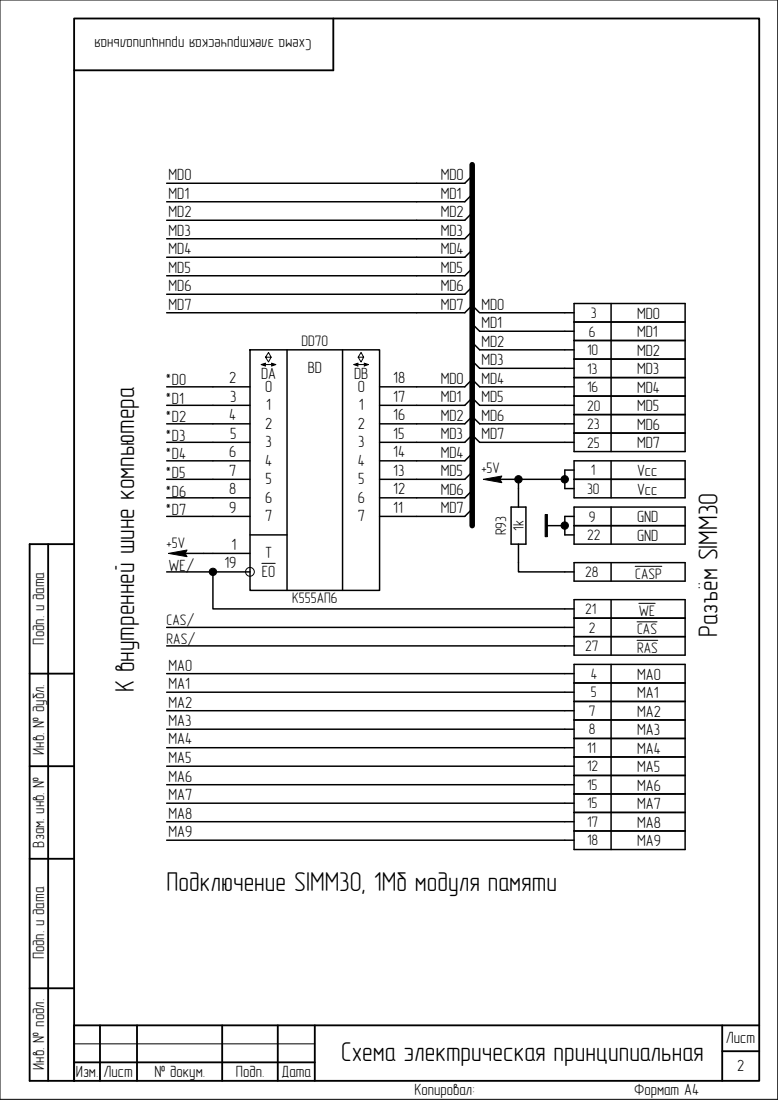
[picture p54: page 1]
Ñõåìà ýëåêòðè÷åñêàÿ ïðèíöèïèàëüíàÿ Èçì.; Ëèñò; ¹ äîêóì.; Ïîäï.; Äàòà; Êîïèðîâàë:; Ôîðìàò À4; CAS/ RAS/; CASP; Ðàçú¸ì SIMM30; Ïîäêëþ÷åíèå SIMM30, 1Ìá ìîäóëÿ ïàìÿòè

6 | MD1
10 | MD2
13 | MD3
16 | MD4
20 | MD5
23 | MD6

Ê âíóòðåííåé øèíå êîìïüþòåðà

1 | Vcc
30 | Vcc

9 | GND
22 | GND

Èíâ. ¹ ïîäë. Ïîäï. è äàòà Âçàì. èíâ. ¹ Èíâ. ¹ äóáë. Ïîäï. è äàòà

21 | WE
2 | CAS
27 | RAS
4 | MA0
5 | MA1
7 | MA2
8 | MA3
11 | MA4
12 | MA5
15 | MA6
15 | MA7
17 | MA8
18 | MA9
