z00m128/kay1024/schematic-diagram/kay1024_v2010_schematic.pdf

# CPU

Z80A

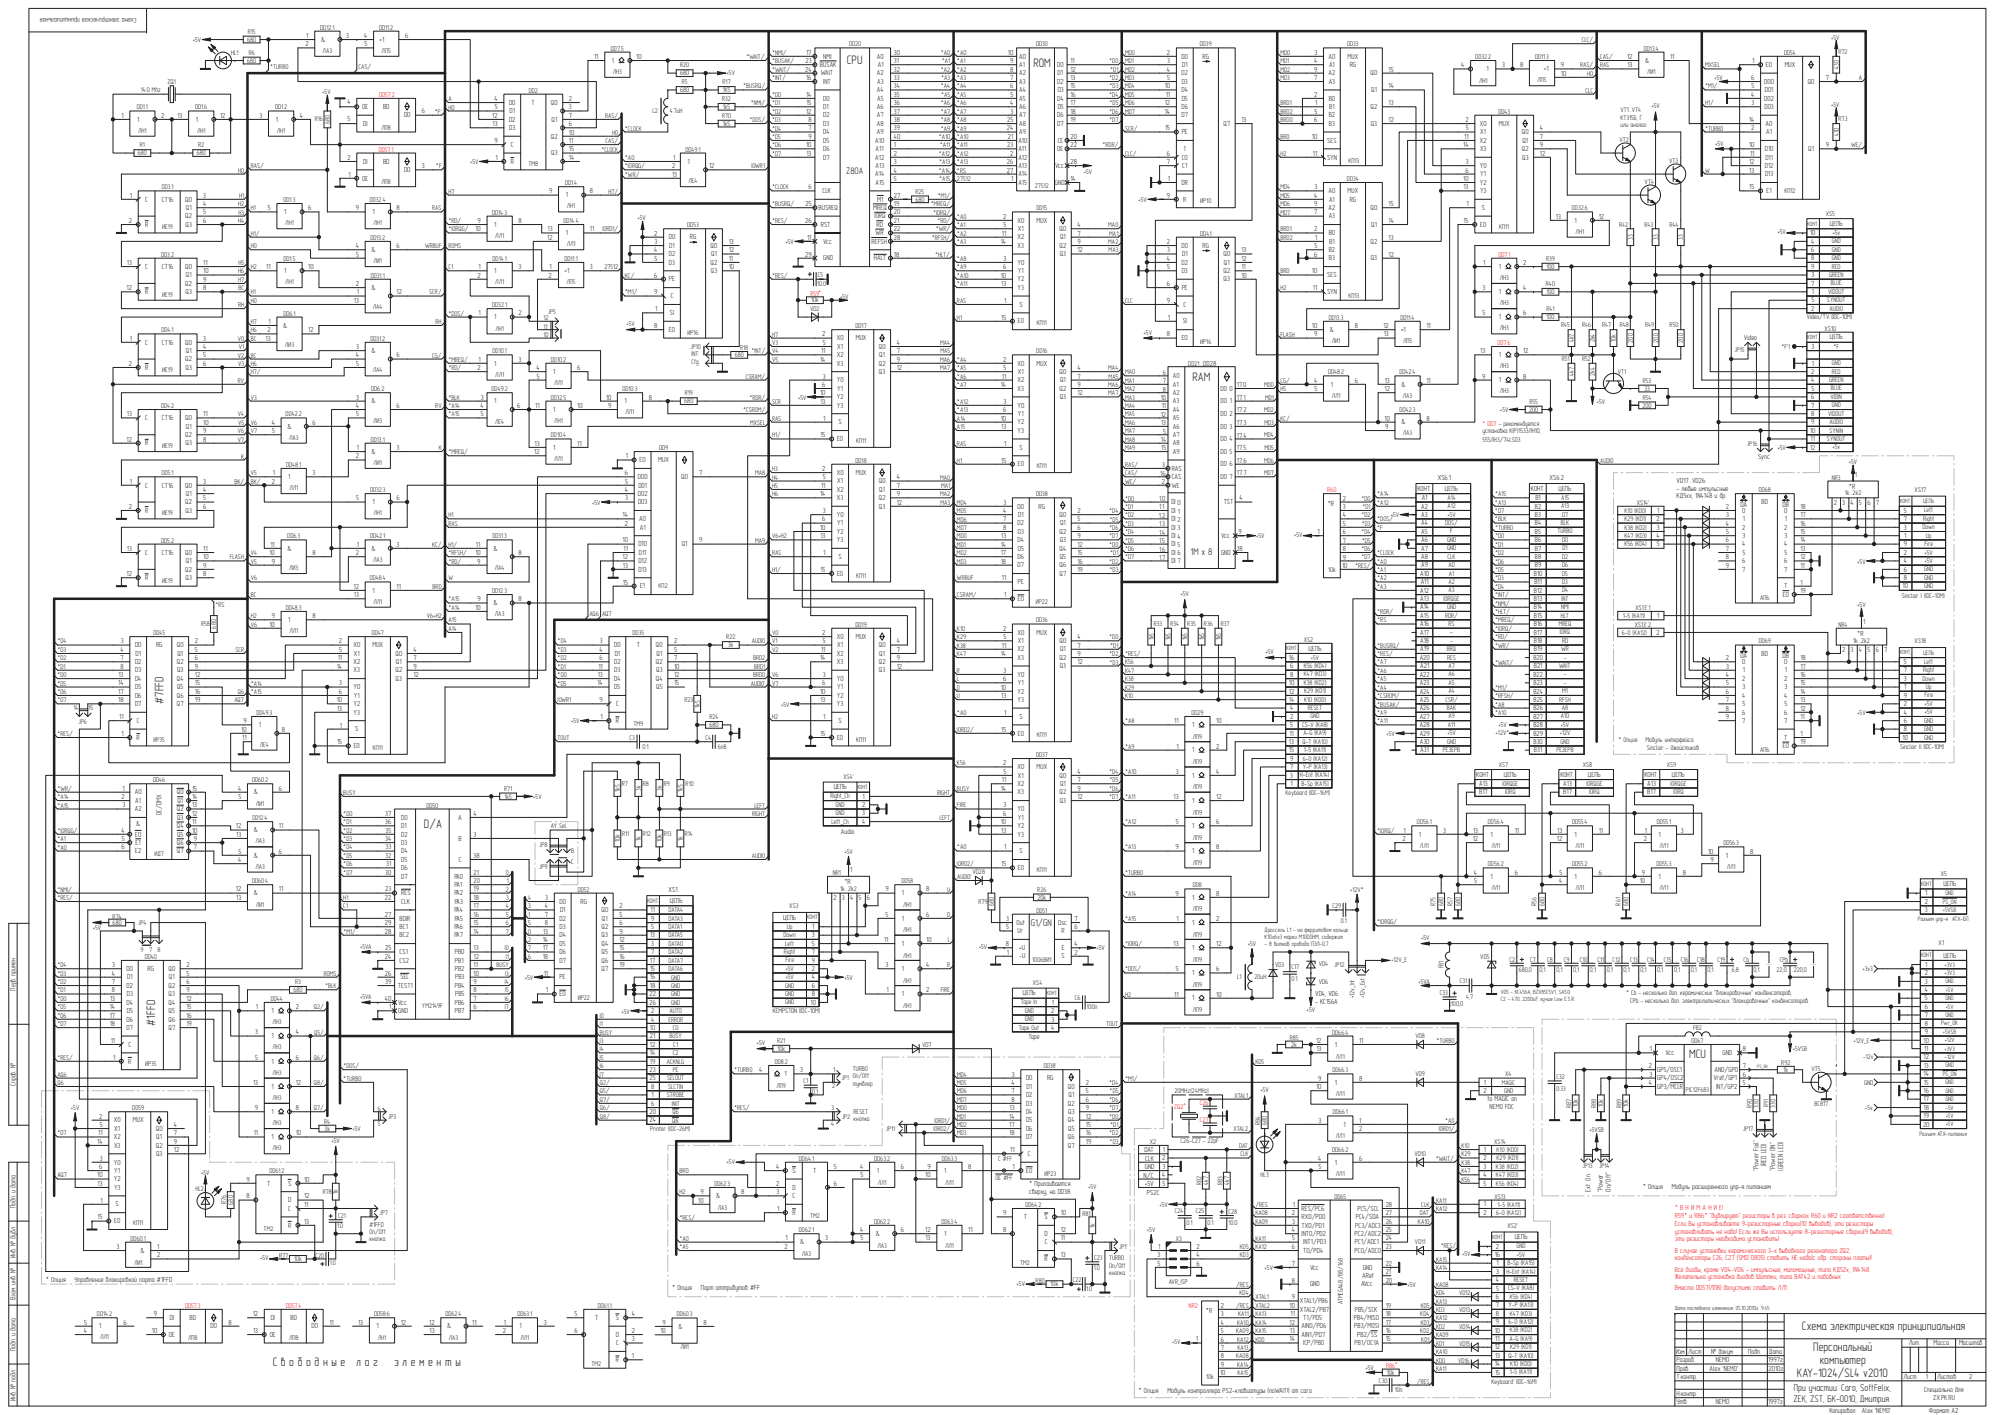
[picture p55: page 1]

1 | Up
9 | Fire

9 | 6-0 (KA12)
7 | Y-P (KA13)
3 | H-Ent (KA14)

GND | 3
Left_Ch | 4

Дроссель L1 - на ферритовом кольце
К10х6х3 марки М1000НМ, содержит
~ 8 витков провода ПЭЛ-0,7.

Инв. № подл. Подп. и дата Взам. инв. № Инв. № дубл. Подп. и дата Справ. № Перв. примен.

* Cb - несколько доп. керамических "блокировочных" конденсаторов,
CPb - несколько доп. электролитических "блокировочных" конденсаторов.

5 | GND
6 | +5V
7 | GND
8 | Pwr_OK
9 | +5VSB
10 | +12V

21 | BUSY | Tape
12 | C1
14 | C2
19 | ACKNLG

12 | -12V
13 | GND

25 | SELOUT
8 | SLCTIN
1 | STROBE
6 | INIT

20 | Q6
24 | Q8

Разъем ATX-питания Printer (IDC-26M)

R59* и R86* "дублируют" резисторы в рез. сборках R60 и NR2 соответственно!
Если Вы устанавливаете 9-резисторные сборки(10 выводов), эти резисторы
устанавливать не надо! Если же Вы используете 8-резисторные сборки(9 выводов),

эти резисторы необходимо установить!
В случае установки керамического 3-х выводного резонатора ZQ2,
конденсаторы С26, С27 (SMD 0805) ставить НЕ надо(с обр. стороны платы)!
Все диоды, кроме VD4-VD6 - импульсные, маломощные, типа КД52х, 1N4148.
Желательна установка диодов Шоттки, типа BAT42 и подобных.
Вместо DD57(ЛП8) допустимо ставить ЛЛ1.

4 | RESET
5 | CS-V (KA8)
6 | K56 (KD4)

Изм. | Лист | № докум. | Подп. | Дата
Разраб. | | NEMO | | 1997г
Пров. | | Alex 'NEMO' | | 2010г
Т.контр.

Н.контр.

При участии: Caro, SoftFelix,
ZEK, ZST, БК-0010, Дмитрия.
