z00m128/kay1024/schematic-diagram/kay1024_v2018_schematic.pdf

# CPU

30 A0 | 31 A1 | 32 A2 | 33 A3 | 34 A4 | 35 A5 | 36 A6 | 37 A7 | 38 A8 | 39 A9 | 40 A10

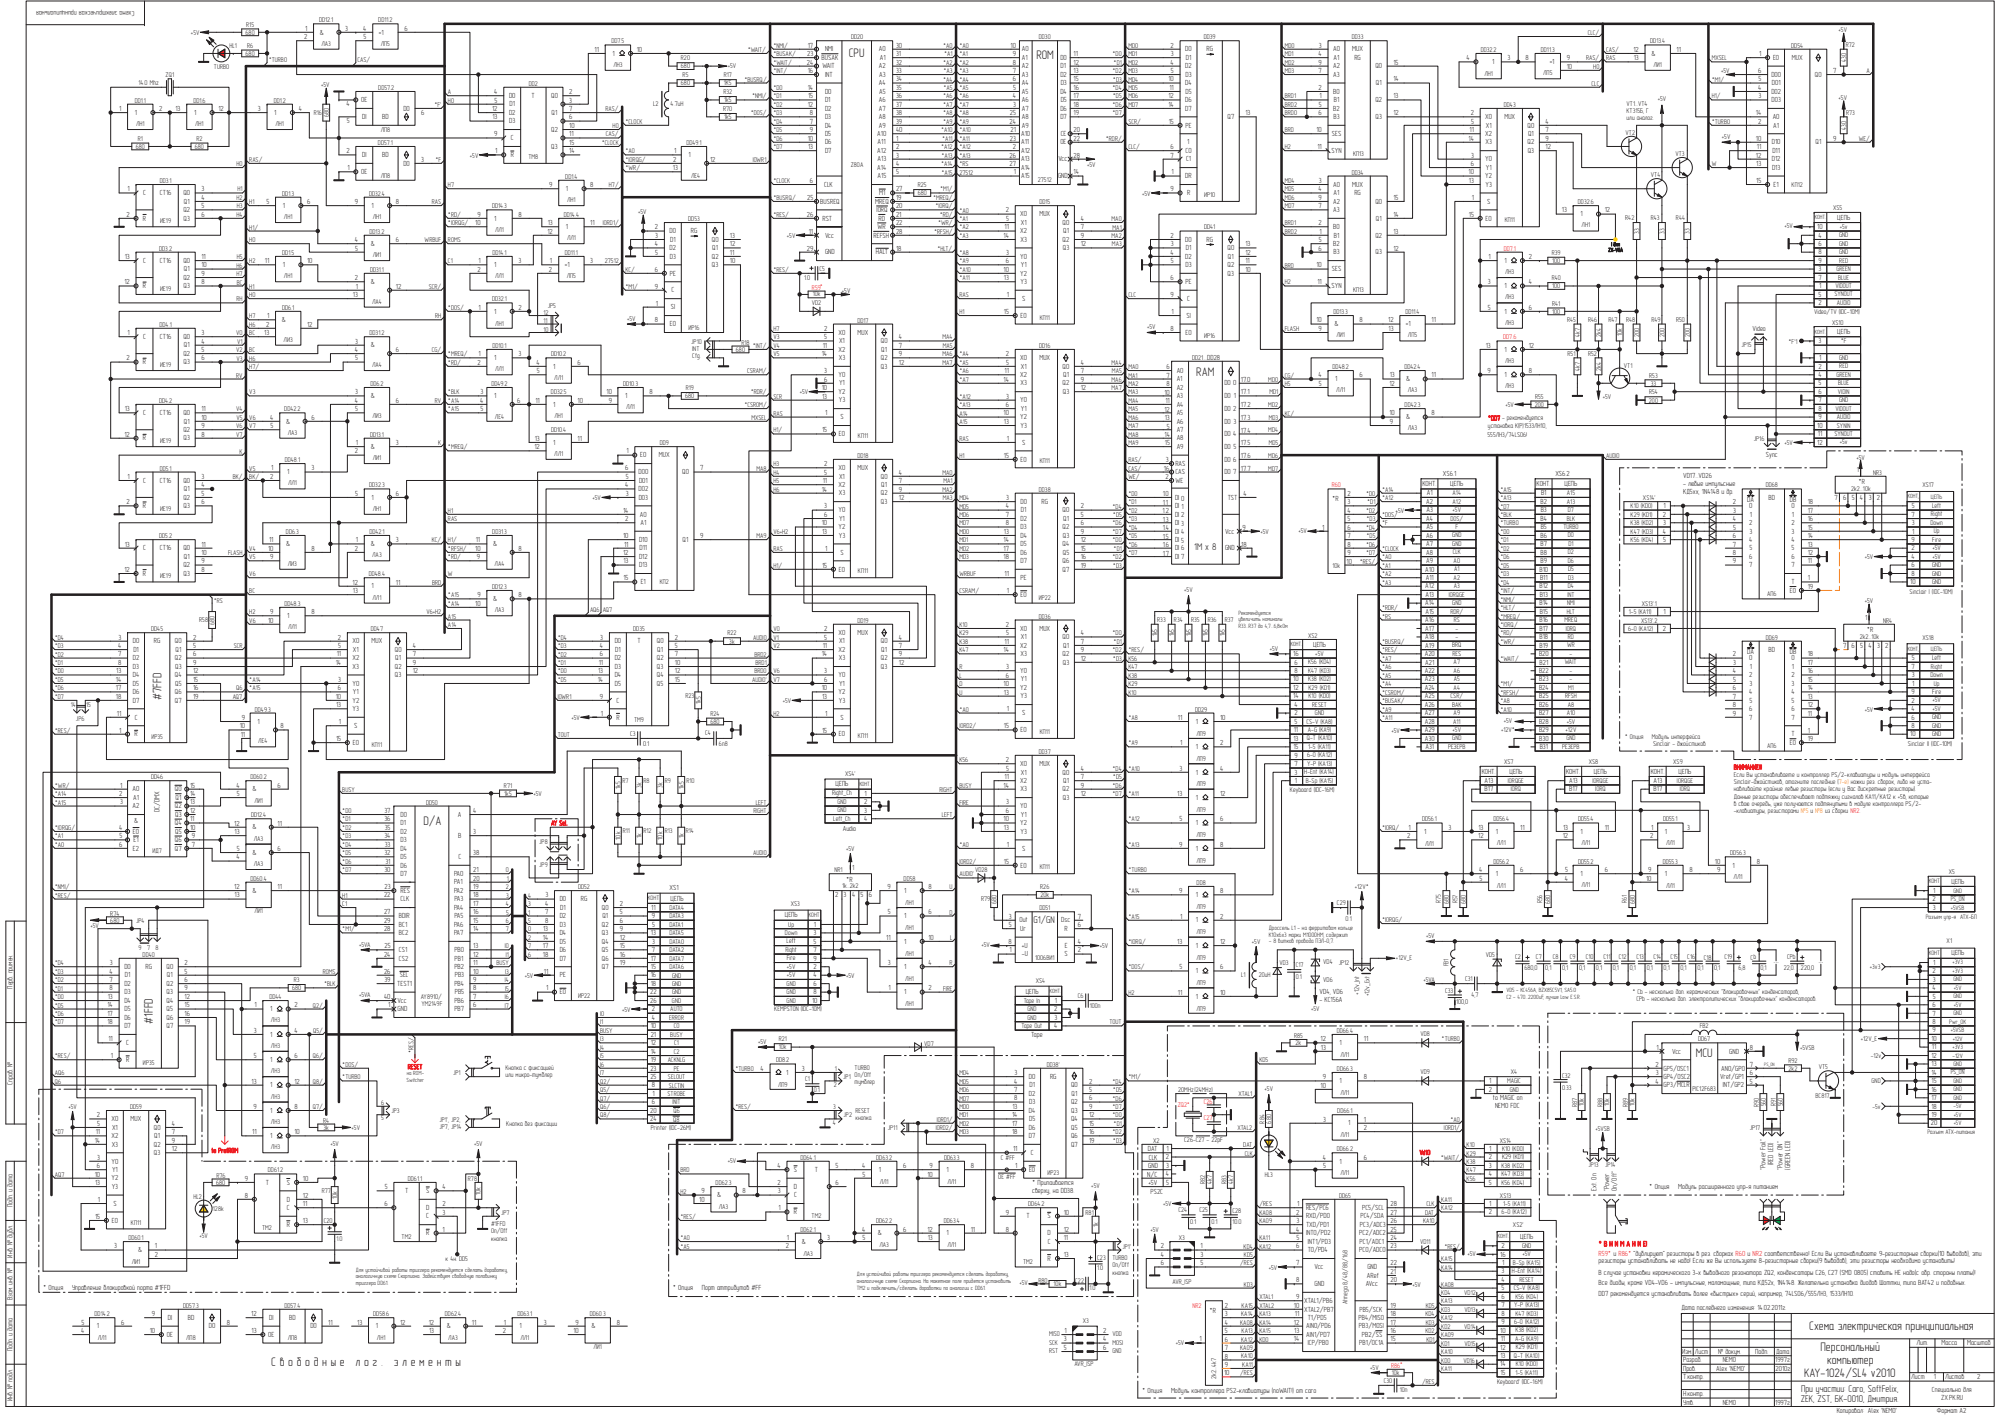
[picture p56: page 1]

4 | GND

1 | GND
2 | RED
4 | GREEN

9 | AUDIO
10 | SYNIN
11 | SYNOUT
12 | +5v

1 | Up
9 | Fire

9 | 6-0 (KA12)
7 | Y-P (KA13)
3 | H-Ent (KA14)

ВНИМАНИЕ!!!
Если Вы устанавливаете и контроллер PS/2-клавиатуры и модуль интерфейса
навливайте крайние левые резисторы (если у Вас дискретные резисторы).
Данные резисторы обеспечивают подтяжку сигналов KA11/KA12 к +5в, которые

в свою очередь, уже получаются подтянутыми в модуле контроллера PS/2-

GND | 3
Left_Ch | 4

Дроссель L1 - на ферритовом кольце
К10х6х3 марки М1000НМ, содержит
~ 8 витков провода ПЭЛ-0,7.

Инв. № подл. Подп. и дата Взам. инв. № Инв. № дубл. Подп. и дата Справ. № Перв. примен.

* Cb - несколько доп. керамических "блокировочных" конденсаторов,
CPb - несколько доп. электролитических "блокировочных" конденсаторов.

5 | GND
6 | +5V
7 | GND
8 | Pwr_OK
9 | +5VSB

21 | BUSY | Tape
12 | C1
14 | C2
19 | ACKNLG

12 | -12V
13 | GND
14 | PS_ON

25 | SELOUT
8 | SLCTIN
1 | STROBE

6 | INIT
20 | Q6
24 | Q8

Разъем ATX-питания Printer (IDC-26M)

2 | GND

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

Для устойчивой работы триггера рекомендуется сделать доработку,
аналогичную схеме Скорпиона. Задействуем свободную половинку
триггера DD61.

4 | RESET
5 | CS-V (KA8)
6 | K56 (KD4)

аналогичную схеме Скорпиона. На макетное поле придется установить
ТМ2 и подключить/сделать доработки по аналогии с DD61.

Изм. | Лист | № докум. | Подп. | Дата
Разраб. | | NEMO | | 1997г
Пров. | | Alex 'NEMO' | | 2010г

При участии: Caro, SoftFelix,
ZEK, ZST, БК-0010, Дмитрия.
