z00m128/kay1024/schematic-diagram/kay1024_v2010_fix.pdf

Фрагмент монтажной схемы с доработками.

KAY-1024/SL4/Turbo v2010. Исправления и доработки.

Исправление ошибки разводки | разьема для прошивки микроконтроллера
в модуле контроллера | клавиатуры.

ISP-PS/2 -

По досадной случайности ISP- | PS/2 - разьем Х3 для прошивки микроконтроллера в модуле контроллера
клавиатуры был разведен не верно. На старой версии схемы так же присутствует эта ошибка! Попутаны сигналы с 1 по 3 контакты. Если Вы планируете прошивать и в последствии обновлять прошивку контроллера в плате (ISP-программирование) обязательно проделайте нижеописанную процедуру:
Режем дороги, подходящие к 1, 2 и 3 ногам ISP-разъёма (в обоих слоях - внимательно смотрим фрагменты принципиальной схемы и монтажки ниже на странице), берем "любимый провод - МГТФ" и кидаем "сопли":
* с 19 ноги DD65 (SCK) на 3 ногу ISP6PIN (сейчас оно на 2-й ноге);
* с 18 ноги DD65 (MISO) на 1 ногу ISP6PIN (сейчас оно на 3-й ноге);
* на 2 ногу ISP6PIN подаем +5в с любой ближайшей точки, например, с 20 ноги DD65 или 8 ноги DD53 или с контакта А3 разъёма XS7.

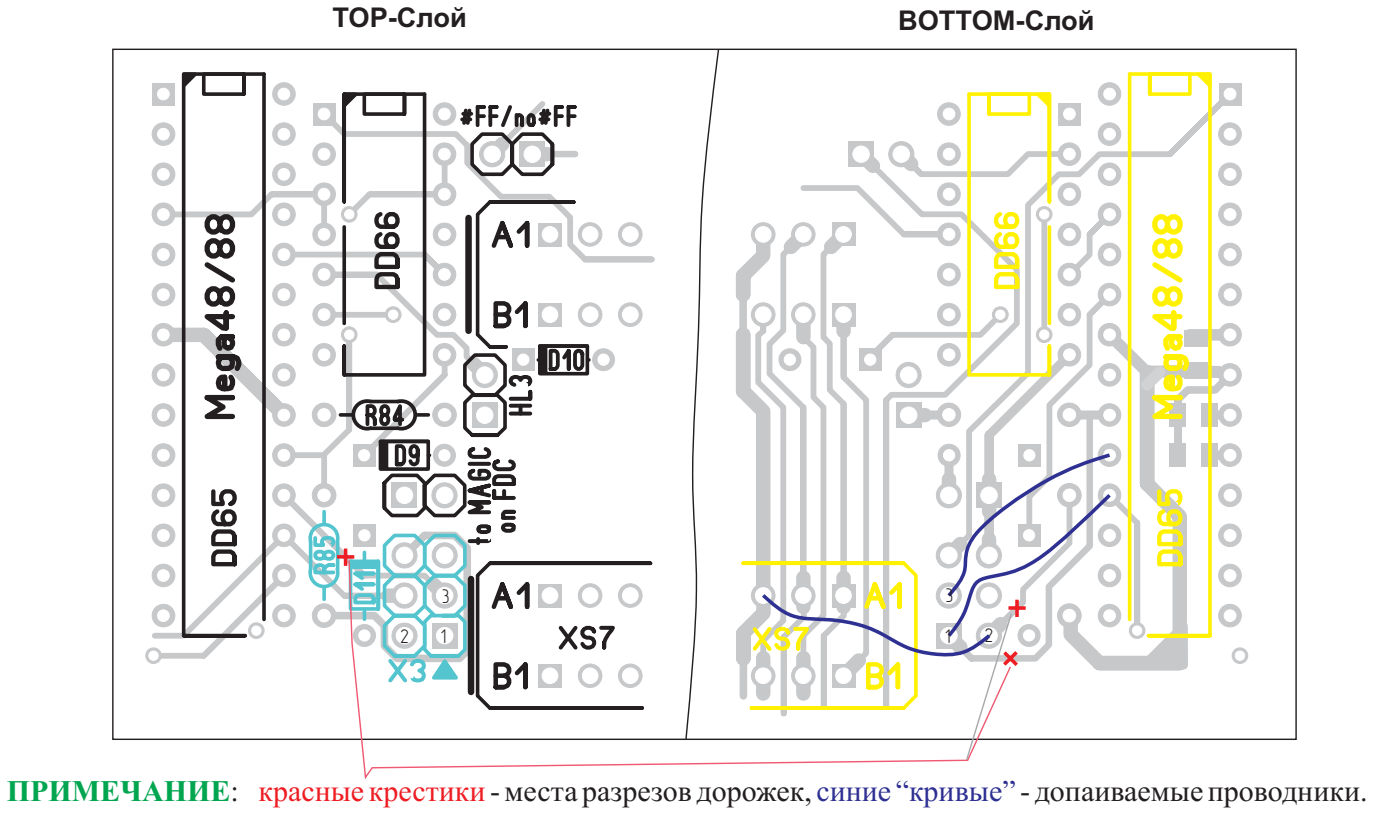
[picture p57: figure]
TOP-Слой; BOTTOM Слой -; ПРИМЕЧАНИЕ:; - места разрезов дорожек,; - допаиваемые проводники.; красные крестики; синие “кривые”

После вышеописанной процедуры настоятельно рекомендуется проверить результат проделанной работы прозвонить мультиметром и сравнить его с принципиальной схемой(1-й лист), при этом схема должна
быть датирована не ранее 18.12.2010г.! Там дана “распиновка “ этого разъема по стандарту | И
на”новой” схеме уже указана именно правильная разводка Х3.
( | )
Atmel ISP6PIN.

AVR_ISP

X3

2 | 1
4 | 3
6 | 5

+5V

/RES

KD4

KD5

KD3 AVR_ISP

X3
1 | 2
3 | 4
5 | 6

+5V

KD5

KD3

KD4

/RES

Исправляем ошибку разводки ISP-разъема для Меги48/88 путем резки 3-х дорожек и припайке 3-х проводков.

Фрагмент принципиальной схемы с доработками.

KAY-1024/SL4/Turbo v2010. Исправления и доработки.

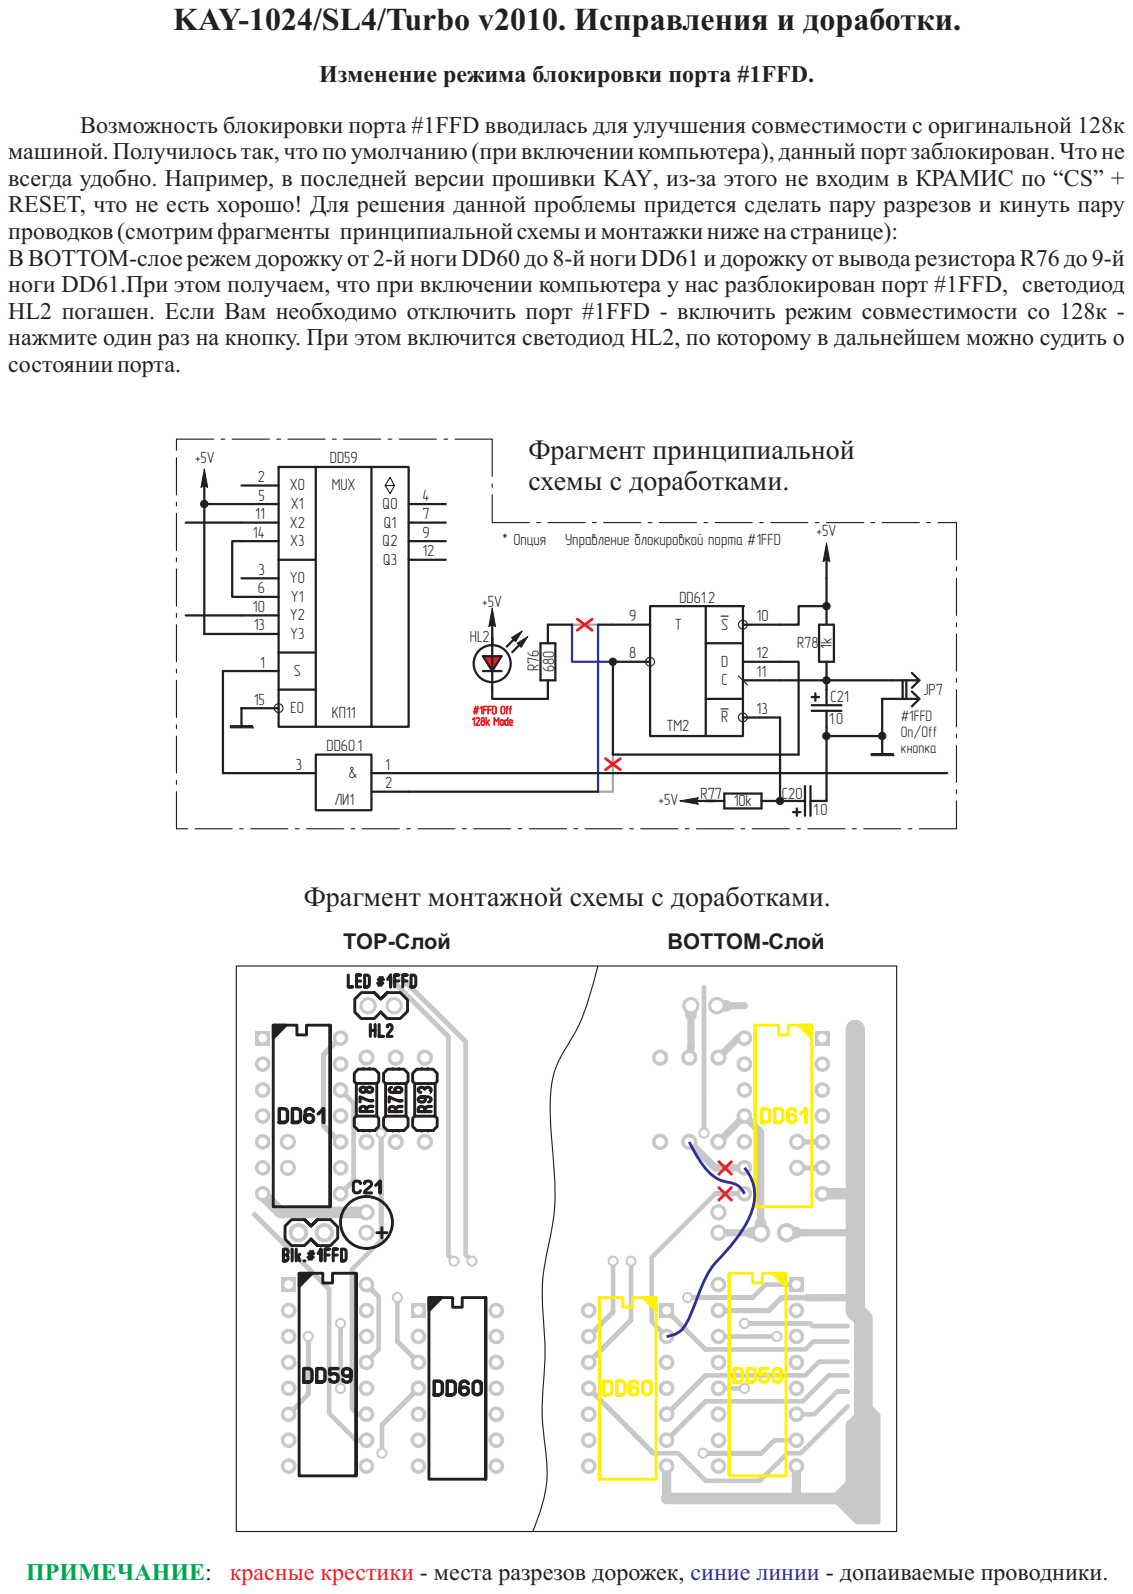
[picture p58: page 2]

Изменение режима блокировки порта #1FFD.

машиной. Получилось так, что по умолчанию (при включении компьютера), данный порт заблокирован. Что не
RESET, что не есть хорошо! Для решения данной проблемы придется сделать пару разрезов и кинуть пару
состоянии порта.

принципиальной схемы и монтажки ниже на странице

Фрагмент монтажной схемы с доработками.
