z00m128/kay1024/schematic-diagram/nemo_fdd_assembly_instructions.pdf

К | ода | ( | ) онтроллер дисков | BETA-TURBO NEMO FDC .

## Монтажные схемы

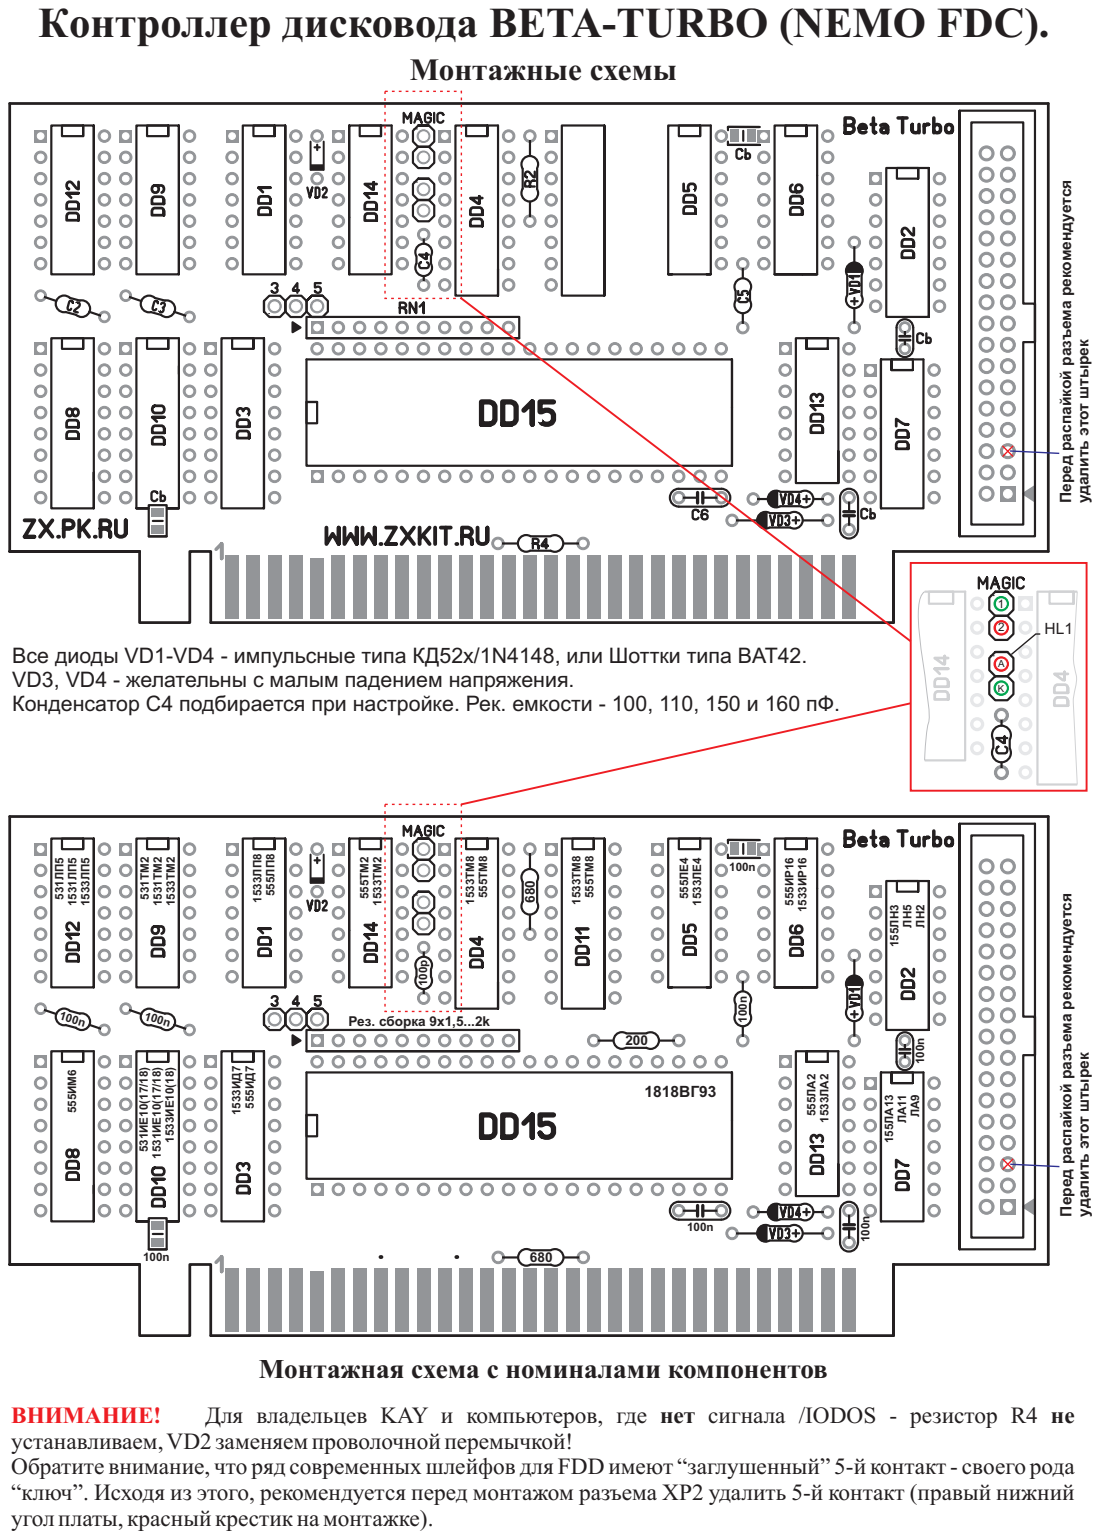
[picture p59: page 1]
Рез. сборка 9х1,5...2k; Все диоды VD1-VD4 - импульсные типа КД52х/; или Шоттки типа BAT42.; ВНИМАНИЕ!; Для владельцев; и компьютеров, где; сигнала /; резистор; Обратите внимание, что ряд современных шлейфов для; имеют “заглушенный” 5-й контакт - своего рода; “ключ”. Исходя из этого, рекомендуется перед монтажом разъема; удалить 5-й контакт (правый нижний; KAY; IODOS -; FDD; нет

Перед распайкой разъема рекомендуется

удалить этот штырек

VD3, VD4 - желательны с малым падением напряжения.
Конденсатор С4 подбирается при настройке. Рек. емкости - 100, 110, 150 и 160 пФ.

Монтажная схема с номиналами компонентов

устанавливаем, VD2 заменяем проволочной перемычкой!
угол платы, красный крестик на монтажке).

К | ода | ( | ) онтроллер дисков | BETA-TURBO NEMO FDC .

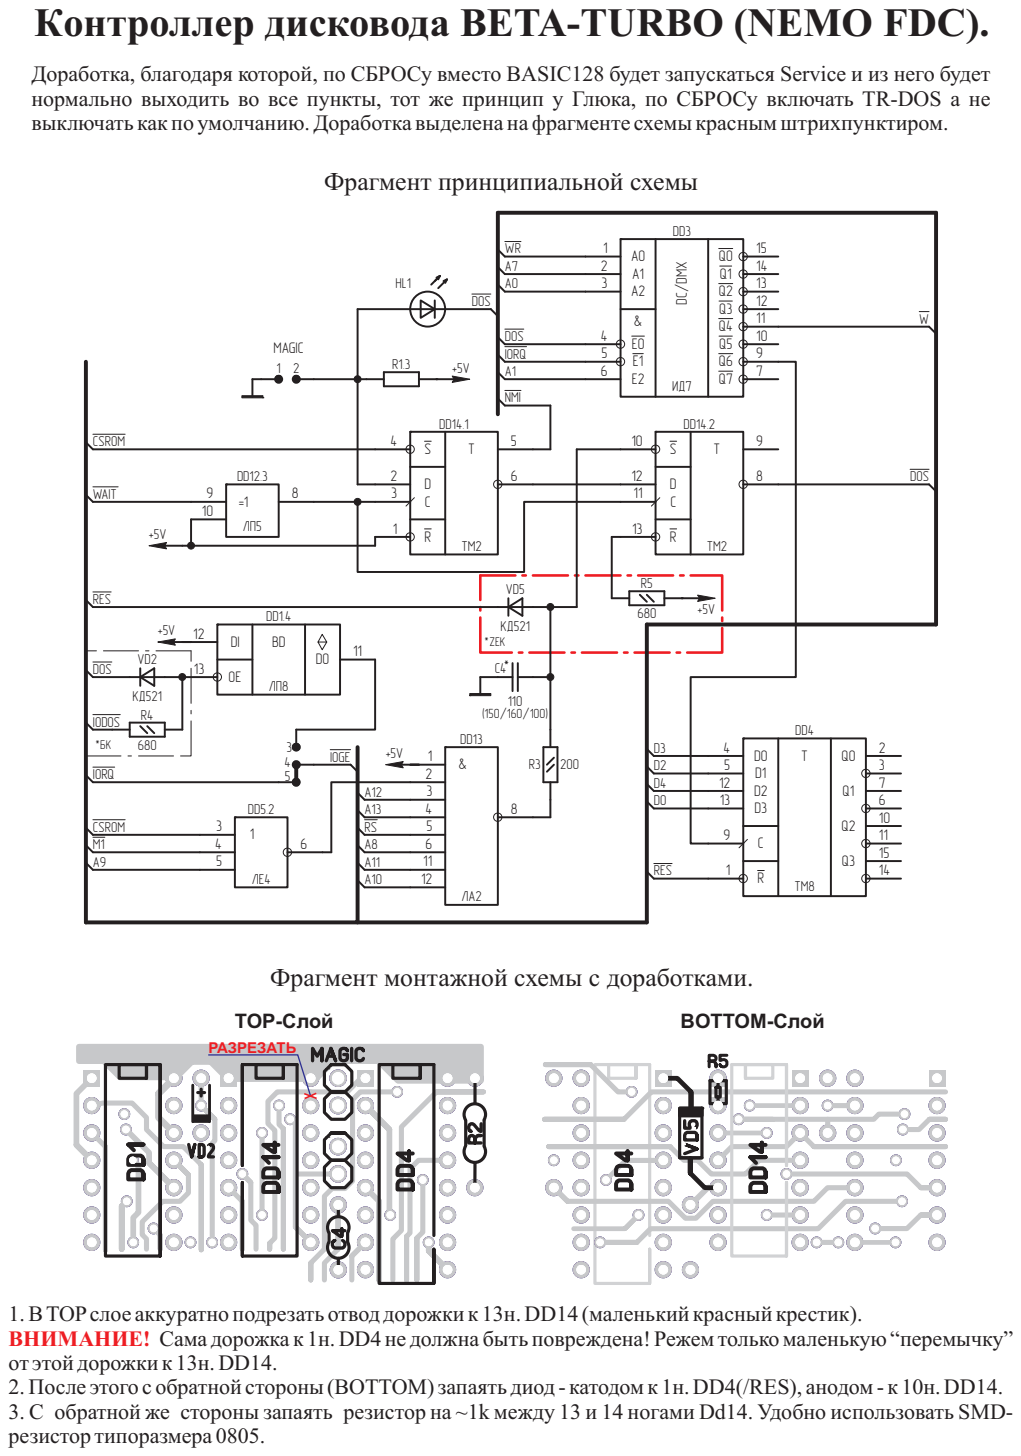
[picture p60: page 2]

выключать как по умолчанию. Доработка выделена на фрагменте схемы красным штрихпунктиром.

Фрагмент монтажной схемы с доработками.

1. В TOP слое аккуратно подрезать отвод дорожки к 13н. DD14 (маленький красный крестик).
ВНИМАНИЕ!
резистор типоразмера 0805.
