z00m128/kay1024/schematic-diagram/nemo_fdd_schematic.pdf

# В Н И М А Н И Е ! ! !

## Данная схема перерисована с учетом требований ЕСКД! Т.е. ряд секций

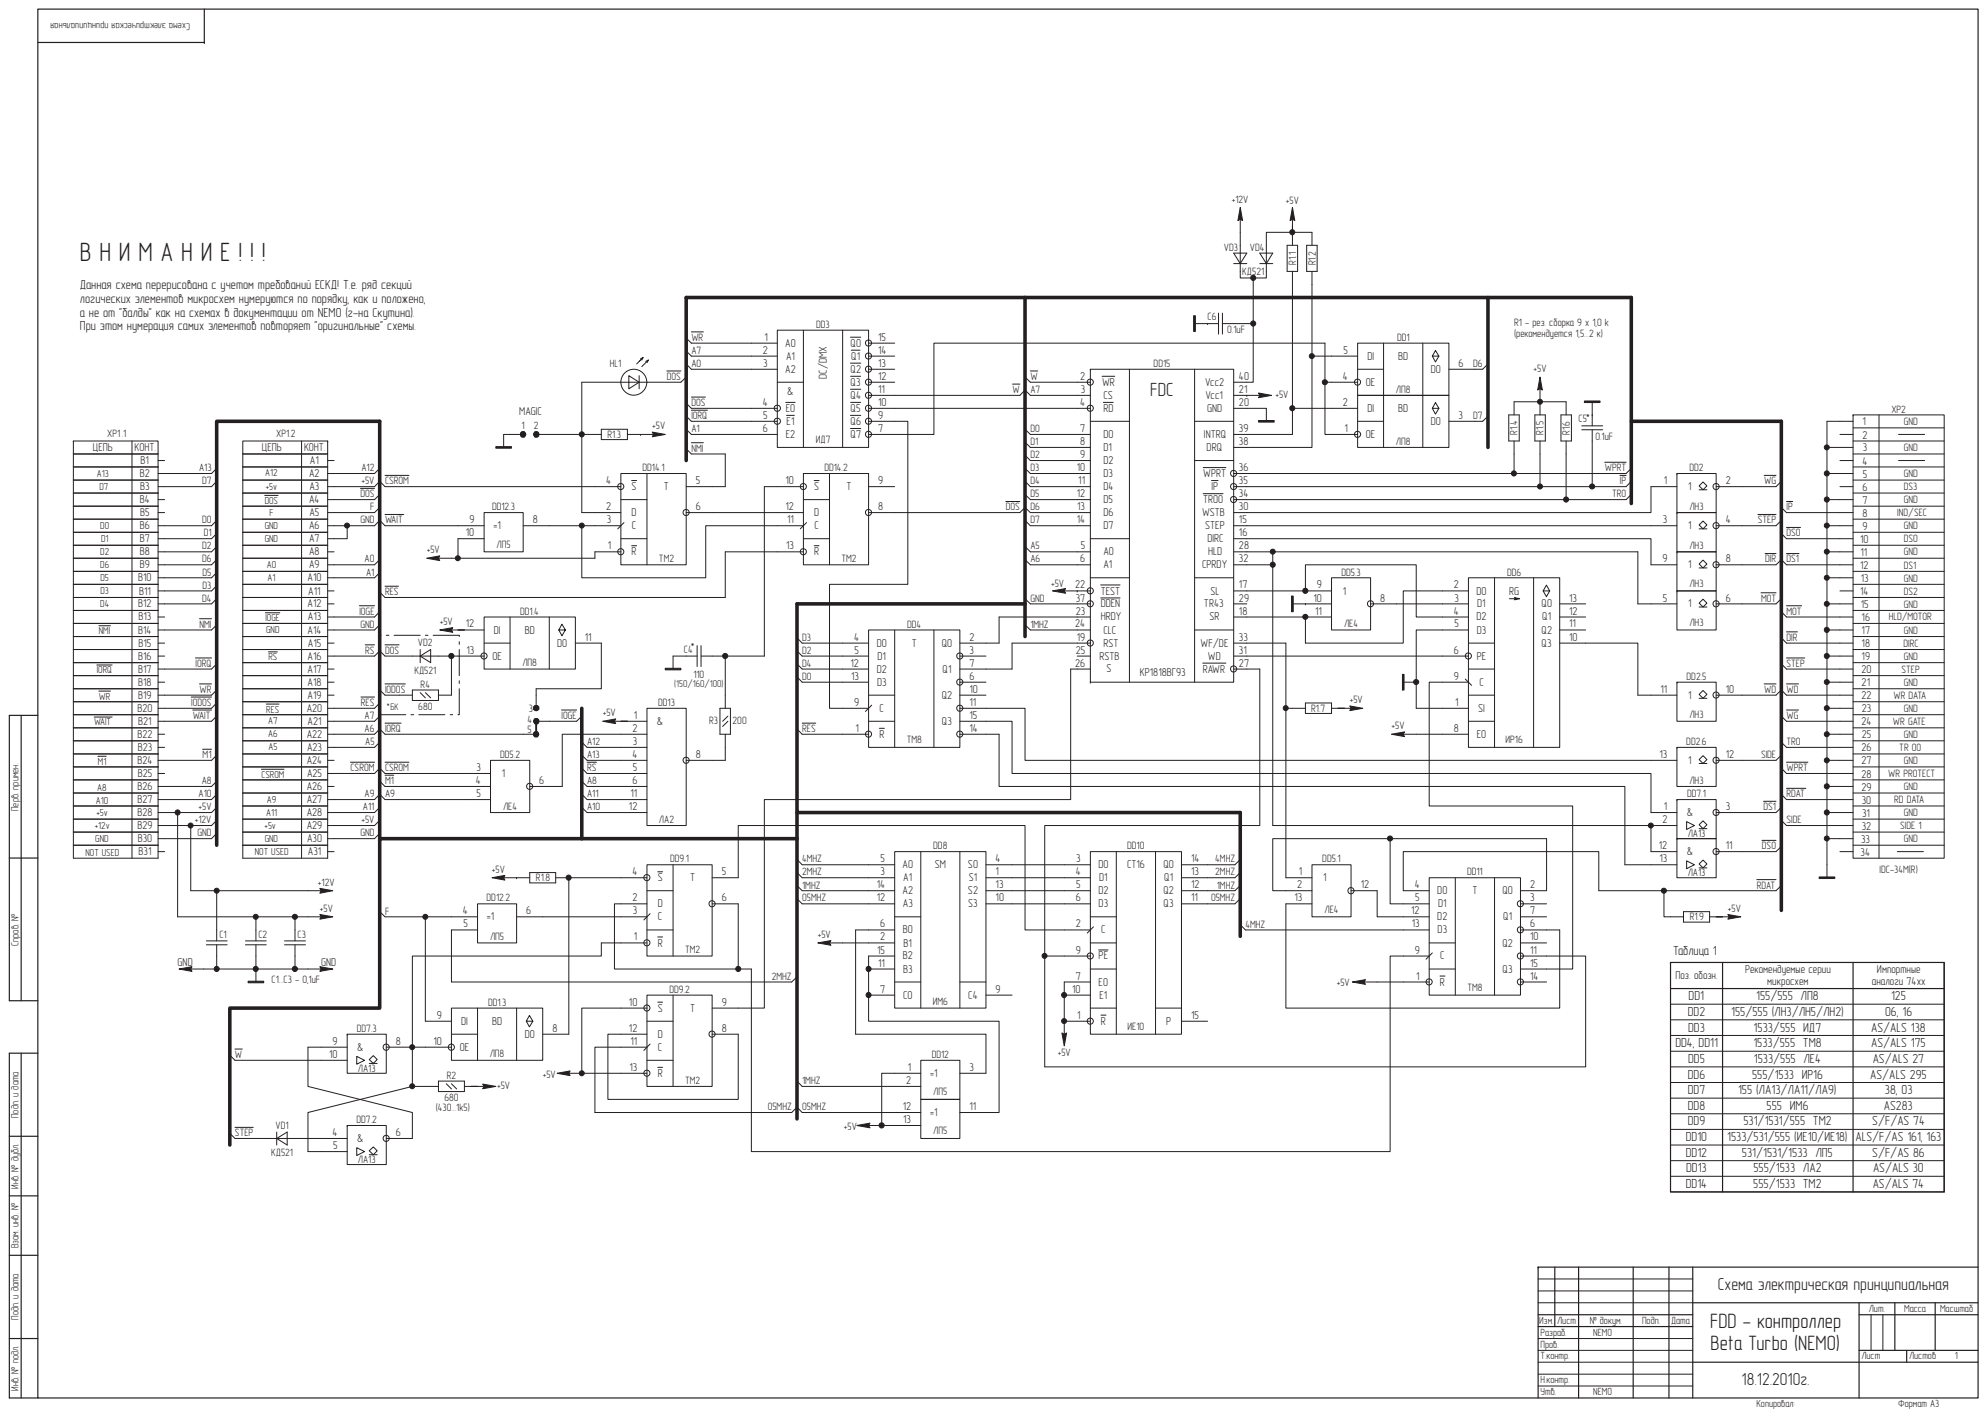
[picture p61: page 1]

логических элементов микросхем нумеруются по порядку, как и положено,
а не от "балды" как на схемах в документации от NEMO (г-на Скутина).
При этом нумерация самих элементов повторяет "оригинальные" схемы.

Инв. № подл. Подп. и дата Взам. инв. № Инв. № дубл. Подп. и дата Справ. № Перв. примен.

Изм. | Лист | № докум. | Подп. | Дата
Разраб. | | NEMO
Пров.
Т.контр.

Н.контр.
