z00m128/kay1024/(list of files, drawings)

Other design files:
firmware/power-manager/original/kay_pm.dsn
pcb/kay256.lay6
pcb/kay1024.lay6
pcb/kay1024v2010.lay6
