z00m128/kay1024/(commit log)

2023-03-02 Firmware: KAY power manager firmware added.
    [kay_pm.dsn, pm683.cfg]
2023-03-02 Docs: schematic diagrams and manuals added
2023-03-02 Docs: added Nemo FDD & Nemo IDE schematics.
2023-09-24 PCB resources added.
    [kay1024.lay6, kay1024v2010.lay6, kay256.lay6]
